oscarmattia/ihp-experiments/circuits/ctle56n/ctle_report.md

# 56 Gb/s NRZ CML CTLE — design report

Auto-generated by `python/generate_reports.py` — do not hand-edit numbers.

## Topology

CML continuous-time linear equalizer (CTLE) for **56 Gb/s NRZ** (Nyquist **28 GHz**).
HBT differential pair (`npn13G2`) with **shunt-peaked loads** (R_D + ideal L from VDD),
**emitter degeneration** (R_s + C_s), and an **LV NMOS tail** with 1:1 diode-connected mirror.

Sizing uses characterization LUTs (`char/bjt`, `char/mos`, `char/passive`) at max-f_T HBT bias.
Load C_L = Miller-aware FO1 VGA input + interconnect (not raw LUT CIN; coil port C excluded).
Bessel shunt-peaking **m = L/(R_D² C_L) ≈ 0.32**.

The drain inductor **L = 81.37 pH** (8.13693e-11 H) is physically tiny (via / short-trace scale).
No PDK spiral is used — minimum EM cell `l2n0` is ~2 nH, far too large. L remains **ideal** in ngspice.

## Targets

- DC gain **−6 … 0 dB** (aim 0 dB)
- Peaking **3–10 dB at 28 GHz**
- CMRR **> 6 dB**, PSRR **> 20 dB** at low frequency
- Transient stimulus: **PRBS9** (x^9+x^5+1), **511 UI** (one full period), **100 mVpp,diff**, ~4.5 ps edges. AC sweep **1 MHz–300 GHz**. CMRR **> 6 dB**, PSRR **> 20 dB**.

## Sizing summary

| Parameter | Symbol | Ideal | PDK | Notes |
| --- | --- | --- | --- | --- |
| Emitter multiplier | Nx | 1 | 1 | HBT LUT index |
| HBT VBE (LUT) | VBE | 0.950 V | 0.950 V | max-fT bias |
| Input common-mode | VBASE | 1.396 V | 1.396 V | inp/inn DC |
| Supply | VDD | 1.600 V | 1.600 V | below BVceo ~1.6 V |
| HBT collector current | Ic | 2.888 mA | 2.888 mA | per side |
| Tail current | I_tail | 2.878 mA | 2.878 mA | Ic per tail (×2 devices) |
| Transition frequency | f_T | 348.80 GHz | 348.80 GHz | LUT at bias |
| Transconductance | g_m | 28.51 mS | 28.51 mS |  |
| Input capacitance | C_in | 10.36 fF | 10.36 fF | HBT CIN |
| Load capacitance | C_L | 33.59 fF | 33.59 fF | Miller + route (no coil port C) |
| Load resistor | R_D | 87.0 Ω | 5.0×1.4 µm | shunt peak |
| Emitter degeneration | R_s | 86.6 Ω | 86.6 Ω |  |
| Degeneration cap | C_s | 183.7 fF | 183.7 fF | ideal or MIM |
| Drain inductor | L | 81.37 pH | 81.37 pH | ideal; VDD→L→R_D→collector; no PDK spiral (l2n0 ~2 nH) |
| Bessel MFD | m | 0.32 | 0.32 | L/(R_D² C_L) |
| MOS tail W/L/VGS | W/L/VGS | 243/1.0/0.550 V | 243/1.0/0.550 V | LV NMOS + mirror |
| RPPD load | W/L | ideal R | 5.0×1.4 µm | LUT ≈ R_D/0.88 |
| DC gain | A_v0 | -0.24 dB | -0.24 dB | −6…0 dB target |
| Peaking @ 28 GHz | — | 5.28 dB | 5.00 dB | 3–10 dB target |
| Peak AC gain | G_peak | 5.04 dB | 4.77 dB |  |
| Peak frequency | f_peak | 27.02 GHz | 26.71 GHz |  |
| −3 dB bandwidth | f_{−3dB} | 79.33 GHz | 78.51 GHz | after peak |
| CMRR | — | 23.09 dB | 23.09 dB | > 6 dB |
| PSRR | — | 120.00 dB | 120.00 dB | > 20 dB (clipped 120 dB) |
| HBT VCE | V_CE | 0.910 V | 0.910 V |  |
| MOS tail VDS | V_DS,tail | 0.439 V | 0.439 V |  |

Plots and waveforms: `out/ideal/` (ideal passives) and `out/pdk/` (PDK R/C passives).
Each pass includes AC PNGs/CSVs, transient CSVs, eye PNGs/CSVs, and SBR when `--no-tran` is not set.
Combined metrics: `out/summary.csv`; per-pass: `out/ideal/metrics.csv`, `out/pdk/metrics.csv`.

## Single-bit response

### Ideal

Waveforms: `out/ideal/sbr.png`, `out/ideal/sbr.csv`, `out/ideal/sbr_taps.csv`.

Isolated **1 UI** NRZ pulse (**100 mVpp,diff**, ±50 mV vid), after **32 UI** settle at logic 0.
Sample **3 pre-cursors + cursor + 10 post-cursors** every UI; drop taps with
|h| < **0.5%** of |cursor| (h_0 always kept).

| Tap | k | h (mV) | h / h_0 | Kept |
| --- | --- | --- | --- | --- |
| h_{-3} pre | -3 | 0.000 | -0.0000 | no |
| h_{-2} pre | -2 | 0.000 | -0.0000 | no |
| h_{-1} pre | -1 | 0.000 | -0.0000 | no |
| **h_0 cursor** | 0 | -163.635 | 1.000 | yes |
| h_1 post | 1 | 43.662 | -0.2668 | yes |
| h_2 post | 2 | 13.504 | -0.0825 | yes |
| h_3 post | 3 | 3.238 | -0.0198 | yes |
| h_4 post | 4 | 0.771 | -0.0047 | no |
| h_5 post | 5 | 0.179 | -0.0011 | no |
| h_6 post | 6 | 0.037 | -0.0002 | no |
| h_7 post | 7 | 0.003 | -0.0000 | no |
| h_8 post | 8 | -0.006 | 0.0000 | no |
| h_9 post | 9 | -0.008 | 0.0000 | no |
| h_10 post | 10 | -0.008 | 0.0000 | no |

- Main cursor h_0 = **-163.64 mV** at t = **0.504 UI** after pulse start
- Normalized total ISI = Σ h_k / h_0 = **-0.3691** (k≠0, kept taps only)
- Σ|h_k|/|h_0| = **0.3691** (same taps)
- Taps with |h| < 0.5% of |cursor| are omitted from the ISI sums.

### PDK

Waveforms: `out/pdk/sbr.png`, `out/pdk/sbr.csv`, `out/pdk/sbr_taps.csv`.

Isolated **1 UI** NRZ pulse (**100 mVpp,diff**, ±50 mV vid), after **32 UI** settle at logic 0.
Sample **3 pre-cursors + cursor + 10 post-cursors** every UI; drop taps with
|h| < **0.5%** of |cursor| (h_0 always kept).

| Tap | k | h (mV) | h / h_0 | Kept |
| --- | --- | --- | --- | --- |
| h_{-3} pre | -3 | 0.000 | -0.0000 | no |
| h_{-2} pre | -2 | 0.000 | -0.0000 | no |
| h_{-1} pre | -1 | 0.000 | -0.0000 | no |
| **h_0 cursor** | 0 | -157.975 | 1.000 | yes |
| h_1 post | 1 | 40.611 | -0.2571 | yes |
| h_2 post | 2 | 11.976 | -0.0758 | yes |
| h_3 post | 3 | 2.431 | -0.0154 | yes |
| h_4 post | 4 | 0.492 | -0.0031 | no |
| h_5 post | 5 | 0.097 | -0.0006 | no |
| h_6 post | 6 | 0.015 | -0.0001 | no |
| h_7 post | 7 | -0.002 | 0.0000 | no |
| h_8 post | 8 | -0.006 | 0.0000 | no |
| h_9 post | 9 | -0.007 | 0.0000 | no |
| h_10 post | 10 | -0.007 | 0.0000 | no |

- Main cursor h_0 = **-157.98 mV** at t = **0.504 UI** after pulse start
- Normalized total ISI = Σ h_k / h_0 = **-0.3483** (k≠0, kept taps only)
- Σ|h_k|/|h_0| = **0.3483** (same taps)
- Taps with |h| < 0.5% of |cursor| are omitted from the ISI sums.

## Post-layout comparison

Extracted from the laid-out cell, simulated through the same testbenches as the
schematic because the CTLE is a device-only cell with the same seven pins. Both
flows take their devices from the LVS extraction; only the Magic flow carries
interconnect capacitance.

The lumped output load differs between them **by design**: a netlist that carries
its own extracted routing takes the `CL_MILLER` term only, while one without
parasitics takes the full `CL`, since otherwise the routing is either counted twice
or not at all. Each netlist declares which it needs.

| Metric | Schematic (PDK) | devices only | devices + extracted C |
| --- | --- | --- | --- |
| _lumped output load_ | full CL | full CL | CL_MILLER |
| DC gain | -0.24 dB | -0.24 dB | -0.24 dB |
| Peaking @ 28 GHz | 5.00 dB | 4.93 dB | 5.06 dB |
| Peak gain | 4.77 dB | 4.70 dB | 4.84 dB |
| f_peak | 26.71 GHz | 27.34 GHz | 25.81 GHz |
| f_-3dB | 78.51 GHz | 79.35 GHz | 81.23 GHz |
| CMRR | 23.09 dB | 23.09 dB | 23.09 dB |
| V_CE | 0.910 V | 0.910 V | 0.910 V |
| I_C | 2.888 mA | 2.888 mA | 2.888 mA |

| Flow | Devices | Parasitic C | Kept | Dropped |
| --- | --- | --- | --- | --- |
| `klayout` | 8 | 0 | 0.00 fF | 0.00 fF |
| `magic` | 8 | 31 | 469.42 fF | 3.02 fF |

Extraction gates: LVS against the reduced CDL **match**, capacitance physical **yes**.

Two device kinds are replaced by their compact models rather than extracted: the
inductor, because the PDK has no ngspice model for it and Magic sees the spiral as a
DC short, and the metal-finger capacitor, because the extractor's finger geometry is
not the calibrated model. Their nets are promoted to pins and reconnected outside
the extracted core.

Plots and waveforms: `out/postlayout_klayout/`, `out/postlayout_magic/`, same file names as the schematic passes.
