oscarmattia/ihp-experiments/circuits/ctle56n/driver_report.md

# 56 Gb/s NRZ output pad driver — design report

Auto-generated by `python/generate_reports.py` — do not hand-edit numbers.

## Topology

CML shunt-peaked HBT differential pair driving the output bond pad through on-chip **50 Ω/leg**
back-termination (`rsil`), with pad + ESD capacitance inside the DUT. Single LV NMOS tail,
no emitter degeneration. EM-fitted shunt inductor (`ind_shunt_drv`, case `turn1` ~215 pH) for
Butterworth peaking (**m = 0.414**) to the Magic pad-metal load. CTLE/VGA still share
`ind_shunt` at Bessel **m = 0.32**. Schematic `PAD_C` is Magic in-situ metal only (143.56 fF);
ESD junction C stays in the compact models. Layout GDS coil is the same `turn1`
(d = 120 µm). Magic post-layout zeros `PAD_C` and black-boxes the compact L.

## Targets

- Drive **100 Ω differential** pad with shunt peaking **m ≈ 0.414** (Butterworth; on-chip RD ≈ 50 Ω)
- Pad eye margin vs 56G NRZ (400 mVpp target is gain-starved — see MEMORY.md)
- Transient stimulus: **PRBS9** (x^9+x^5+1), **511 UI** (one full period), **100 mVpp,diff**, ~4.5 ps edges. AC sweep **1 MHz–300 GHz**. CMRR **> 6 dB**, PSRR **> 20 dB**.

## Sizing and measurement summary

| Parameter | Symbol | Value | Notes |
| --- | --- | --- | --- |
| Supply | VDD | 1.600 V |  |
| Input CM | VBASE | 1.350 V | from VGA max-gain CM |
| Emitter multiplier | Nx | 2 | HBT LUT index |
| Tail current | I_tail | 8.0 mA | single MOS tail |
| On-chip back-term | R_D | 50.26 Ω/leg | rsil target 50 Ω |
| AC R_eff (SE) | R_eff | 25.0 Ω | parallel w/ 100 Ω load |
| Shunt inductor | L | 214.90 pH | EM turn1 / ind_shunt_drv |
| Pad + ESD C_L | C_L | 194.5 fF/side | Magic pad metal 144 fF + ESD 51 fF |
| Butterworth m | m | 0.4375 | target 0.414 |
| Driver Miller C_in | C_in | 37.7 fF | FO2 budget |
| VGA FO2 penalty | BW | -13.4 % | vs standalone VGA |
| DC gain | A_v0 | -0.73 dB |  |
| Gain @ 28 GHz | A_v28 | 0.07 dB |  |
| Peaking @ 28 GHz | — | 0.80 dB |  |
| Peak AC gain | G_peak | 0.68 dB |  |
| Peak frequency | f_peak | 14.51 GHz |  |
| −3 dB bandwidth | f_{−3dB} | 43.67 GHz |  |
| Pad CM | V_pad,CM | 1.384 V |  |
| HBT VCE | V_CE | 0.959 V | per side |
| Return loss DC | RL | 59.31 dB | pad, 100 Ω diff |
| Return loss @ 28 GHz | RL_28G | 15.00 dB |  |
| Pad swing (pp) | — | 123.83 mV | PRBS |
| Pad eye height | — | 100.83 mV |  |
| Pad eye width | — | 0.5550 UI |  |

Plots and waveforms: `out/driver/`.

## Single-bit response

### PDK

Waveforms: `out/driver/sbr.png`, `out/driver/sbr.csv`, `out/driver/sbr_taps.csv`.

Isolated **1 UI** NRZ pulse (**100 mVpp,diff**, ±50 mV vid), after **32 UI** settle at logic 0.
Sample **3 pre-cursors + cursor + 10 post-cursors** every UI; drop taps with
|h| < **0.5%** of |cursor| (h_0 always kept).

| Tap | k | h (mV) | h / h_0 | Kept |
| --- | --- | --- | --- | --- |
| h_{-3} pre | -3 | -0.000 | 0.0000 | no |
| h_{-2} pre | -2 | -0.000 | 0.0000 | no |
| h_{-1} pre | -1 | 0.054 | -0.0005 | no |
| **h_0 cursor** | 0 | -111.415 | 1.000 | yes |
| h_1 post | 1 | 5.533 | -0.0497 | yes |
| h_2 post | 2 | -0.180 | 0.0016 | no |
| h_3 post | 3 | -0.049 | 0.0004 | no |
| h_4 post | 4 | -0.048 | 0.0004 | no |
| h_5 post | 5 | -0.048 | 0.0004 | no |
| h_6 post | 6 | -0.048 | 0.0004 | no |
| h_7 post | 7 | -0.048 | 0.0004 | no |
| h_8 post | 8 | -0.048 | 0.0004 | no |
| h_9 post | 9 | -0.048 | 0.0004 | no |
| h_10 post | 10 | -0.048 | 0.0004 | no |

- Main cursor h_0 = **-111.41 mV** at t = **0.504 UI** after pulse start
- Normalized total ISI = Σ h_k / h_0 = **-0.0497** (k≠0, kept taps only)
- Σ|h_k|/|h_0| = **0.0497** (same taps)
- Taps with |h| < 0.5% of |cursor| are omitted from the ISI sums.

## Post-layout comparison

Extracted from the laid-out cell, simulated through the same testbenches as the
schematic because the pad driver is a device-only cell with the same seven pins.
Both flows take their devices from the LVS extraction; only the Magic flow
carries interconnect and pad-metal capacitance. The Magic netlist therefore
drops the testbench ``PAD_C`` so the extracted pad is not counted twice.

| Metric | Schematic (PDK) | devices only | devices + extracted C |
| --- | --- | --- | --- |
| _pad / output load_ | TB PAD_C | TB PAD_C | PAD_C = 0 |
| DC gain | -0.73 dB | -0.73 dB | -0.73 dB |
| Gain @ 28 GHz | 0.07 dB | 0.07 dB | -0.14 dB |
| Peaking @ 28 GHz | 0.80 dB | 0.80 dB | 0.59 dB |
| Peak gain | 0.68 dB | 0.68 dB | 0.59 dB |
| f_peak | 14.51 GHz | 14.51 GHz | 11.00 GHz |
| f_-3dB | 43.67 GHz | 43.67 GHz | 42.16 GHz |
| HBT VCE | 0.959 V | 0.959 V | 0.959 V |
| Pad CM | 1.384 V | 1.384 V | 1.384 V |
| Return loss DC | 59.31 dB | 59.31 dB | 41.05 dB |
| Return loss @ 28 GHz | 15.00 dB | 15.00 dB | 13.81 dB |
| Pad eye height | 100.83 mV | 100.83 mV | 100.83 mV |
| Pad eye width | 0.5550 UI | 0.5550 UI | 0.6000 UI |

| Flow | Devices | Parasitic C | Kept | Dropped |
| --- | --- | --- | --- | --- |
| `klayout` | 11 | 0 | 0.00 fF | 0.00 fF |
| `magic` | 11 | 19 | 842.22 fF | 0.76 fF |

Extraction gates: LVS against the reduced CDL **match**, capacitance physical **yes**.

The shunt coils are replaced by the EM-fitted ``ind_shunt`` compact model; ESD
diodes and the rail clamp stay in the extracted core.

The old 91 → 35 GHz drop was extra C on the pad node, not a missing ESD
device. Both netlists instantiate the ``diodevdd_2kv`` / ``diodevss_2kv``
pair (50.9 fF). Schematic ``PAD_C`` is now the Magic in-situ metal
(143.56 fF); ``C_L`` ≈ 194 fF/side. Magic's 144 fF ``outp``–``vss`` is
**80 fF from the isolated ``bondpad_70um``** plus **21 fF from the tied ESD
column** plus ~42 fF still in the pad band. Shunt L is Butterworth
``m = 0.414`` → EM ``turn1`` ~215 pH in ``ind_shunt_drv`` (CTLE/VGA stay
Bessel in shared ``ind_shunt``). Layout GDS is the same ``turn1`` pair.
Schematic is **43.7 GHz / +0.07 dB @ 28 GHz**; Magic after the taller
cell is **42.2 GHz / −0.14 dB** (``outp``–``vss`` 152 fF vs the 144 fF
the schematic sizes against). Was 34.9 GHz / −1.67 dB with the 63 pH
coil. Magic keeps 842 fF cell-total, mostly ``mgate`` / ``em``, not
``C_L``. See ``layout/debug_pex/FINDINGS.md``.

Plots and waveforms: `out/postlayout_driver_klayout/`, `out/postlayout_driver_magic/`, same file names as the schematic pass.
