oscarmattia/ihp-experiments/circuits/ctle56n/vga_report.md

# 56 Gb/s NRZ current-steering VGA — design report

Auto-generated by `python/generate_reports.py` — do not hand-edit numbers.

## Topology

HBT CML variable-gain stage (**tail-current steering**): fixed signal pair plus dummy pair
at input common mode, shared shunt-peaked loads, LV NMOS tail. Gain control steers tail
current between signal and dummy branches — **not** variable emitter degeneration
(degeneration is fixed; varying R_s only equalizes, it does not provide flat gain at 28 GHz).

FO2 load: Miller-aware input C of the pad driver ×2 plus interconnect.
Sized DC-coupled to CTLE output CM (**VOUT_CM ≈ 1.35036** from `params.inc`).

## Targets

- Gain range **≥ 10 dB at 28 GHz** (never quoted at DC)
- CMRR **> 6 dB**, PSRR **> 20 dB**
- Transient stimulus: **PRBS9** (x^9+x^5+1), **511 UI** (one full period), **100 mVpp,diff**, ~4.5 ps edges. AC sweep **1 MHz–300 GHz**. CMRR **> 6 dB**, PSRR **> 20 dB**.
Measured **28 GHz small-signal gain range = 11.24 dB** (-6.69 … 4.54 dB) from `out/vga_pdk/gain_vs_vctrl_table.csv`.

## Measurement summary

### Ideal passives

Waveforms: `out/vga_ideal/`.

| Parameter | Symbol | Value | Notes |
| --- | --- | --- | --- |
| DC gain | A_v0 | 0.38 dB | mid VCTRL |
| Gain @ 28 GHz | A_v28 | 0.71 dB | small-signal AC |
| Peaking @ 28 GHz | — | 0.33 dB | vs DC |
| Peak AC gain | G_peak | 1.38 dB |  |
| Peak frequency | f_peak | 796.4 MHz |  |
| −3 dB bandwidth | f_{−3dB} | 63.28 GHz |  |
| CMRR | — | 35.00 dB | > 6 dB |
| PSRR | — | 120.00 dB | > 20 dB |
| HBT VCE | V_CE | 0.947 V | signal pair |
| Tail VDS | V_DS,tail | 0.460 V |  |
| Ic (signal) | I_c | 1.255 mA | per side @ mid VCTRL |
| Tail current | I_tail | 5.750 mA | steered total |

### Ideal passives — SBR

Waveforms: `out/vga_ideal/sbr.png`, `out/vga_ideal/sbr.csv`, `out/vga_ideal/sbr_taps.csv`.

Isolated **1 UI** NRZ pulse (**100 mVpp,diff**, ±50 mV vid), after **32 UI** settle at logic 0.
Sample **3 pre-cursors + cursor + 10 post-cursors** every UI; drop taps with
|h| < **0.5%** of |cursor| (h_0 always kept).

| Tap | k | h (mV) | h / h_0 | Kept |
| --- | --- | --- | --- | --- |
| h_{-3} pre | -3 | -0.000 | 0.0000 | no |
| h_{-2} pre | -2 | -0.000 | 0.0000 | no |
| h_{-1} pre | -1 | 0.107 | -0.0009 | no |
| **h_0 cursor** | 0 | -115.678 | 1.000 | yes |
| h_1 post | 1 | 0.033 | -0.0003 | no |
| h_2 post | 2 | 0.031 | -0.0003 | no |
| h_3 post | 3 | 0.014 | -0.0001 | no |
| h_4 post | 4 | 0.005 | -0.0000 | no |
| h_5 post | 5 | -0.001 | 0.0000 | no |
| h_6 post | 6 | -0.006 | 0.0001 | no |
| h_7 post | 7 | -0.009 | 0.0001 | no |
| h_8 post | 8 | -0.012 | 0.0001 | no |
| h_9 post | 9 | -0.014 | 0.0001 | no |
| h_10 post | 10 | -0.015 | 0.0001 | no |

- Main cursor h_0 = **-115.68 mV** at t = **0.504 UI** after pulse start
- Normalized total ISI = Σ h_k / h_0 = **-0.0000** (k≠0, kept taps only)
- Σ|h_k|/|h_0| = **0.0000** (same taps)
- Taps with |h| < 0.5% of |cursor| are omitted from the ISI sums.

### PDK passives

Waveforms: `out/vga_pdk/`.

| Parameter | Symbol | Value | Notes |
| --- | --- | --- | --- |
| DC gain | A_v0 | 2.76 dB | mid VCTRL |
| Gain @ 28 GHz | A_v28 | 2.11 dB | small-signal AC |
| Peaking @ 28 GHz | — | -0.65 dB | vs DC |
| Peak AC gain | G_peak | 3.64 dB |  |
| Peak frequency | f_peak | 570.3 MHz |  |
| −3 dB bandwidth | f_{−3dB} | 42.51 GHz |  |
| CMRR | — | 35.11 dB | > 6 dB |
| PSRR | — | 120.00 dB | > 20 dB |
| HBT VCE | V_CE | 0.891 V | signal pair |
| Tail VDS | V_DS,tail | 0.460 V |  |
| Ic (signal) | I_c | 1.257 mA | per side @ mid VCTRL |
| Tail current | I_tail | 5.749 mA | steered total |

### PDK passives — SBR

Waveforms: `out/vga_pdk/sbr.png`, `out/vga_pdk/sbr.csv`, `out/vga_pdk/sbr_taps.csv`.

Isolated **1 UI** NRZ pulse (**100 mVpp,diff**, ±50 mV vid), after **32 UI** settle at logic 0.
Sample **3 pre-cursors + cursor + 10 post-cursors** every UI; drop taps with
|h| < **0.5%** of |cursor| (h_0 always kept).

| Tap | k | h (mV) | h / h_0 | Kept |
| --- | --- | --- | --- | --- |
| h_{-3} pre | -3 | -0.000 | 0.0000 | no |
| h_{-2} pre | -2 | -0.000 | 0.0000 | no |
| h_{-1} pre | -1 | 0.021 | -0.0001 | no |
| **h_0 cursor** | 0 | -147.752 | 1.000 | yes |
| h_1 post | 1 | -2.169 | 0.0147 | yes |
| h_2 post | 2 | 0.044 | -0.0003 | no |
| h_3 post | 3 | 0.024 | -0.0002 | no |
| h_4 post | 4 | 0.011 | -0.0001 | no |
| h_5 post | 5 | 0.002 | -0.0000 | no |
| h_6 post | 6 | -0.004 | 0.0000 | no |
| h_7 post | 7 | -0.009 | 0.0001 | no |
| h_8 post | 8 | -0.012 | 0.0001 | no |
| h_9 post | 9 | -0.015 | 0.0001 | no |
| h_10 post | 10 | -0.017 | 0.0001 | no |

- Main cursor h_0 = **-147.75 mV** at t = **0.504 UI** after pulse start
- Normalized total ISI = Σ h_k / h_0 = **0.0147** (k≠0, kept taps only)
- Σ|h_k|/|h_0| = **0.0147** (same taps)
- Taps with |h| < 0.5% of |cursor| are omitted from the ISI sums.

## Post-layout comparison

Extracted from the laid-out cell, simulated through the same testbenches as the
schematic because the VGA is a device-only cell with the same ten pins (including vicm / steerp / steern / mgate). Both
flows take their devices from the LVS extraction; only the Magic flow carries
interconnect capacitance.

The lumped output load differs between them **by design**: a netlist that carries
its own extracted routing takes the `CL_MILLER` term only, while one without
parasitics takes the full `CL`, since otherwise the routing is either counted twice
or not at all. Each netlist declares which it needs.

| Metric | Schematic (PDK) | devices only | devices + extracted C |
| --- | --- | --- | --- |
| _lumped output load_ | full CL | full CL | CL_MILLER |
| DC gain | 2.76 dB | 2.76 dB | 2.76 dB |
| Peaking @ 28 GHz | -0.65 dB | -0.65 dB | -1.16 dB |
| Peak gain | 3.64 dB | 3.64 dB | 3.64 dB |
| f_peak | 570.3 MHz | 570.3 MHz | 514.1 MHz |
| f_-3dB | 42.51 GHz | 42.53 GHz | 35.93 GHz |
| CMRR | 35.11 dB | 35.11 dB | 35.11 dB |
| V_CE | 0.891 V | 0.891 V | 0.891 V |
| I_C | 1.257 mA | 1.257 mA | 1.257 mA |

| Flow | Devices | Parasitic C | Kept | Dropped |
| --- | --- | --- | --- | --- |
| `klayout` | 13 | 0 | 0.00 fF | 0.00 fF |
| `magic` | 13 | 56 | 547.80 fF | 387.64 fF |

Extraction gates: LVS against the reduced CDL **match**, capacitance physical **yes**.

Two device kinds are replaced by their compact models rather than extracted: the
inductor, because the PDK has no ngspice model for it and Magic sees the spiral as a
DC short, and the metal-finger capacitor, because the extractor's finger geometry is
not the calibrated model. Their nets are promoted to pins and reconnected outside
the extracted core.

Plots and waveforms: `out/postlayout_vga_klayout/`, `out/postlayout_vga_magic/`, same file names as the schematic passes.

**Magic C drop (do not "fix" the layout)**

`vga_dut` never labels the dummy-steer collectors `tx1`/`tx2`. Magic
PEX therefore names those Metal2 rails `m2_7492_3498#` and
`m2_36168_2698#` and the C-only rewrite drops them (~80 fF each to
`vss`, plus coupling to `em`/`ed*`). `postlayout_summary.json`
reports **kept 548 fF / dropped 388 fF**. The midband output numbers
above are still usable (the drop is internal-node C, not `C_L`). The
steering-node C is under-counted; do not add labels just to recover
those capacitors.

**Eyes (mid VCTRL, PRBS9)** — devices-only **145.91 mV / 0.505 UI**, Magic **145.92 mV / 0.505 UI**. Phase-invariance passed on both. The Magic bandwidth drop does not close the mid-gain eye.
