oscarmattia/ihp-experiments/circuits/ctle56n/term_report.md

# 56 Gb/s NRZ bond-pad termination — design report

Auto-generated by `python/generate_reports.py` — do not hand-edit numbers.

## Topology

50 Ω per leg (**100 Ω differential**) on-chip termination to an **~1.4 V** common mode.
Bond pad (stacked TM1/TM2), primary ESD (`diodevdd_2kv` + `diodevss_2kv`) with `nmoscl_2` rail clamp,
`rsil` termination resistors, and an `rppd` divider with `cap_cmim` decoupling on the vtt node.

## Targets

- **50 Ω** per leg to on-chip **~1.4 V** common mode
- Return loss and insertion loss characterized to **28 GHz** (Nyquist)
- Transient stimulus: **PRBS9** (x^9+x^5+1), **511 UI** (one full period), **100 mVpp,diff**, ~4.5 ps edges. AC sweep **1 MHz–300 GHz**. CMRR **> 6 dB**, PSRR **> 20 dB**.

## Sizing and measurement summary

| Parameter | Symbol | Value | Notes |
| --- | --- | --- | --- |
| Supply | VDD | 1.600 V | shared 1.6 V rail |
| On-chip CM | vtt | 1.396 V | CTLE input target |
| Input CM | VBASE | 1.396 V | bond pad / divider |
| Bond pad | W×L | 70×70 µm | TM1 bottom plate C |
| Pad C | C_pad | 27.68 fF/side | substrate |
| Termination R | R_term | 50.26 Ω/leg | rsil 0.5×2.35 µm |
| VTT divider top | R_top | 199.4 Ω | rppd |
| VTT divider bottom | R_bot | 1362.4 Ω | rppd |
| Divider current | I_div | 1.024 mA |  |
| ESD leak | I_ESD | 1.19 pA | diode pair @ pad |
| Shunt C (diff) | C_sh | 39.3 fF | pad+ESD to vtt |
| Extracted C (diff) | C_ext | 45.9 fF | from Zin fit |
| Insertion loss DC | IL | -6.00 dB | 50 Ω source → pad |
| Insertion loss @ 28 GHz | IL_28G | -6.68 dB |  |
| IL −3 dB BW | f_IL | 67.78 GHz |  |
| Return loss DC | S11 | -51.89 dB | 100 Ω diff ref |
| Return loss @ 28 GHz | S11_28G | -18.21 dB |  |
| S11 −10 dB BW | f_S11 | 57.34 GHz |  |
| Zin −3 dB | f_Zin | 34.67 GHz |  |
| SBR cursor | h_0 | 50.06 mV | 1 UI pulse |
| SBR ISI (norm) | Σh/h_0 | 0.0000 | kept taps |

Plots and waveforms: `out/term/` (`zin.png`, `ac_diff`, PRBS transient, eye, SBR).

## Single-bit response

### PDK

Waveforms: `out/term/sbr.png`, `out/term/sbr.csv`, `out/term/sbr_taps.csv`.

Isolated **1 UI** NRZ pulse (**100 mVpp,diff**, ±50 mV vid), after **32 UI** settle at logic 0.
Sample **3 pre-cursors + cursor + 10 post-cursors** every UI; drop taps with
|h| < **0.5%** of |cursor| (h_0 always kept).

| Tap | k | h (mV) | h / h_0 | Kept |
| --- | --- | --- | --- | --- |
| h_{-3} pre | -3 | 0.000 | 0.0000 | no |
| h_{-2} pre | -2 | 0.000 | 0.0000 | no |
| h_{-1} pre | -1 | 0.000 | 0.0000 | no |
| **h_0 cursor** | 0 | 50.059 | 1.000 | yes |
| h_1 post | 1 | 0.069 | 0.0014 | no |
| h_2 post | 2 | 0.000 | 0.0000 | no |
| h_3 post | 3 | 0.000 | 0.0000 | no |
| h_4 post | 4 | 0.000 | 0.0000 | no |
| h_5 post | 5 | 0.000 | 0.0000 | no |
| h_6 post | 6 | 0.000 | 0.0000 | no |
| h_7 post | 7 | 0.000 | 0.0000 | no |
| h_8 post | 8 | 0.000 | 0.0000 | no |
| h_9 post | 9 | 0.000 | 0.0000 | no |
| h_10 post | 10 | 0.000 | 0.0000 | no |

- Main cursor h_0 = **50.06 mV** at t = **0.504 UI** after pulse start
- Normalized total ISI = Σ h_k / h_0 = **0.0000** (k≠0, kept taps only)
- Σ|h_k|/|h_0| = **0.0000** (same taps)
- Taps with |h| < 0.5% of |cursor| are omitted from the ISI sums.
