oscarmattia/ihp-experiments/char/bjt/out/beta_comparison.png

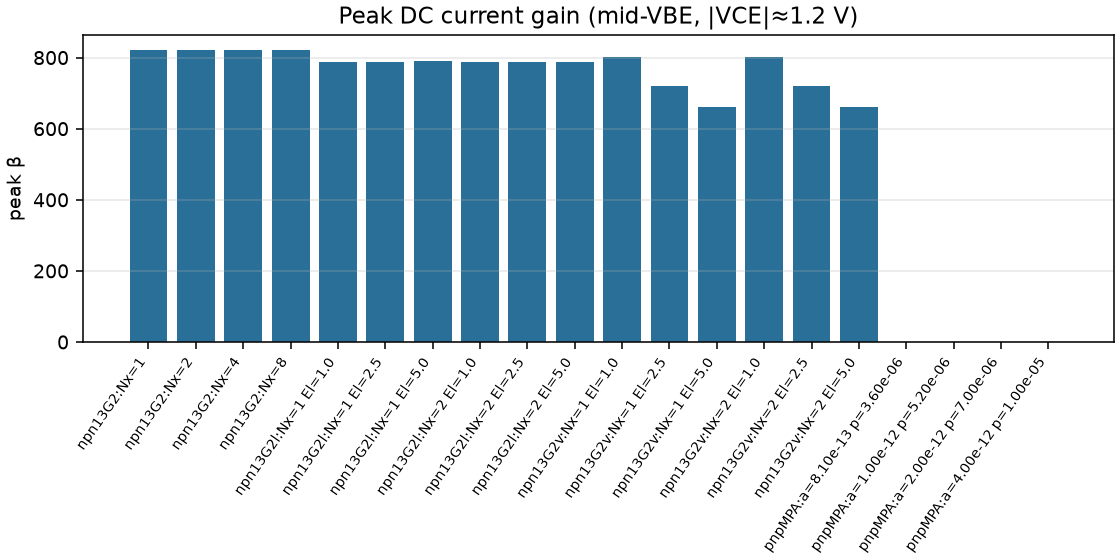
char/bjt/out/beta_comparison.png
