oscarmattia/ihp-experiments/char/bjt/out/npn13G2_ft.png

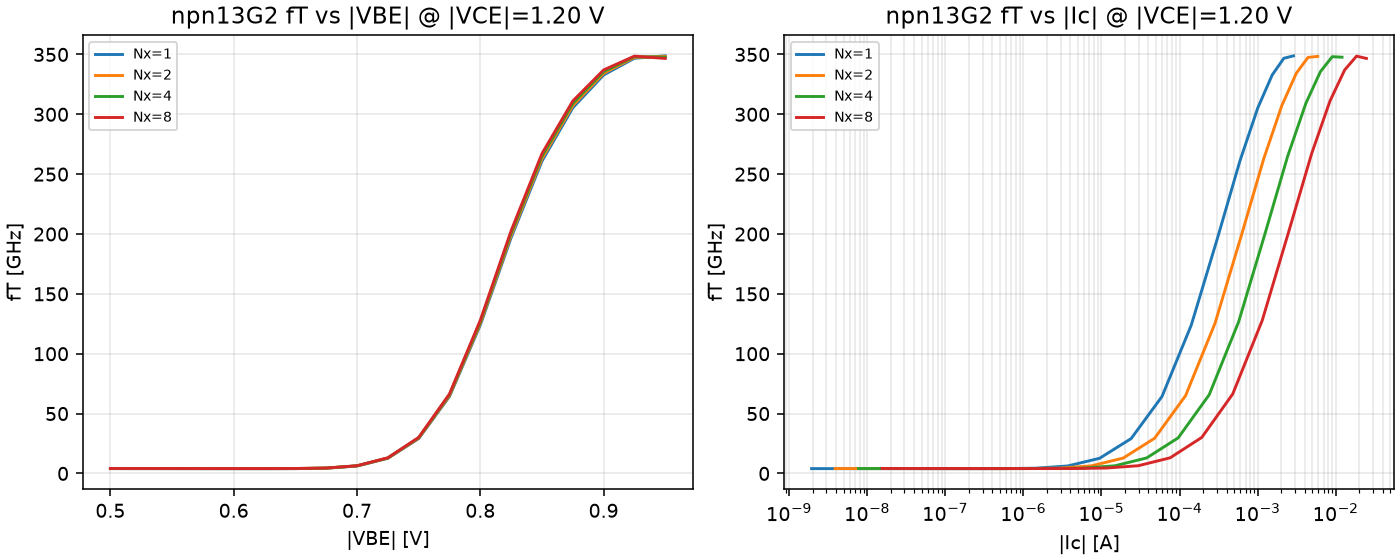
char/bjt/out/npn13G2_ft.png
