oscarmattia/ihp-experiments/char/bjt/out/npn13G2_gummel.png

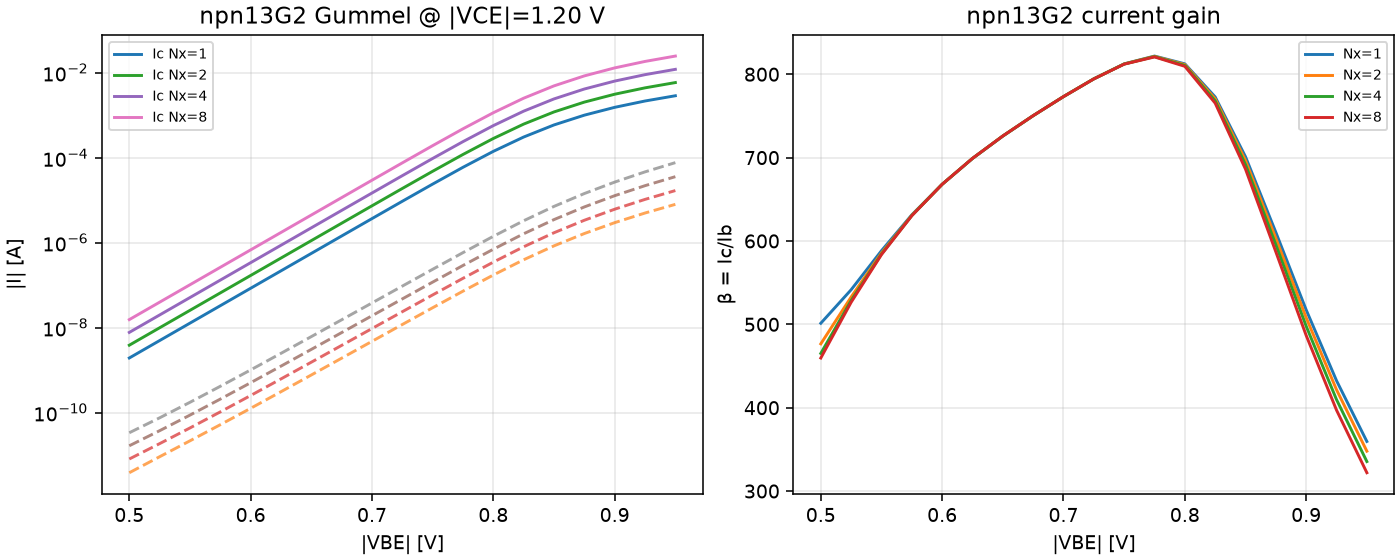
char/bjt/out/npn13G2_gummel.png
