oscarmattia/ihp-experiments/char/bjt/out/npn13G2l_ft.png

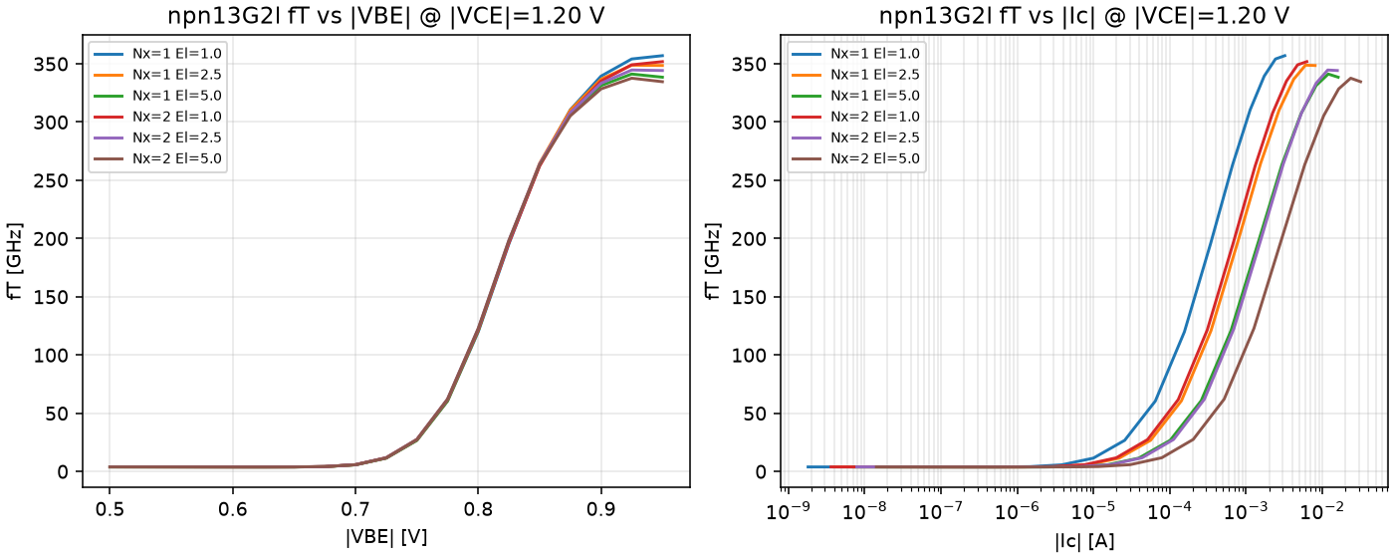
char/bjt/out/npn13G2l_ft.png
