oscarmattia/ihp-experiments/char/bjt/out/npn13G2l_gummel.png

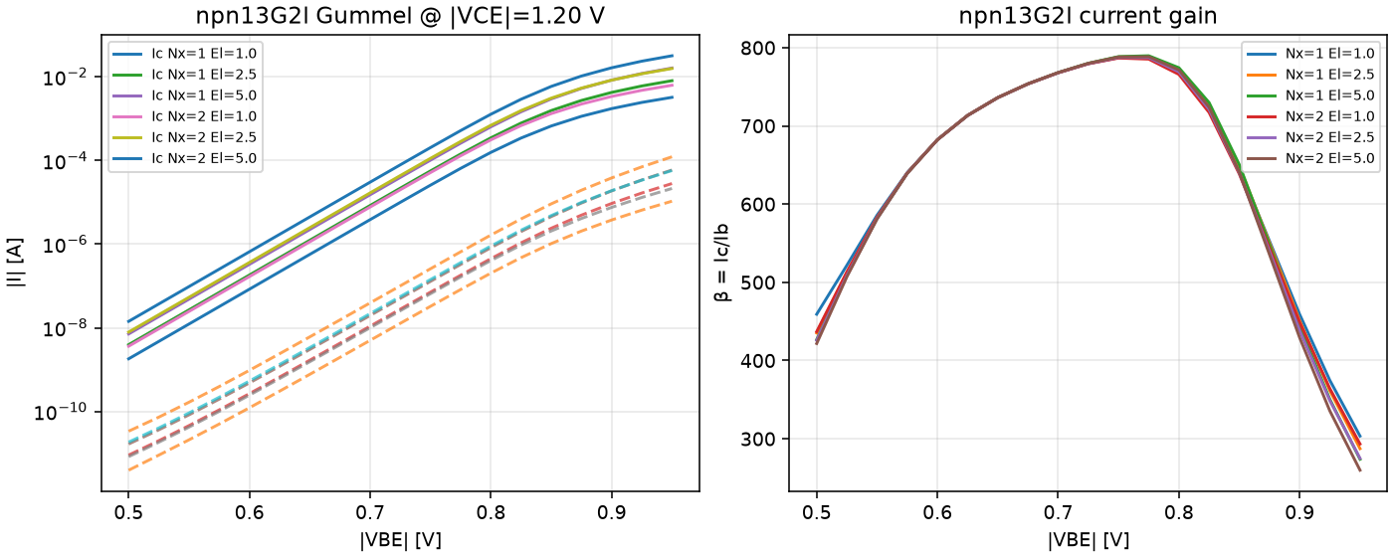
char/bjt/out/npn13G2l_gummel.png
