oscarmattia/ihp-experiments/char/bjt/out/npn13G2v_ft.png

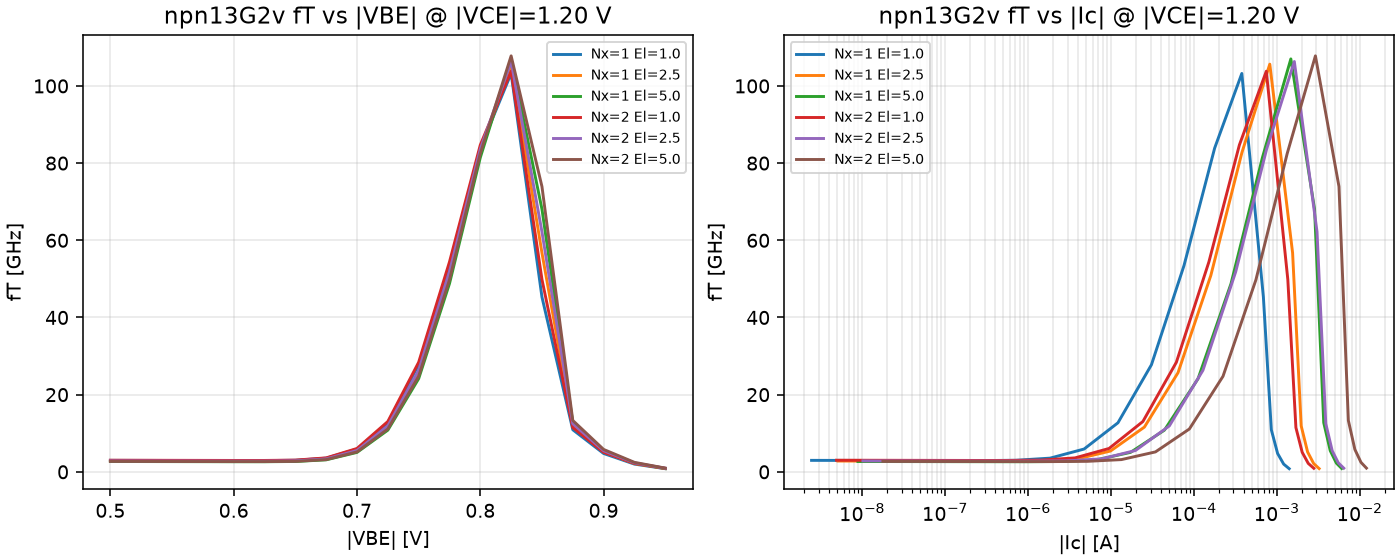
char/bjt/out/npn13G2v_ft.png
