oscarmattia/ihp-experiments/char/bjt/out/npn13G2v_gummel.png

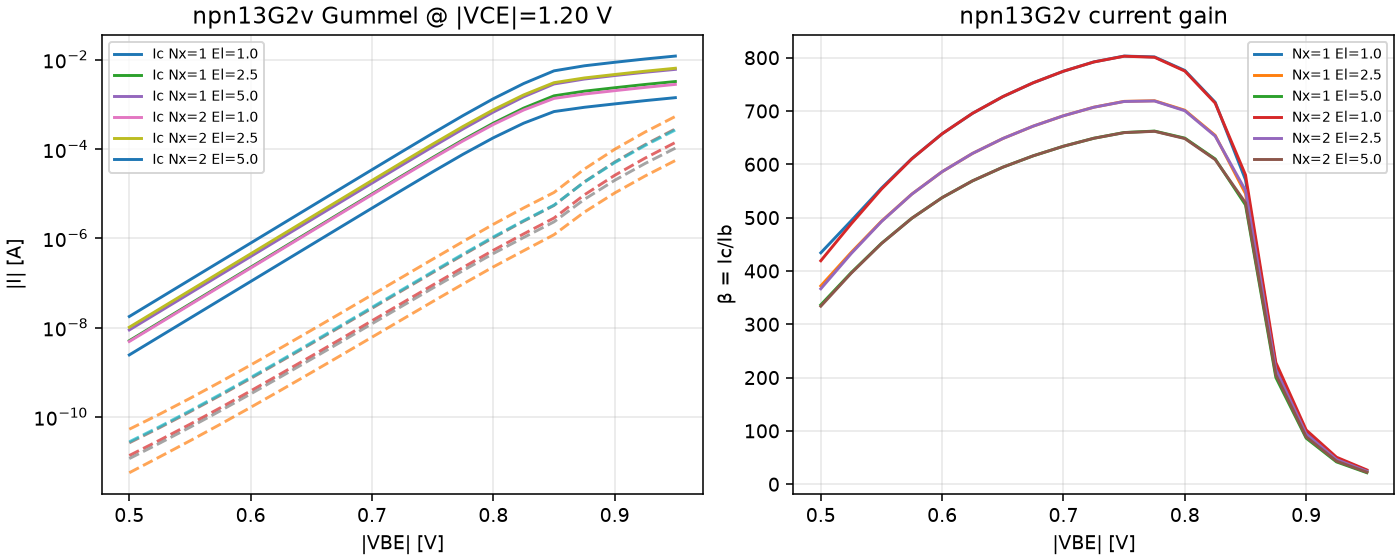
char/bjt/out/npn13G2v_gummel.png
