oscarmattia/ihp-experiments/char/bjt/out/pnpMPA_gummel.png

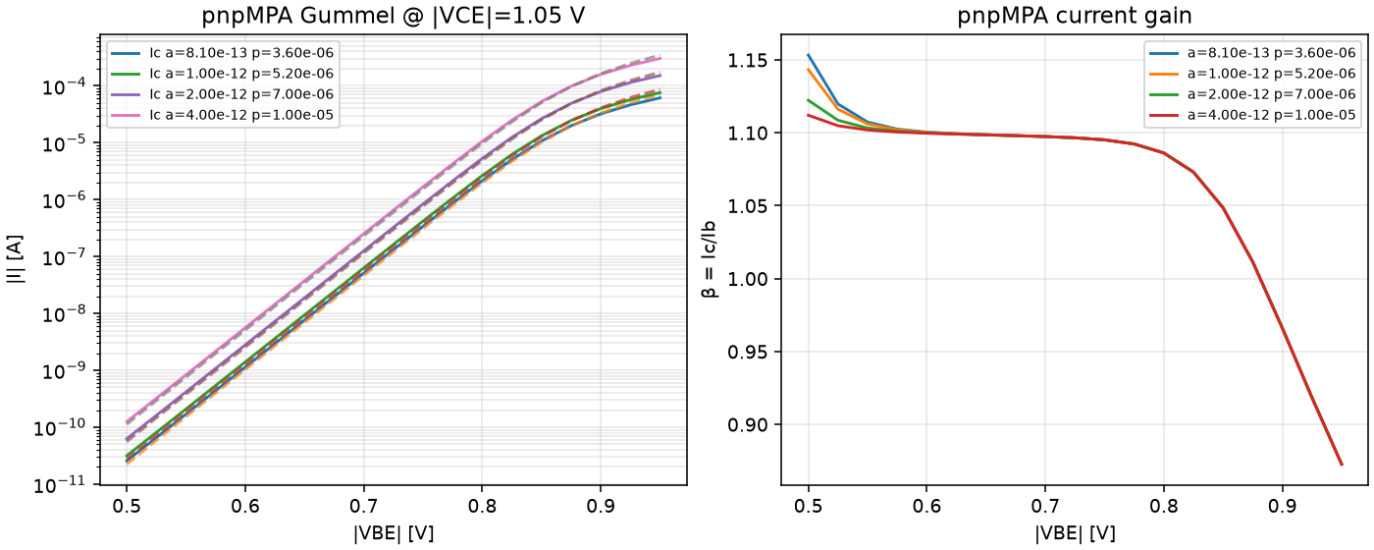
char/bjt/out/pnpMPA_gummel.png
