oscarmattia/ihp-experiments/char/mos/out/hv_core_gm_id.png

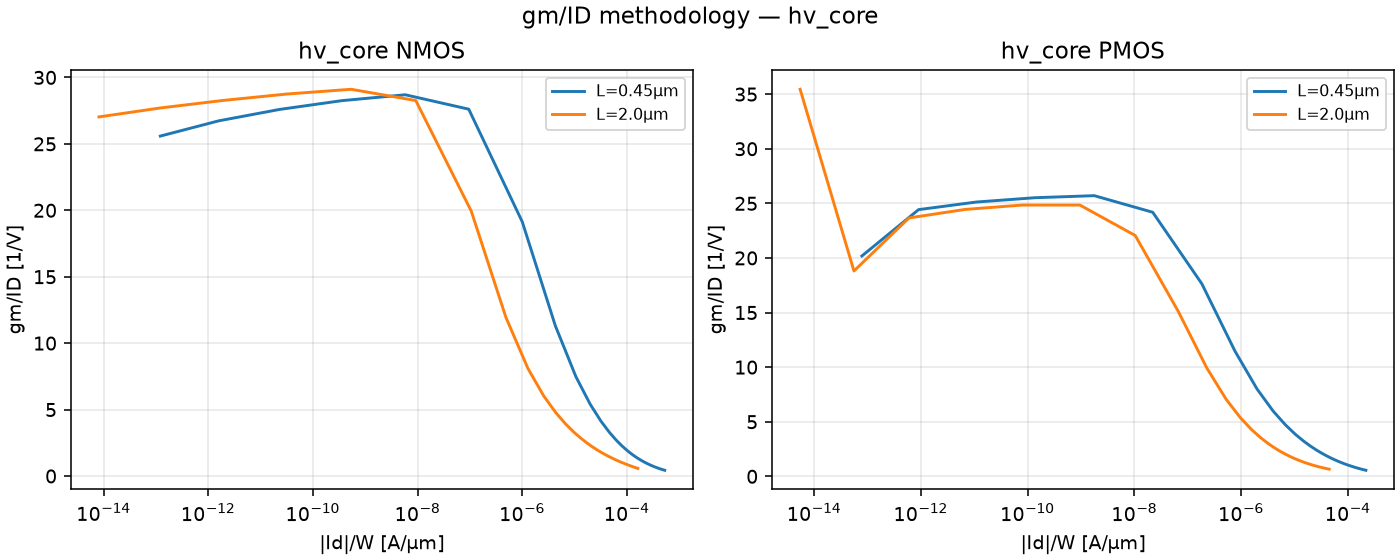
char/mos/out/hv_core_gm_id.png
