oscarmattia/ihp-experiments/char/mos/out/hv_core_idvg.png

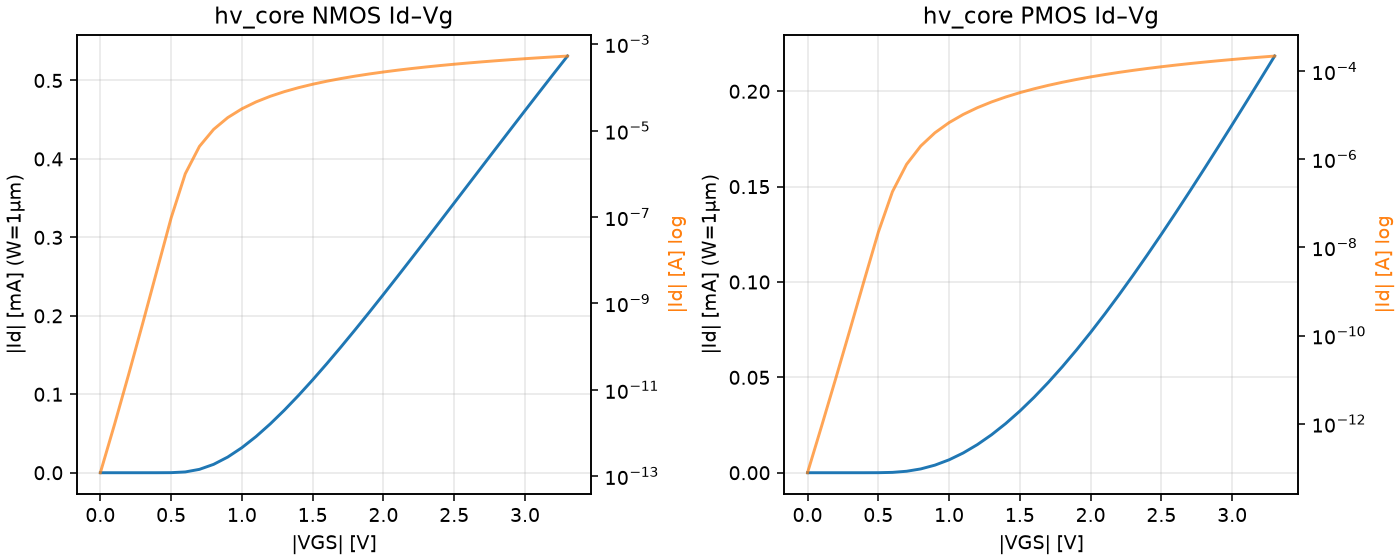
char/mos/out/hv_core_idvg.png
