oscarmattia/ihp-experiments/char/mos/out/lv_rf_gm_id.png

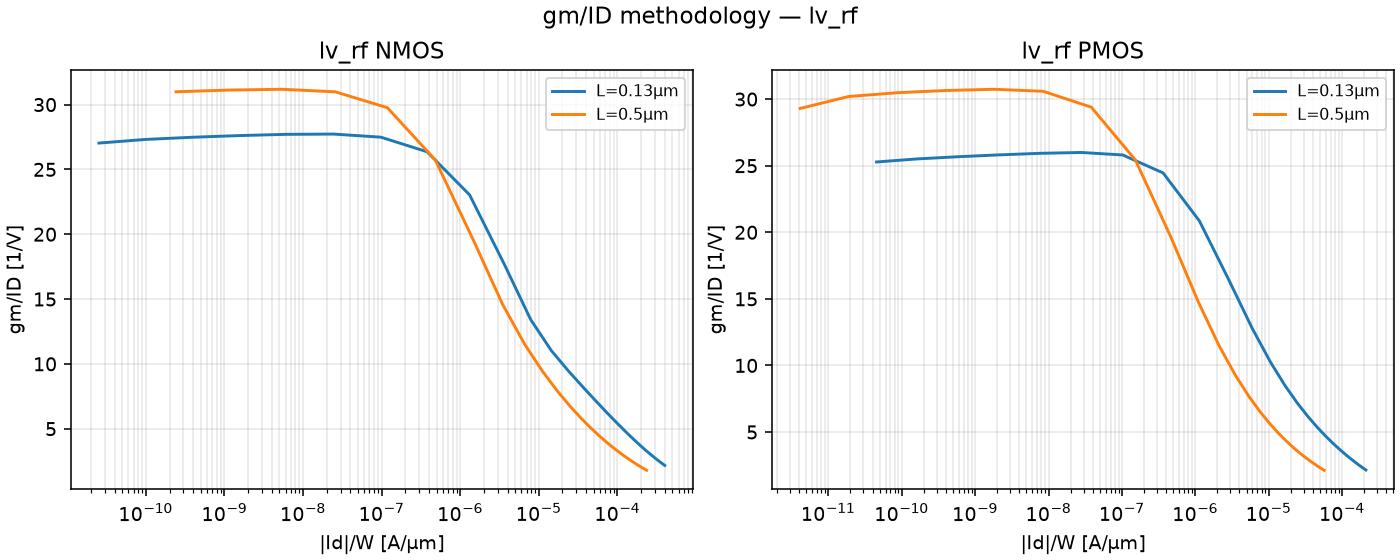
char/mos/out/lv_rf_gm_id.png
