oscarmattia/ihp-experiments/char/mos/out/vth_comparison.png

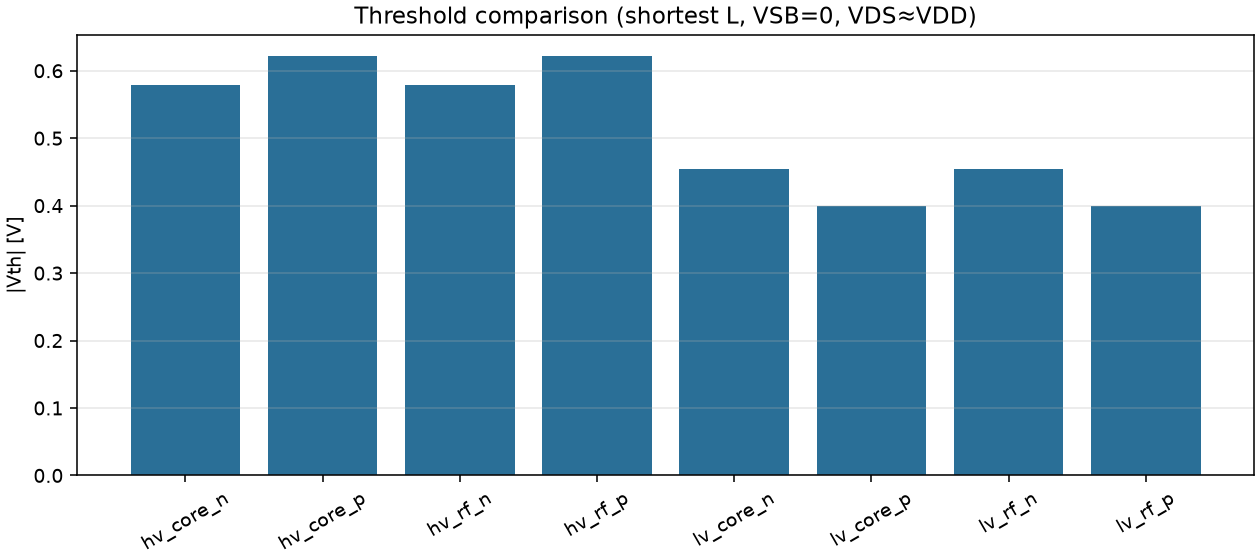
char/mos/out/vth_comparison.png
