oscarmattia/ihp-experiments/char/passive/out/cap_cmim_c_vs_area.png

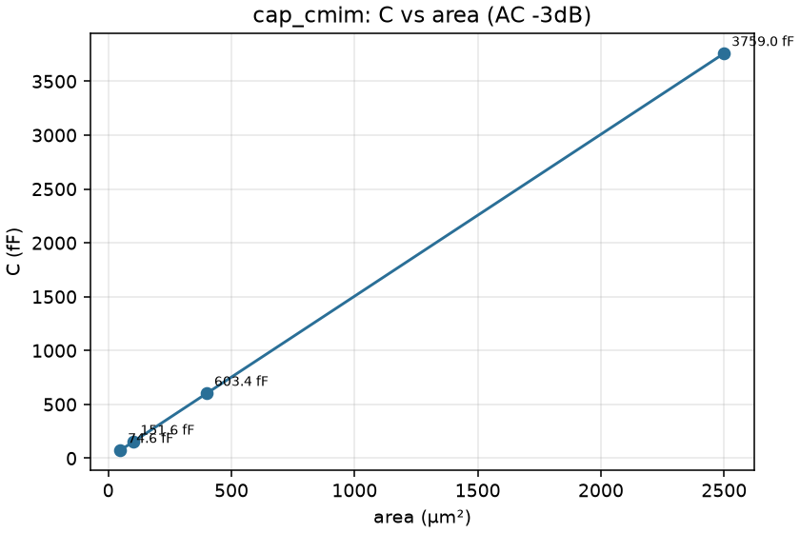
char/passive/out/cap_cmim_c_vs_area.png
