oscarmattia/ihp-experiments/char/passive/out/cap_density_comparison.png

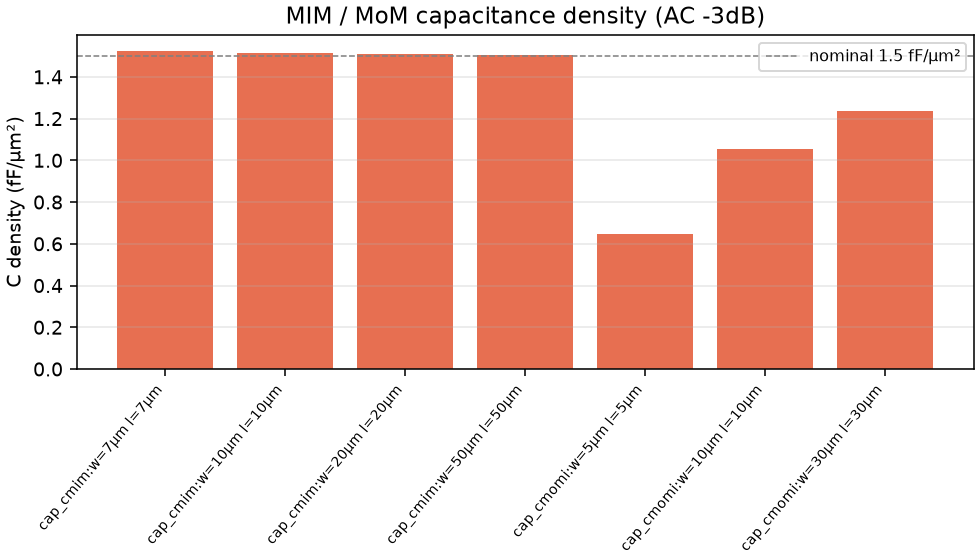
char/passive/out/cap_density_comparison.png
