oscarmattia/ihp-experiments/char/passive/out/ind_l2n0_LQ.png

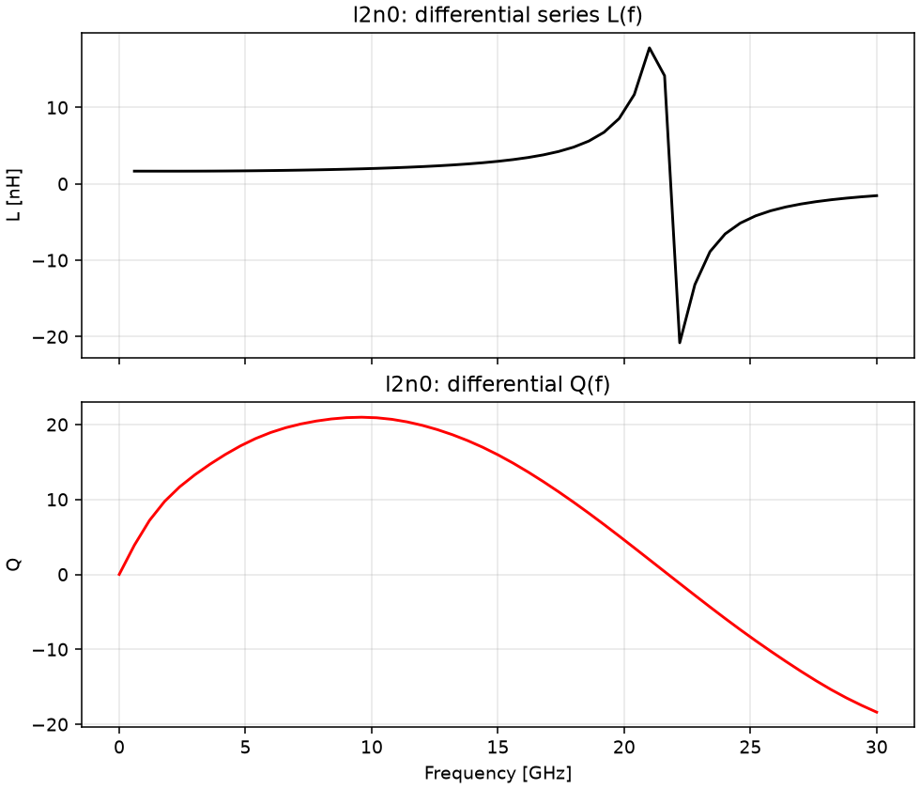
char/passive/out/ind_l2n0_LQ.png
