oscarmattia/ihp-experiments/char/passive/out/ind_turn1_d40_LQ.png

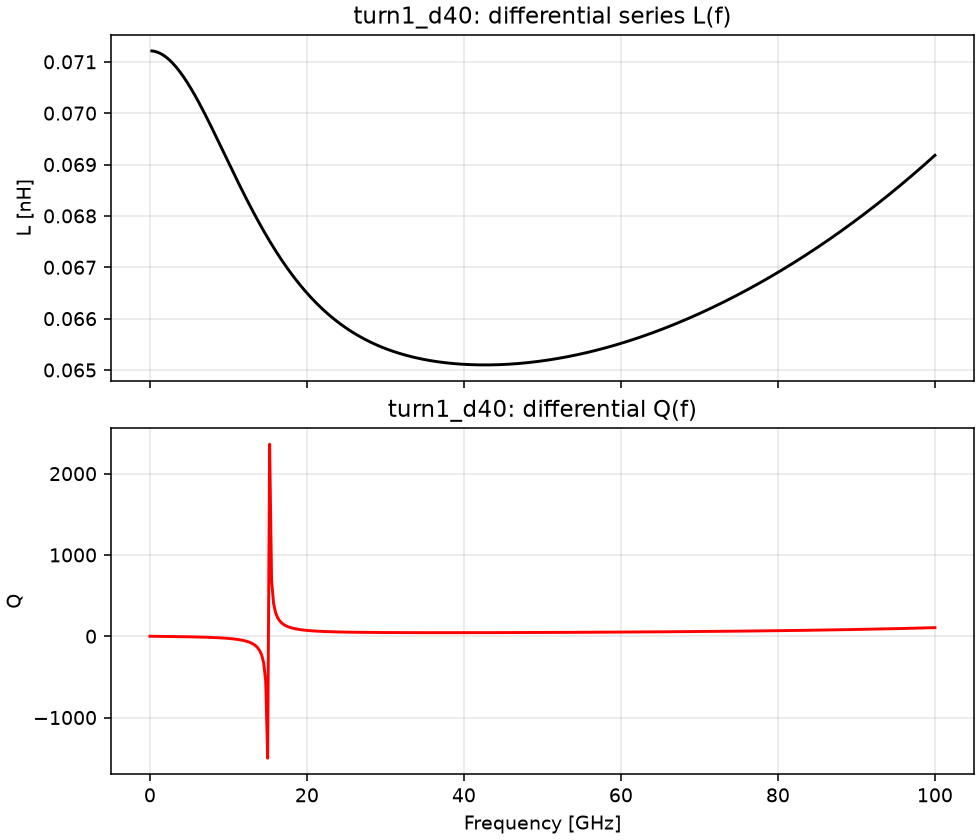
char/passive/out/ind_turn1_d40_LQ.png
