oscarmattia/ihp-experiments/char/passive/out/ind_turn1_d60_LQ.png

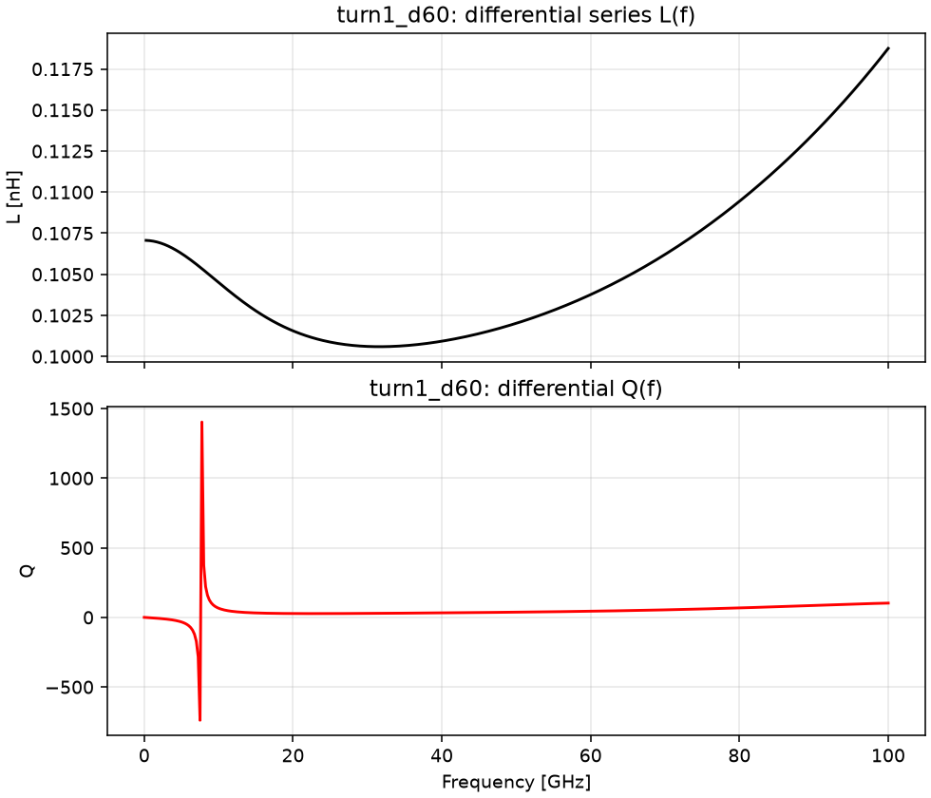
char/passive/out/ind_turn1_d60_LQ.png
