oscarmattia/ihp-experiments/char/passive/out/ind_turn1_LQ.png

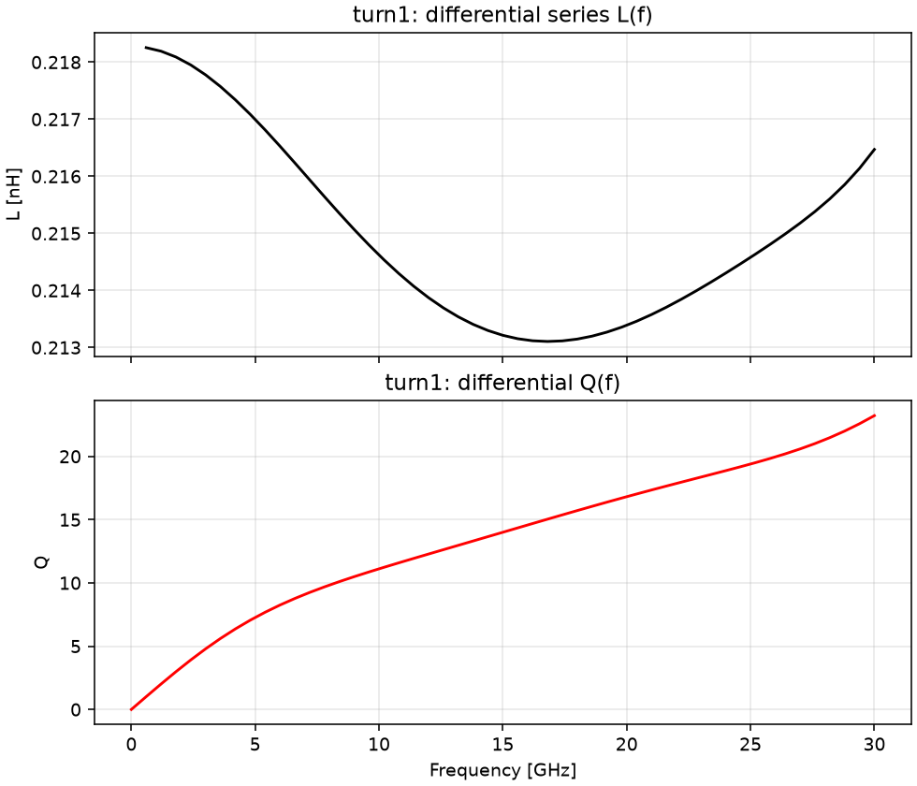
char/passive/out/ind_turn1_LQ.png
