oscarmattia/ihp-experiments/char/passive/out/ind_turn2_LQ.png

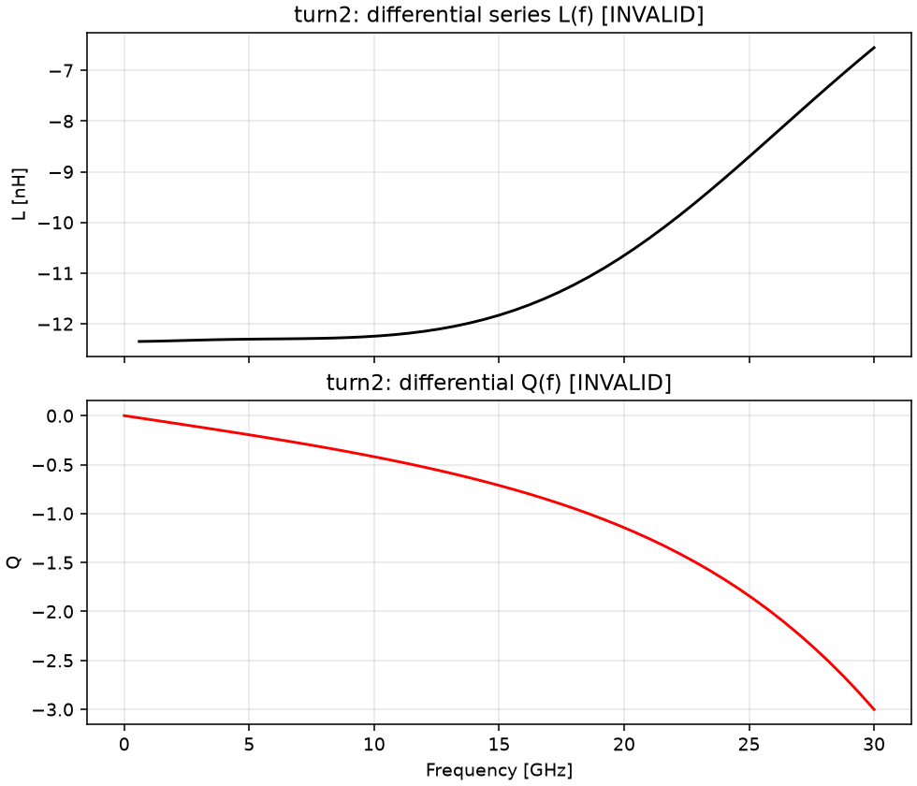
char/passive/out/ind_turn2_LQ.png
