oscarmattia/ihp-experiments/char/passive/out/moscap_n_cv.png

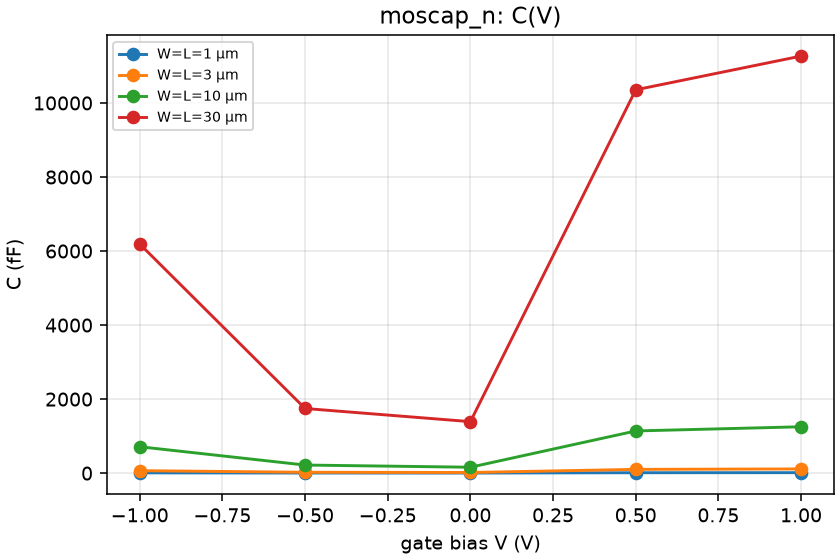
char/passive/out/moscap_n_cv.png
