oscarmattia/ihp-experiments/char/passive/out/moscap_p_cv.png

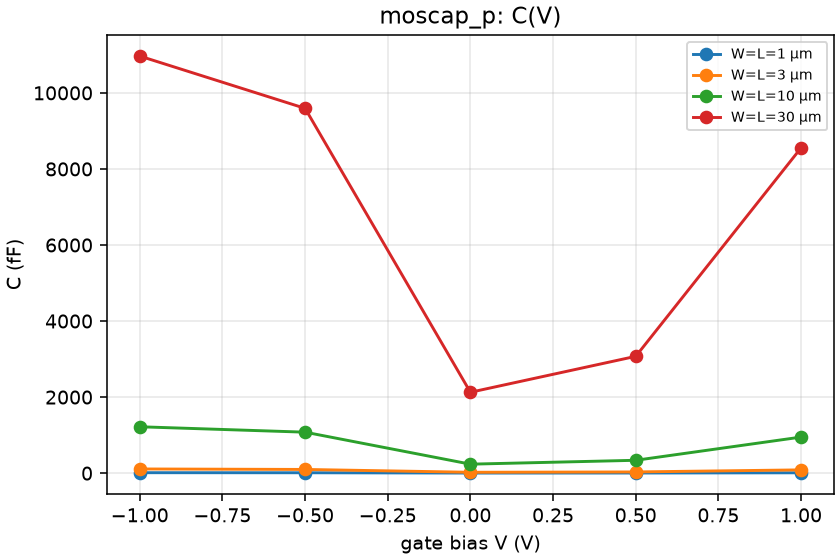
char/passive/out/moscap_p_cv.png
