oscarmattia/ihp-experiments/char/passive/out/rhigh_r_vs_l_27C.png

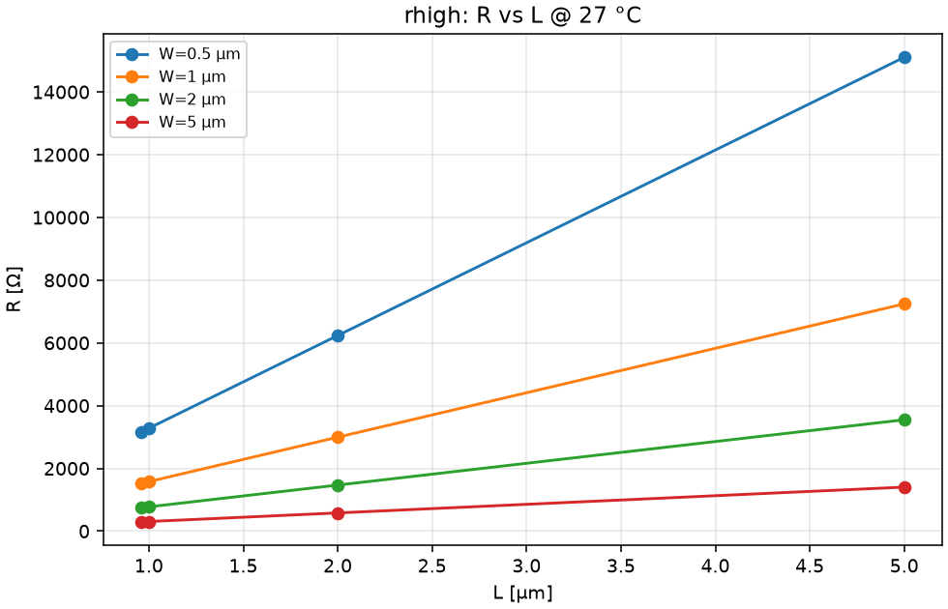
char/passive/out/rhigh_r_vs_l_27C.png
