oscarmattia/ihp-experiments/char/passive/out/rhigh_r_vs_temp_midgeo.png

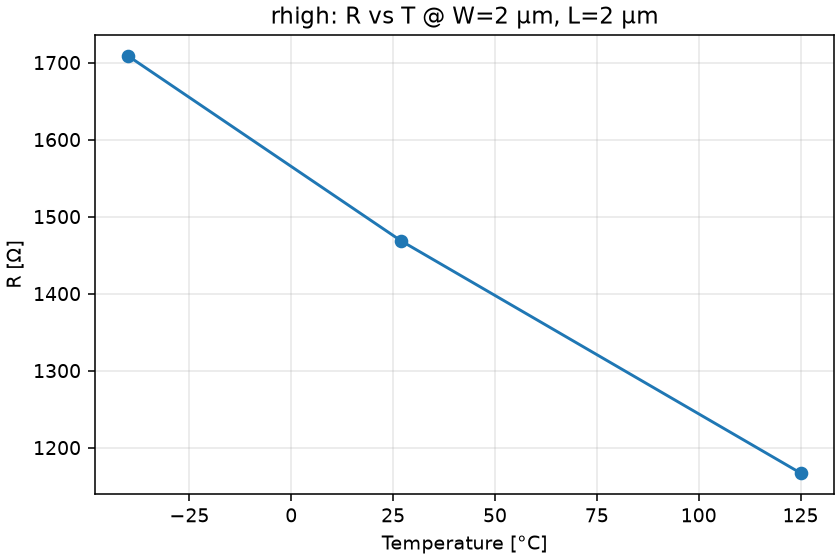
char/passive/out/rhigh_r_vs_temp_midgeo.png
