oscarmattia/ihp-experiments/char/passive/out/rppd_r_vs_l_27C.png

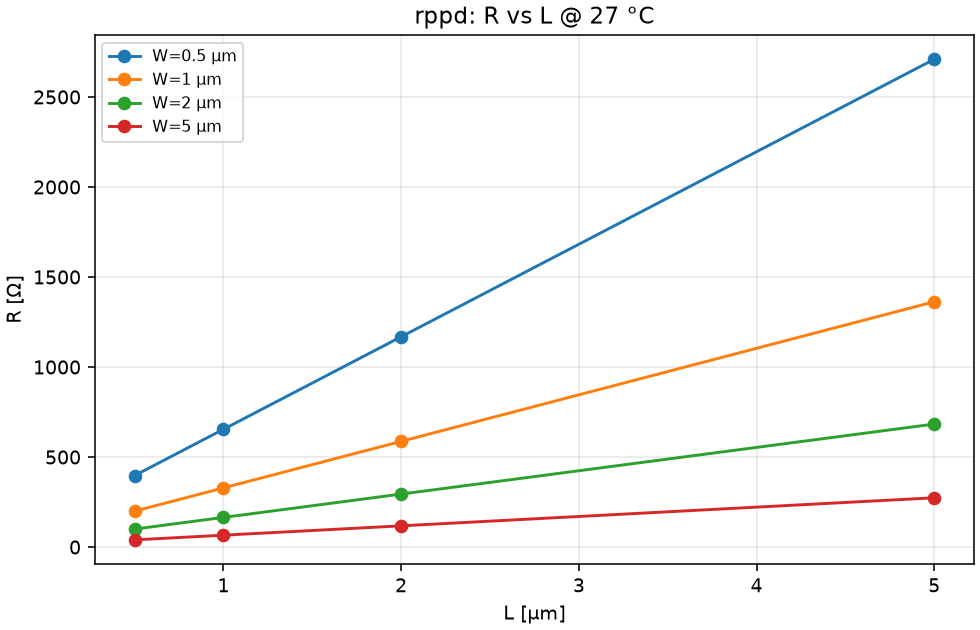
char/passive/out/rppd_r_vs_l_27C.png
