oscarmattia/ihp-experiments/char/passive/out/rsil_r_vs_l_27C.png

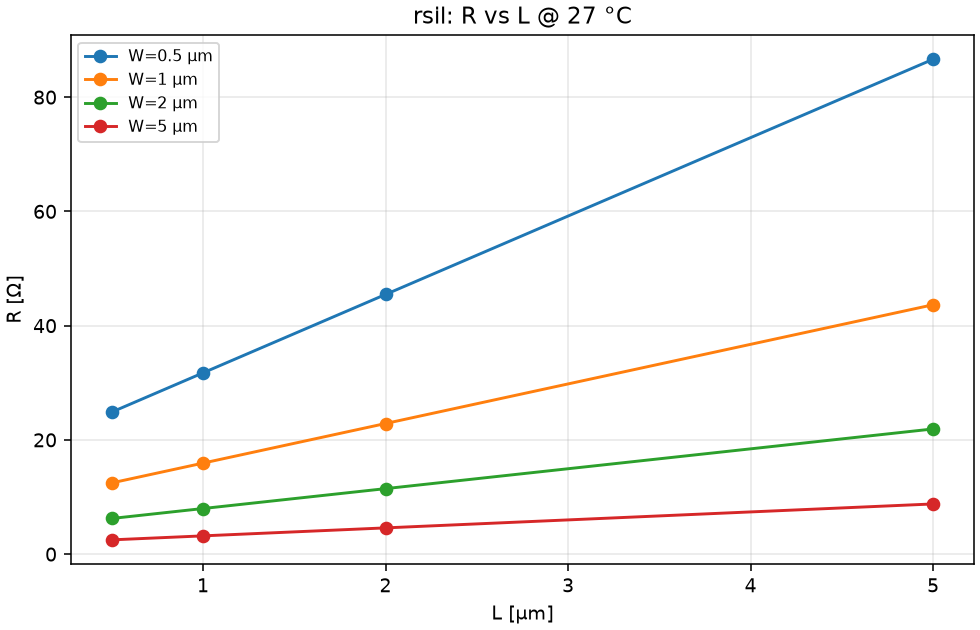
char/passive/out/rsil_r_vs_l_27C.png
