oscarmattia/ihp-experiments/char/passive/out/rsil_r_vs_temp_midgeo.png

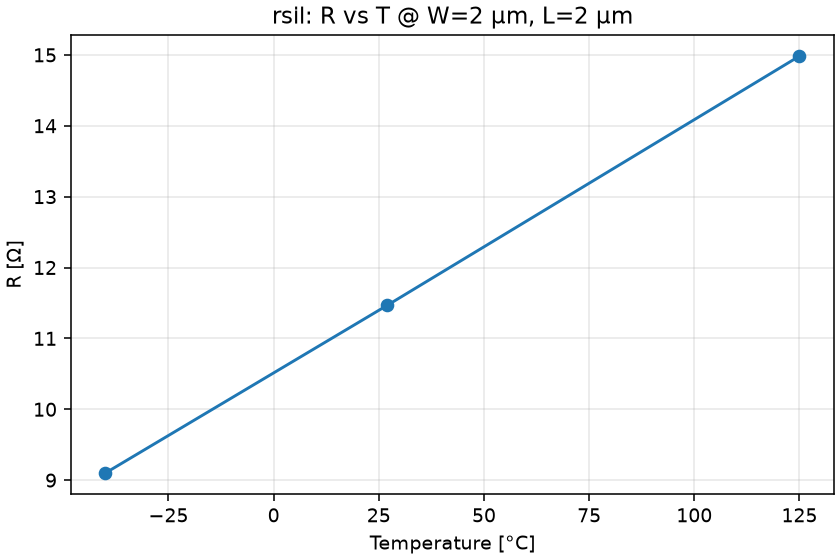
char/passive/out/rsil_r_vs_temp_midgeo.png
