oscarmattia/ihp-experiments/circuits/ctle56n/out/chain/ac_diff_max.png

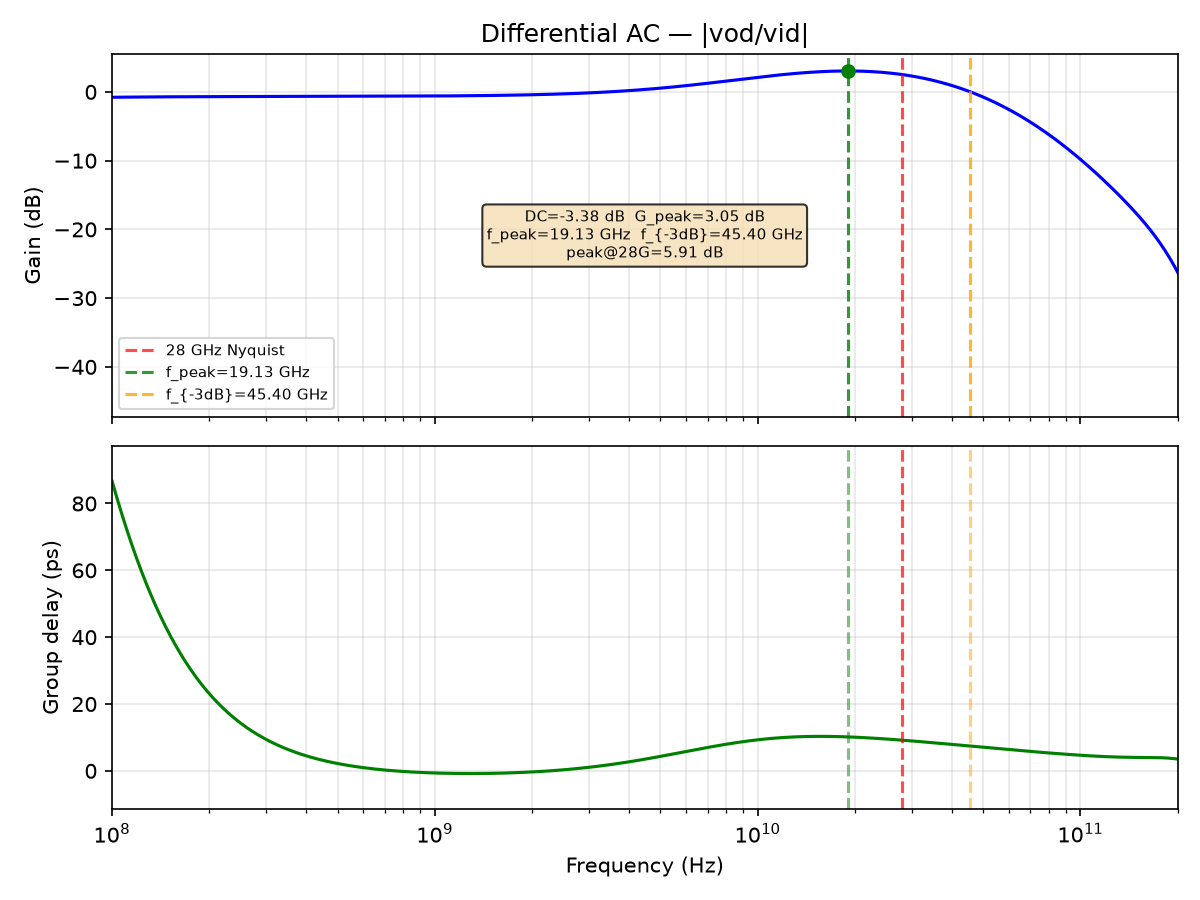
circuits/ctle56n/out/chain/ac_diff_max.png
