oscarmattia/ihp-experiments/circuits/ctle56n/out/chain/chain_perstg/ac_diff_min.png

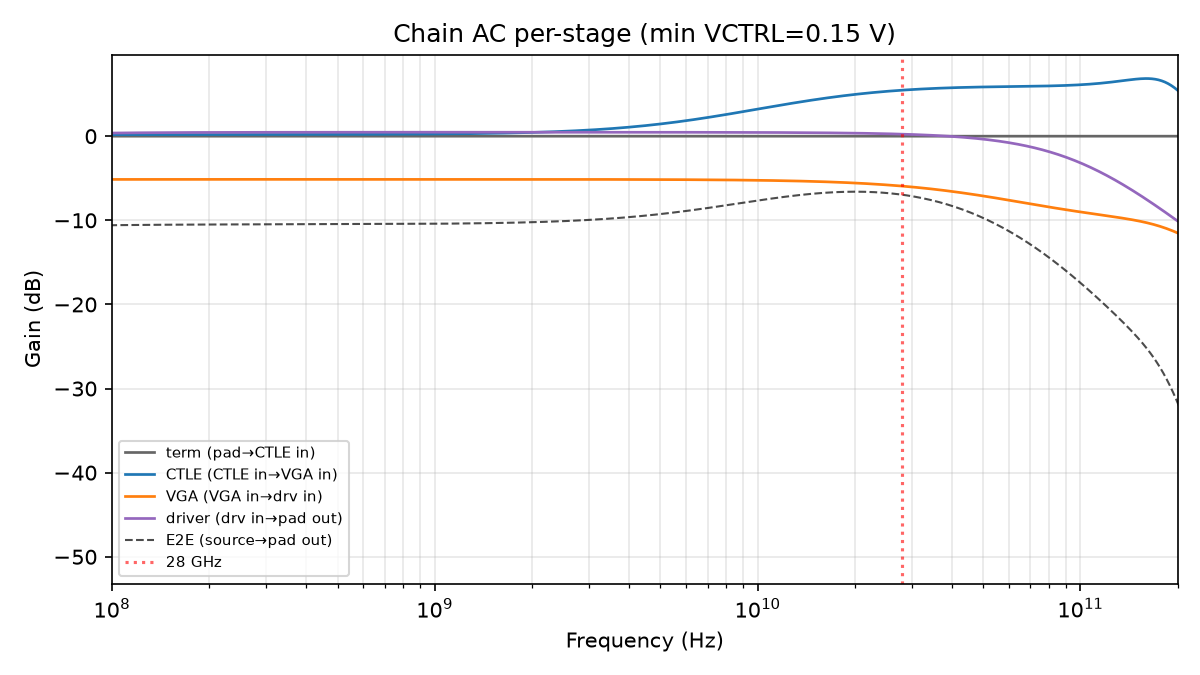
circuits/ctle56n/out/chain/chain_perstg/ac_diff_min.png
