oscarmattia/ihp-experiments/circuits/ctle56n/out/chain/chain_perstg/sbr_max.png

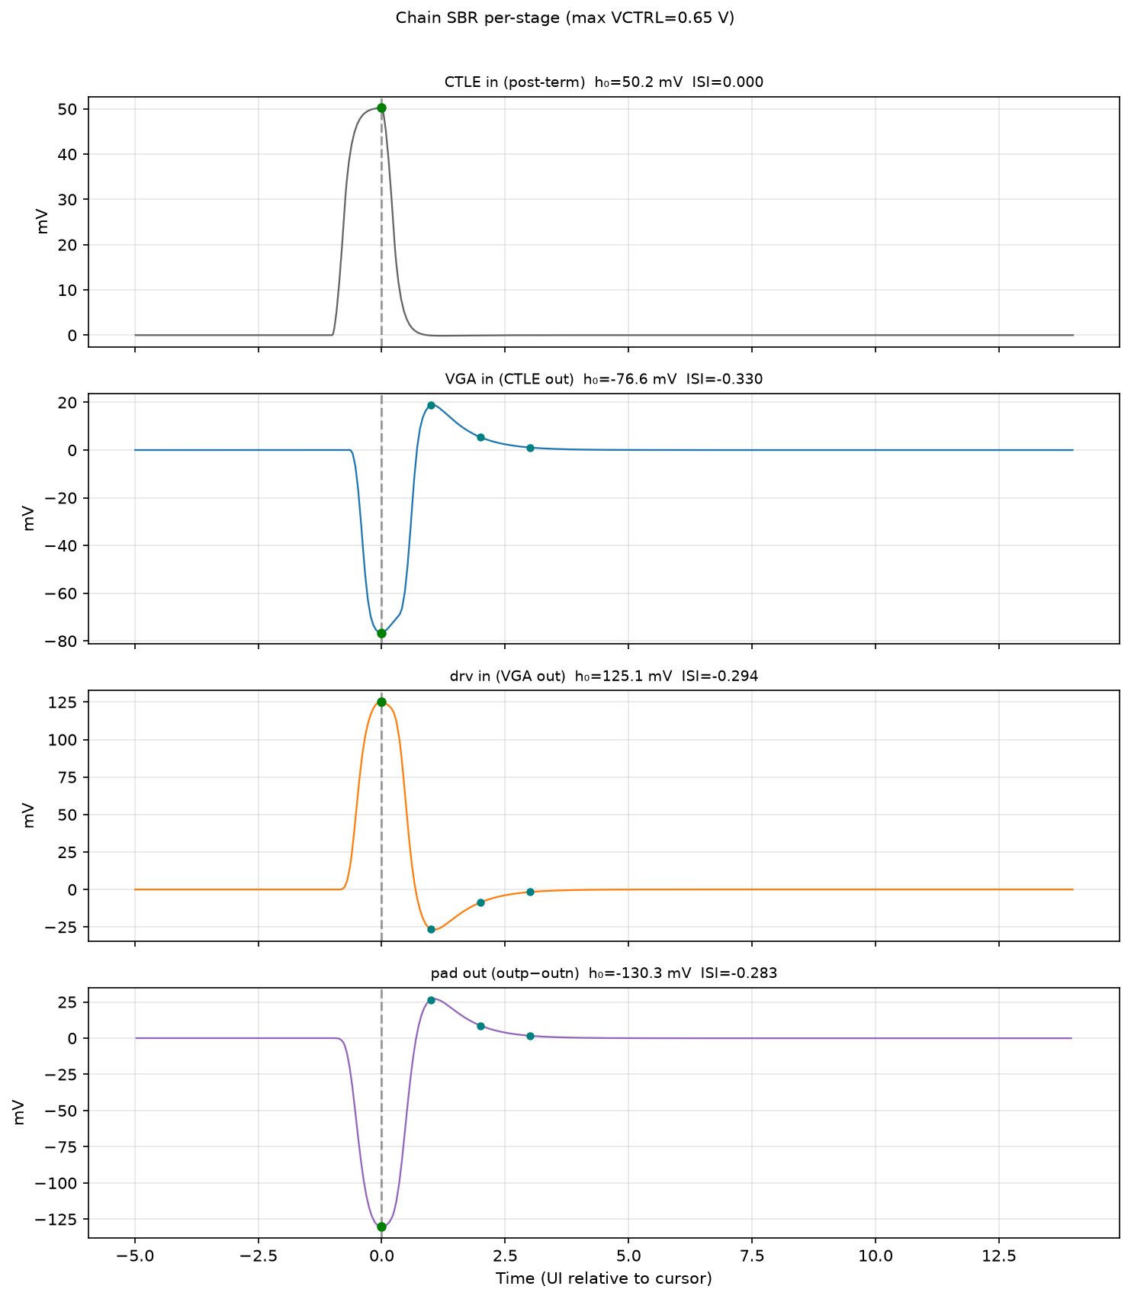
circuits/ctle56n/out/chain/chain_perstg/sbr_max.png
