oscarmattia/ihp-experiments/circuits/ctle56n/out/chain/chain_perstg/sbr_mid.png

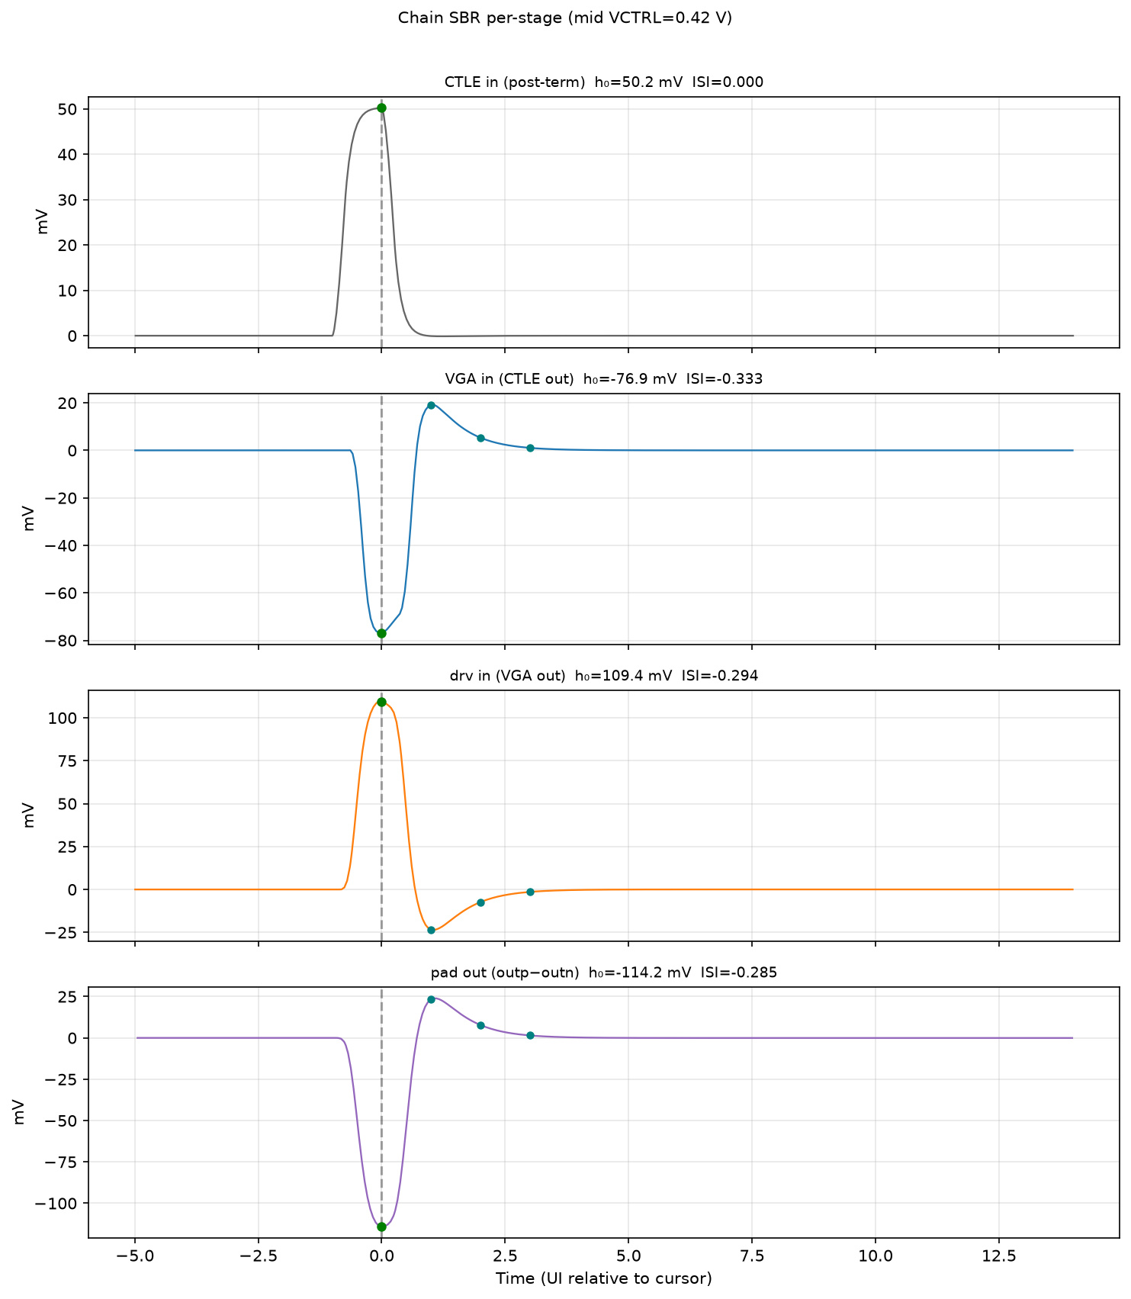
circuits/ctle56n/out/chain/chain_perstg/sbr_mid.png
