oscarmattia/ihp-experiments/circuits/ctle56n/out/chain/chain_perstg/tran_diff_max.png

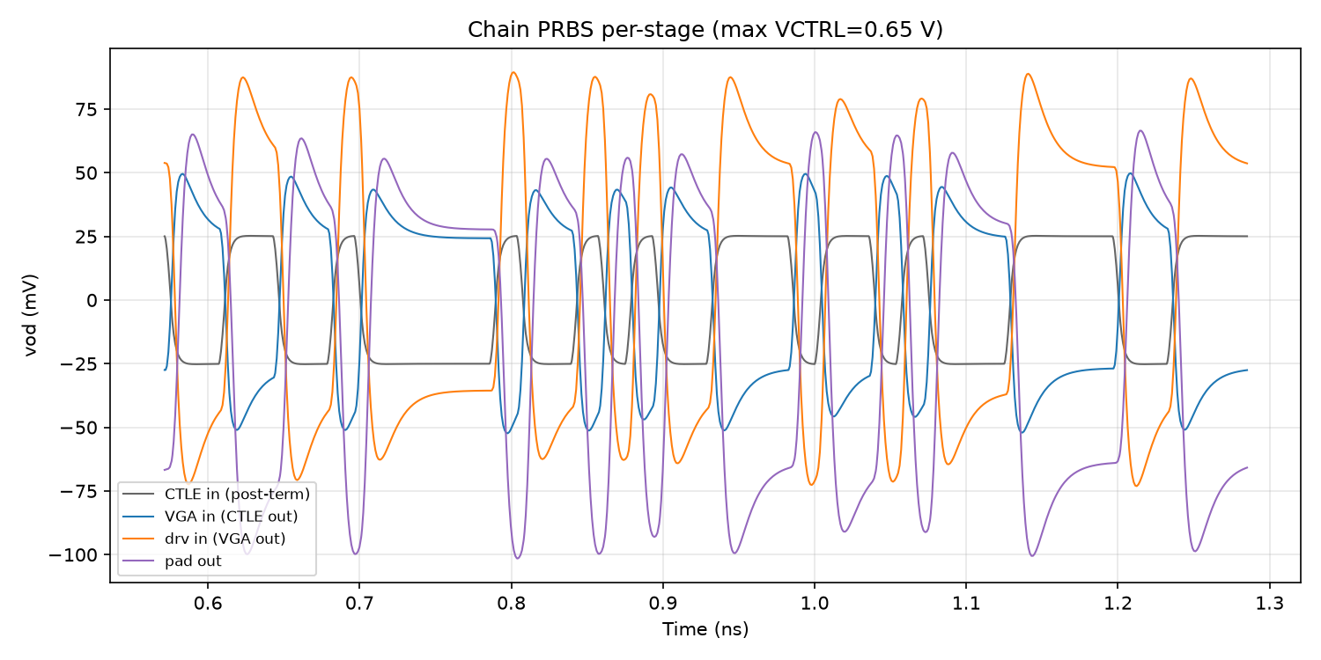
circuits/ctle56n/out/chain/chain_perstg/tran_diff_max.png
