oscarmattia/ihp-experiments/circuits/ctle56n/out/chain/chain_perstg/tran_diff_mid.png

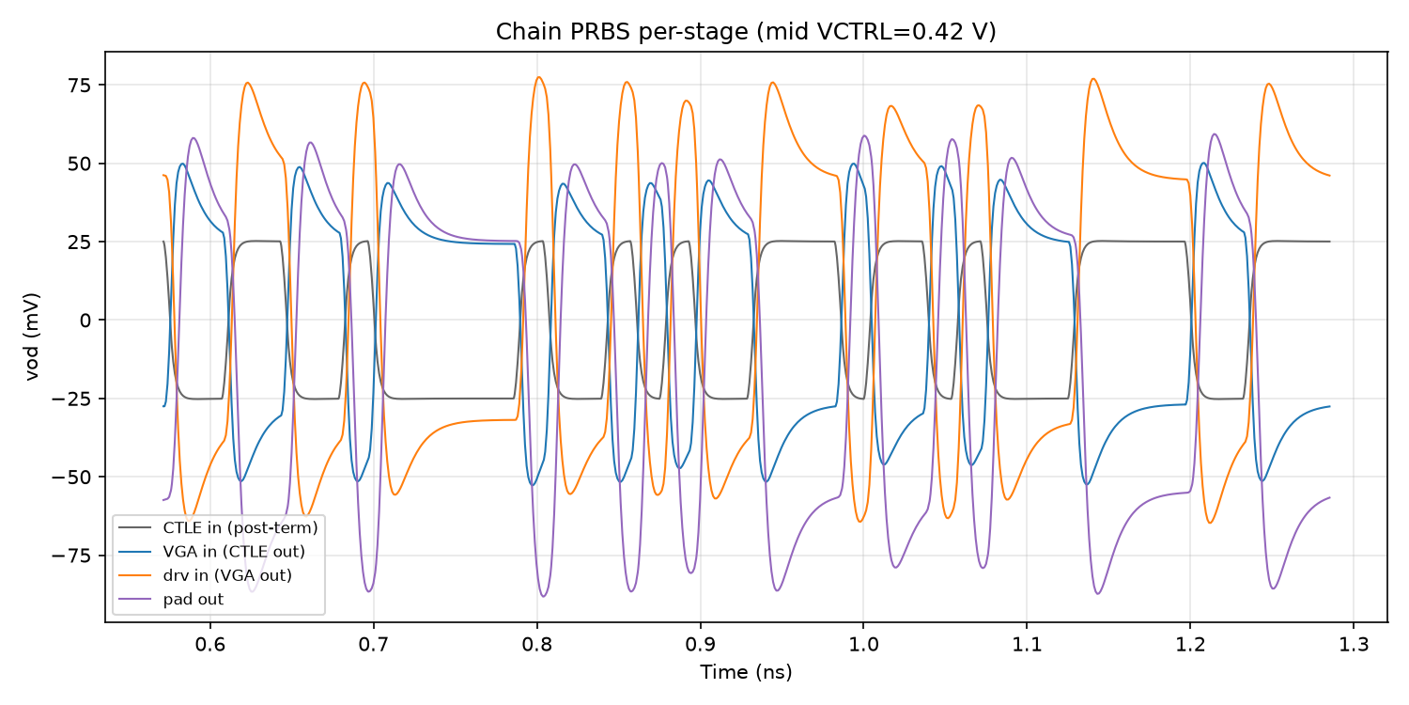
circuits/ctle56n/out/chain/chain_perstg/tran_diff_mid.png
