oscarmattia/ihp-experiments/circuits/ctle56n/out/chain/zin.png

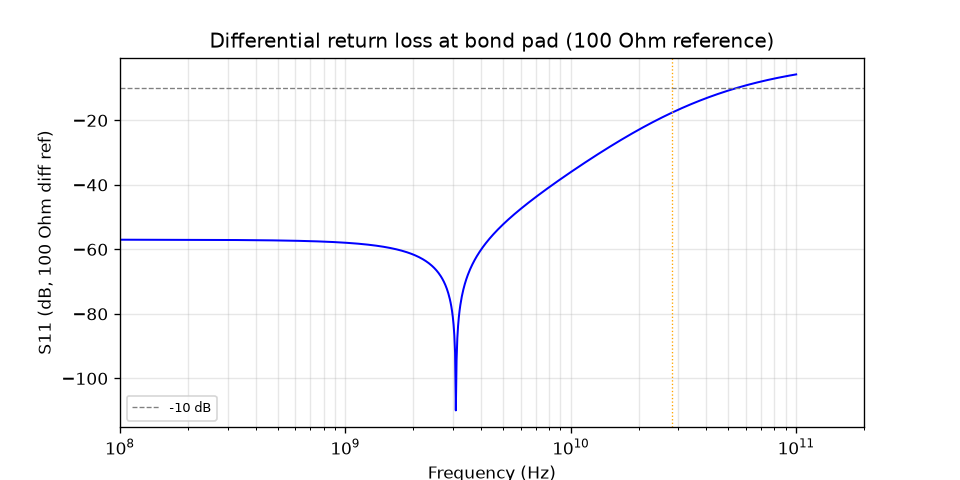
circuits/ctle56n/out/chain/zin.png
