oscarmattia/ihp-experiments/circuits/ctle56n/out/driver/ac_diff.png

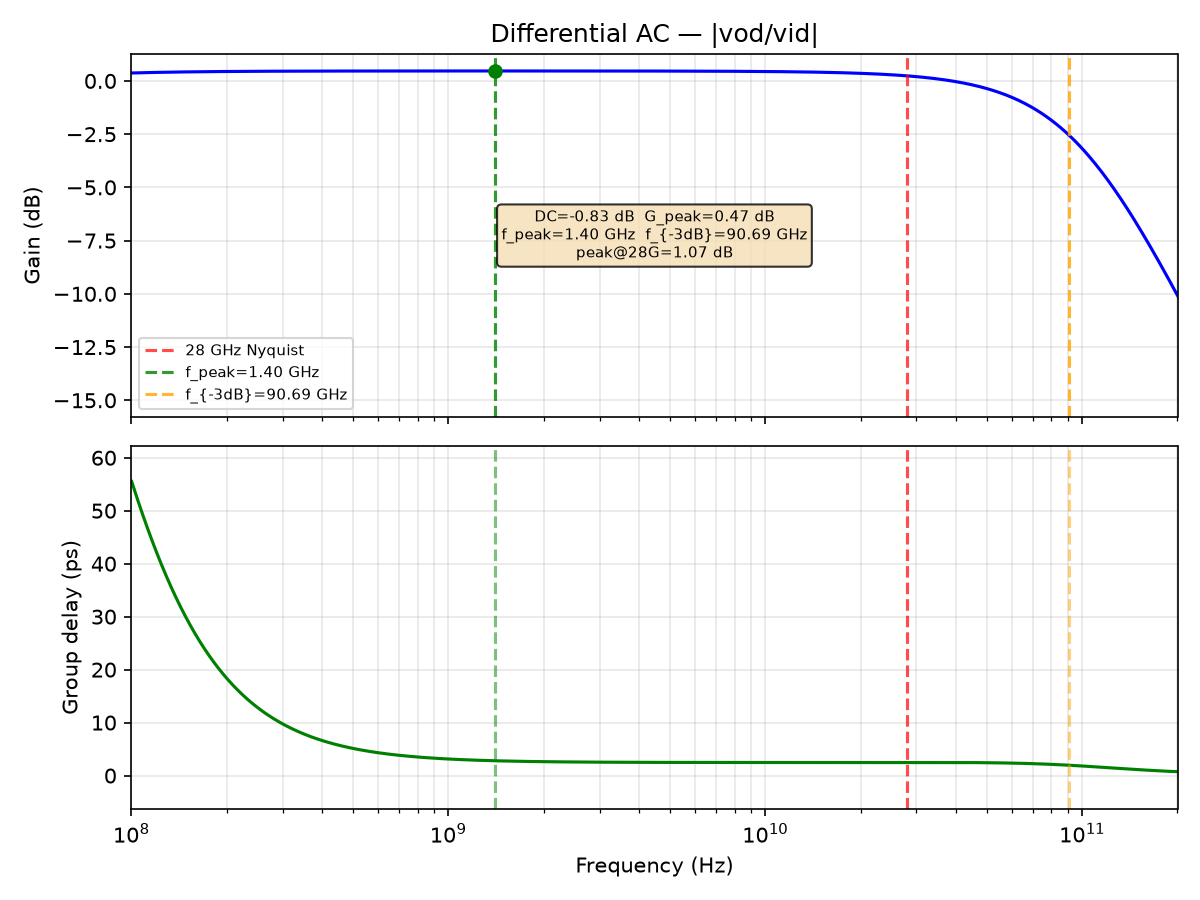
circuits/ctle56n/out/driver/ac_diff.png
