oscarmattia/ihp-experiments/circuits/ctle56n/out/driver/eye_diff.png

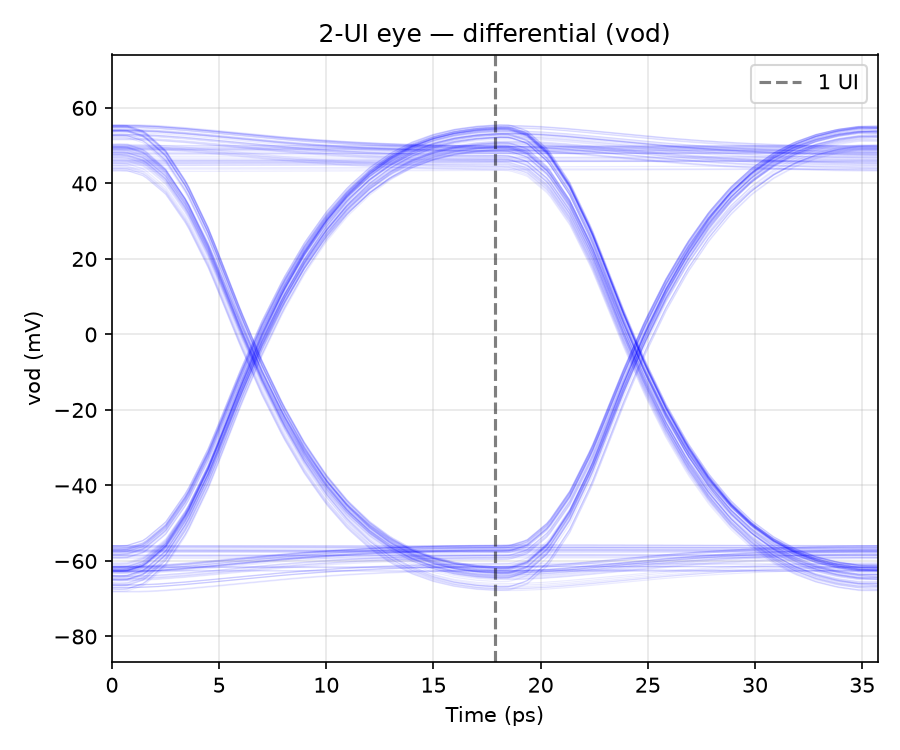
circuits/ctle56n/out/driver/eye_diff.png
