oscarmattia/ihp-experiments/circuits/ctle56n/out/driver/eye_se.png

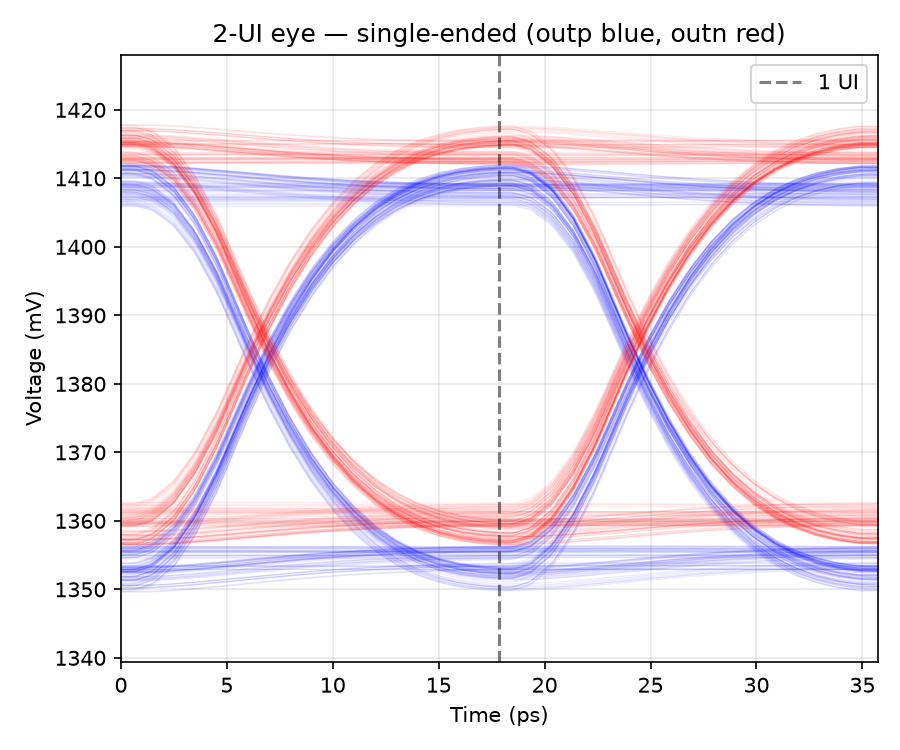
circuits/ctle56n/out/driver/eye_se.png
