oscarmattia/ihp-experiments/circuits/ctle56n/out/driver/sbr.png

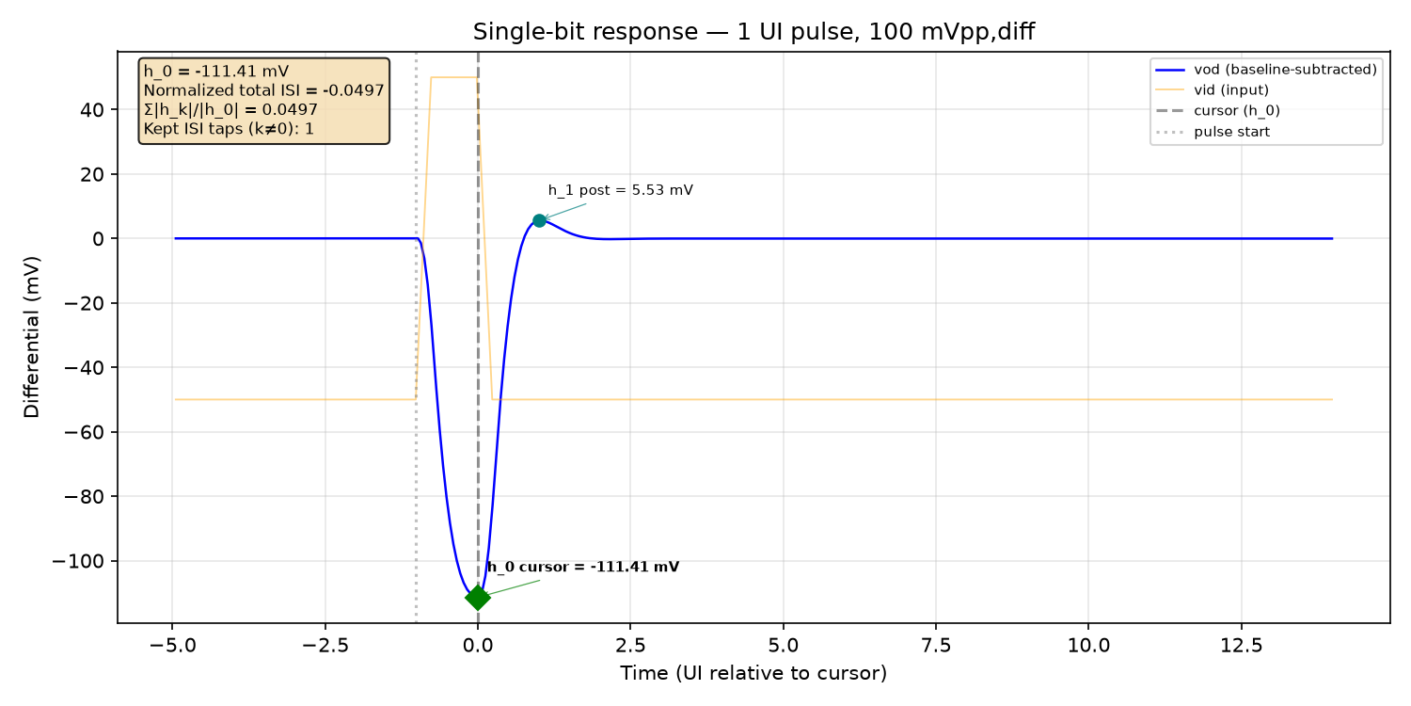
circuits/ctle56n/out/driver/sbr.png
