oscarmattia/ihp-experiments/circuits/ctle56n/out/driver/tran_diff.png

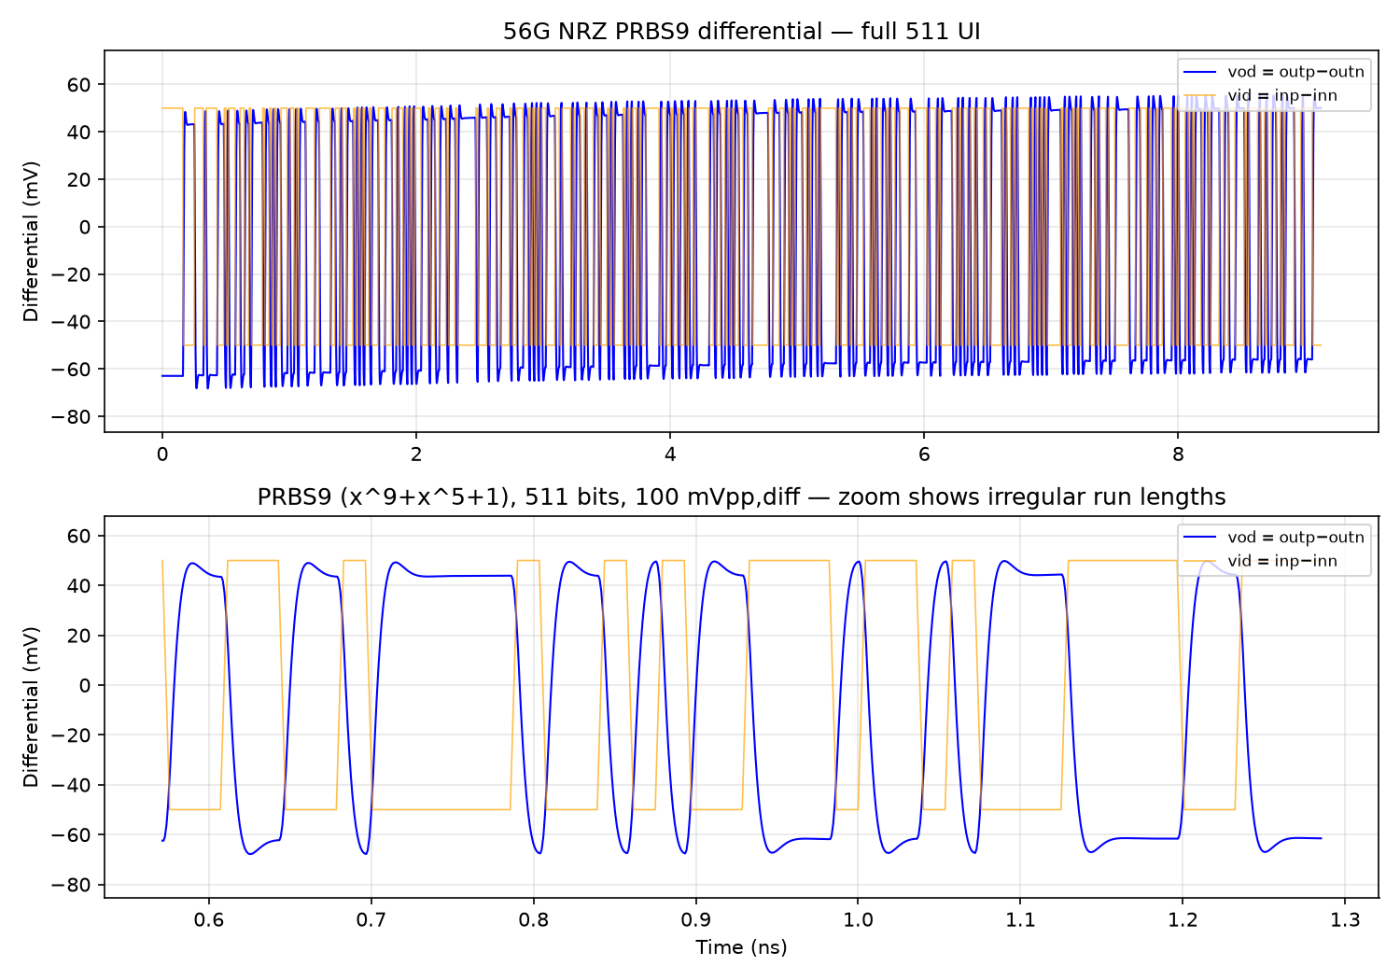
circuits/ctle56n/out/driver/tran_diff.png
