oscarmattia/ihp-experiments/circuits/ctle56n/out/driver/tran_se.png

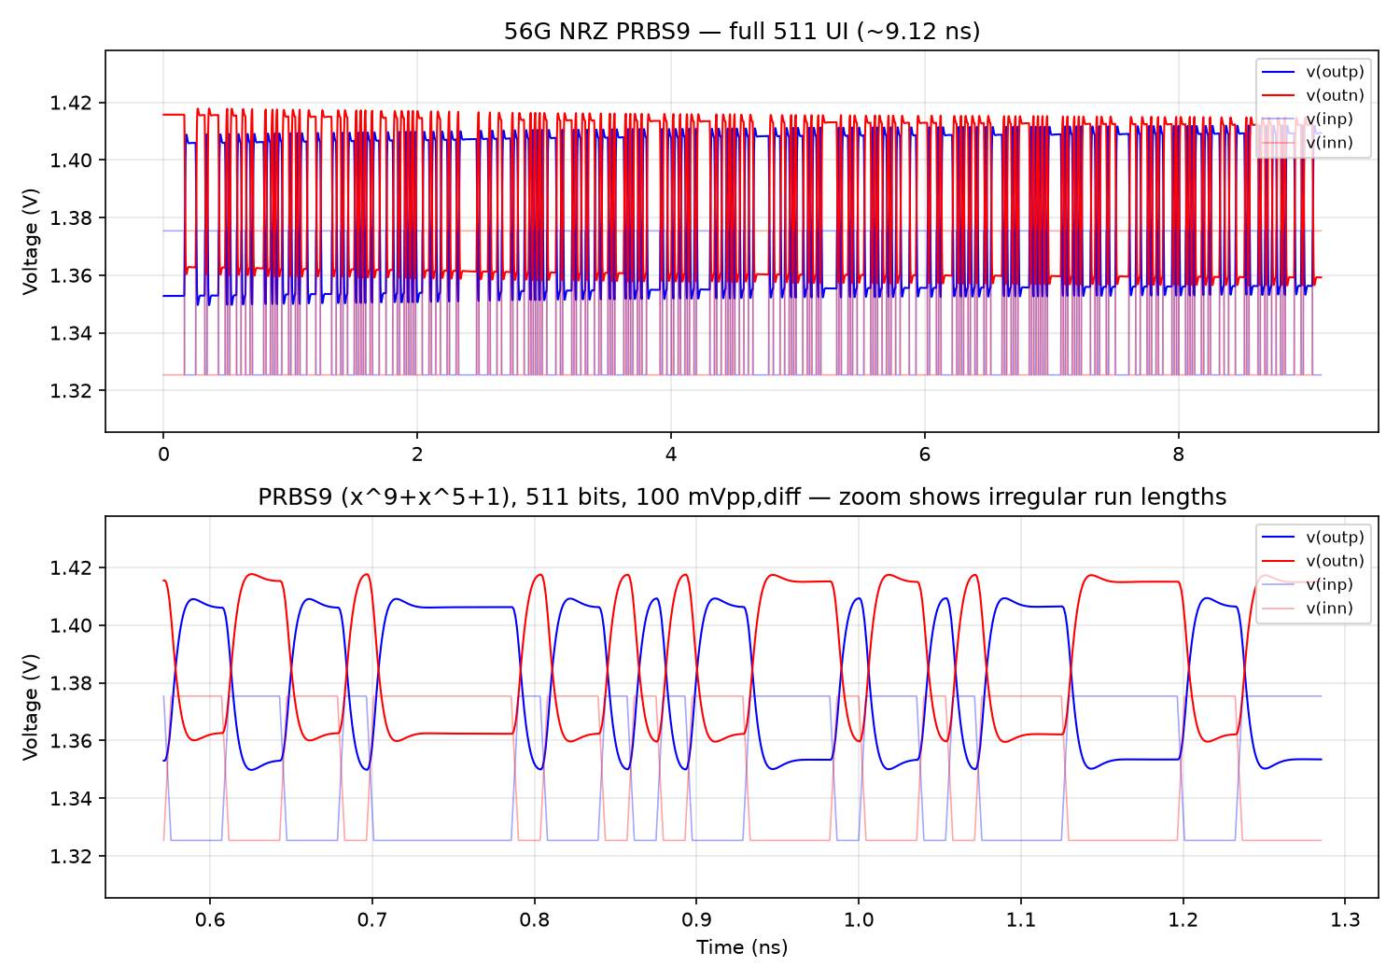
circuits/ctle56n/out/driver/tran_se.png
