oscarmattia/ihp-experiments/circuits/ctle56n/out/driver/zin.png

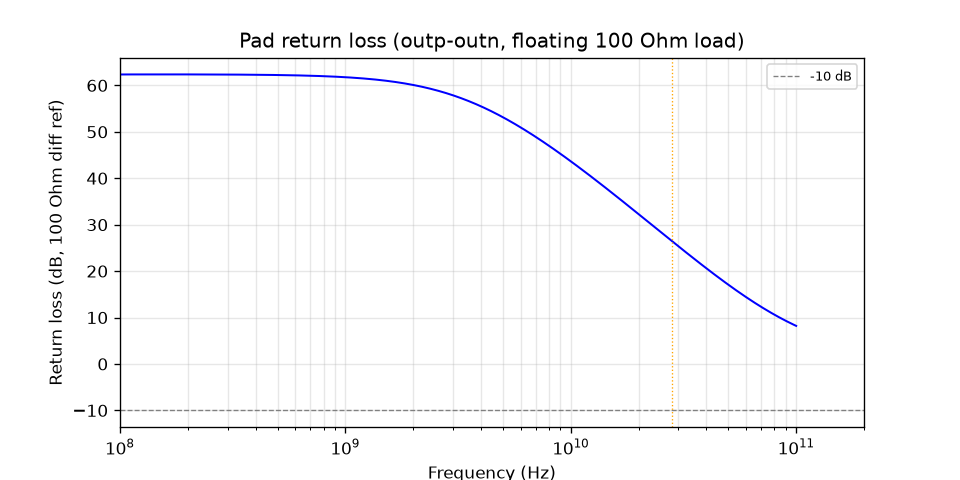
circuits/ctle56n/out/driver/zin.png
