oscarmattia/ihp-experiments/circuits/ctle56n/out/ideal/ac_diff_buggy.png

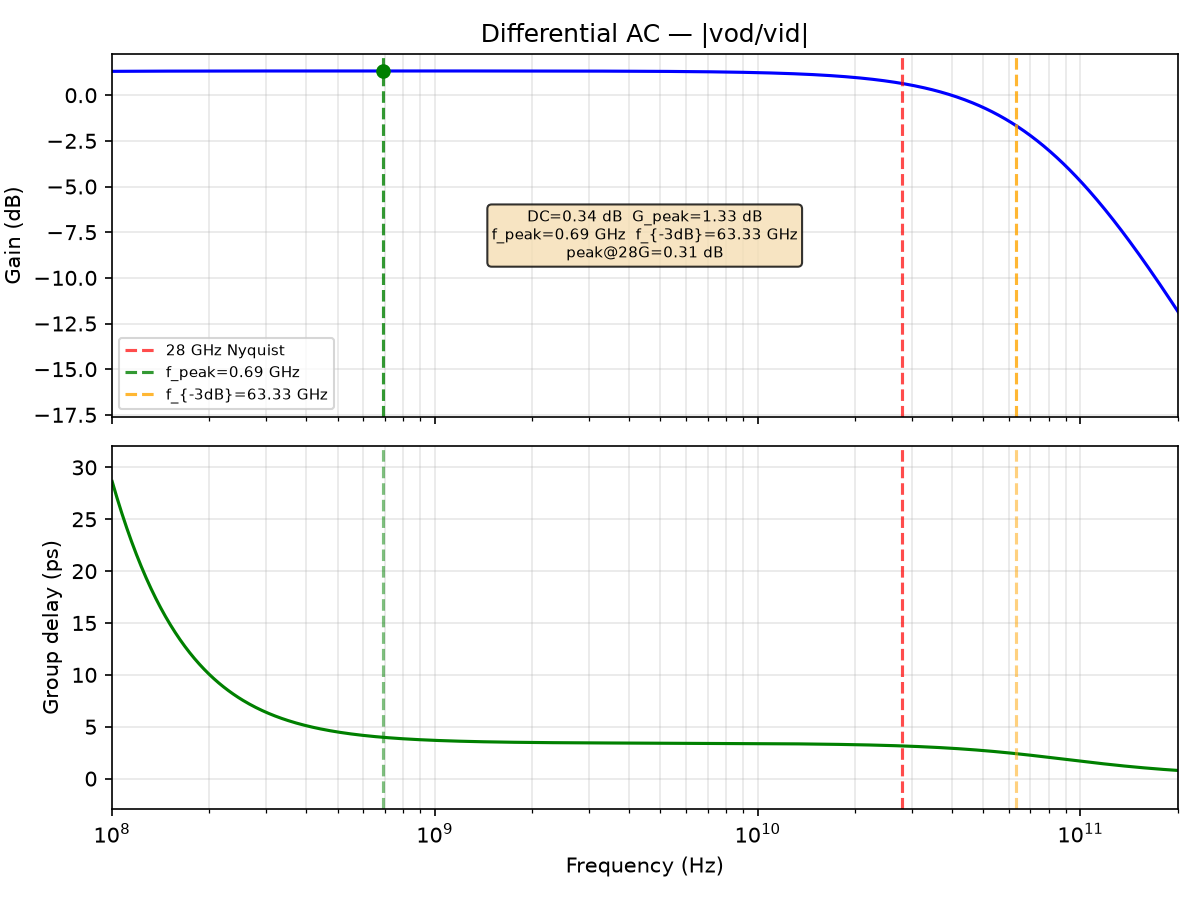
circuits/ctle56n/out/ideal/ac_diff_buggy.png
