oscarmattia/ihp-experiments/circuits/ctle56n/out/ideal/cmrr.png

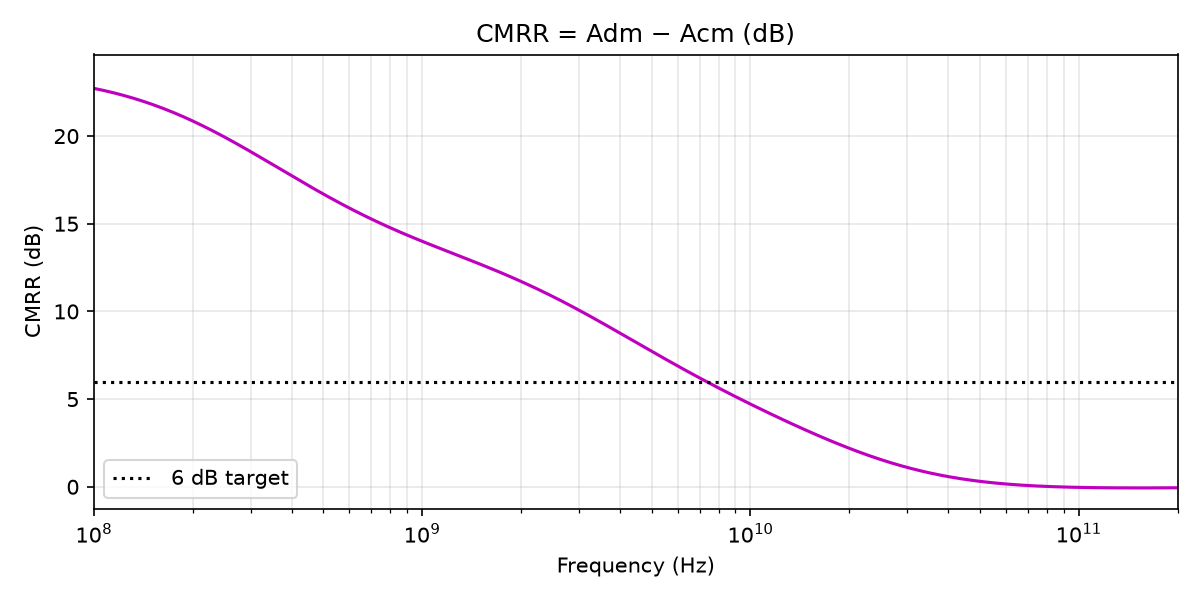
circuits/ctle56n/out/ideal/cmrr.png
