oscarmattia/ihp-experiments/circuits/ctle56n/out/pdk/ac_diff_buggy.png

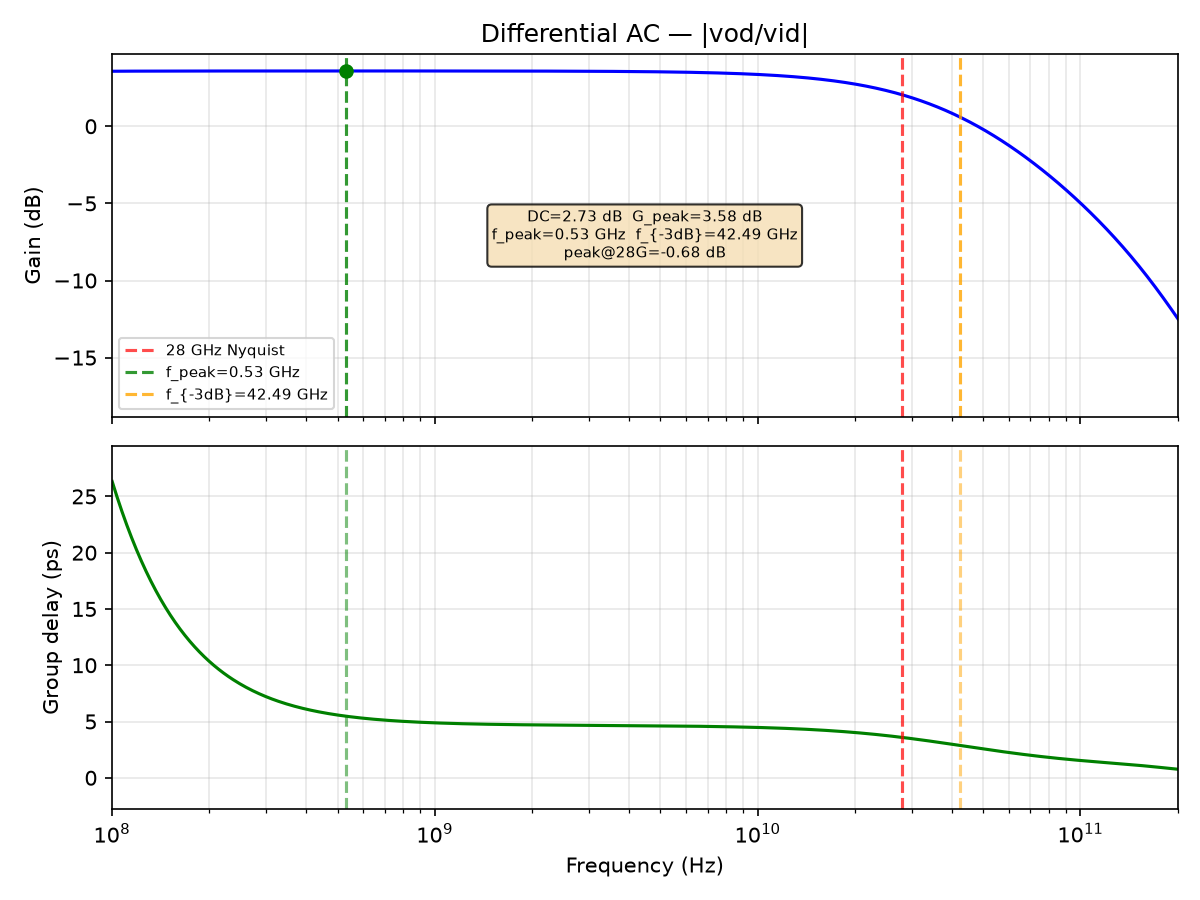
circuits/ctle56n/out/pdk/ac_diff_buggy.png
