oscarmattia/ihp-experiments/circuits/ctle56n/out/pdk/psrr.png

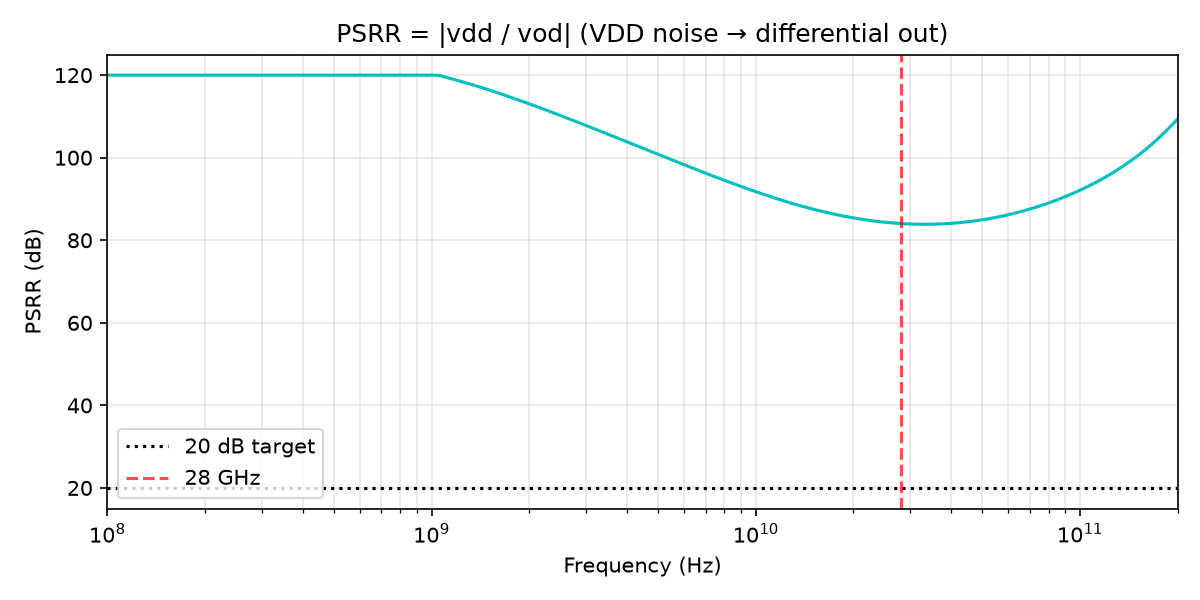
circuits/ctle56n/out/pdk/psrr.png
