oscarmattia/ihp-experiments/circuits/ctle56n/out/postlayout_driver_klayout/zin.png

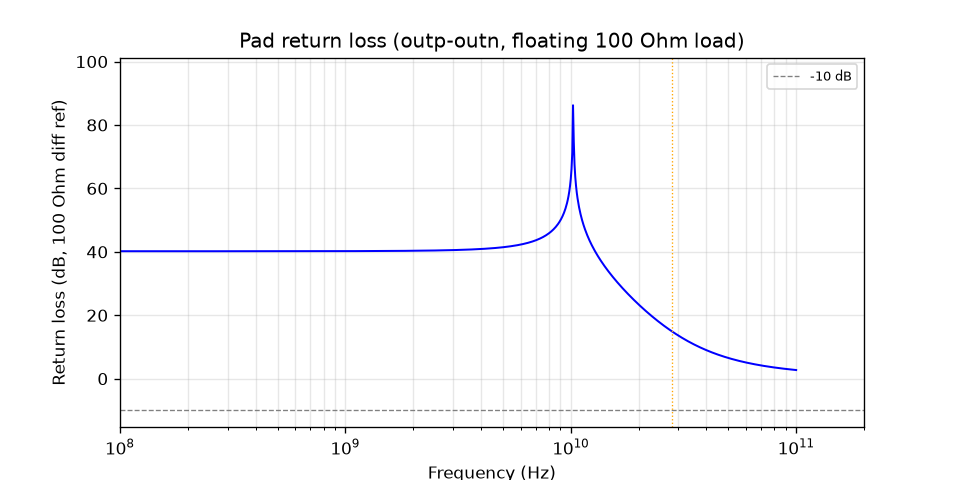
circuits/ctle56n/out/postlayout_driver_klayout/zin.png
