oscarmattia/ihp-experiments/circuits/ctle56n/out/postlayout_driver_magic/ac_diff.png

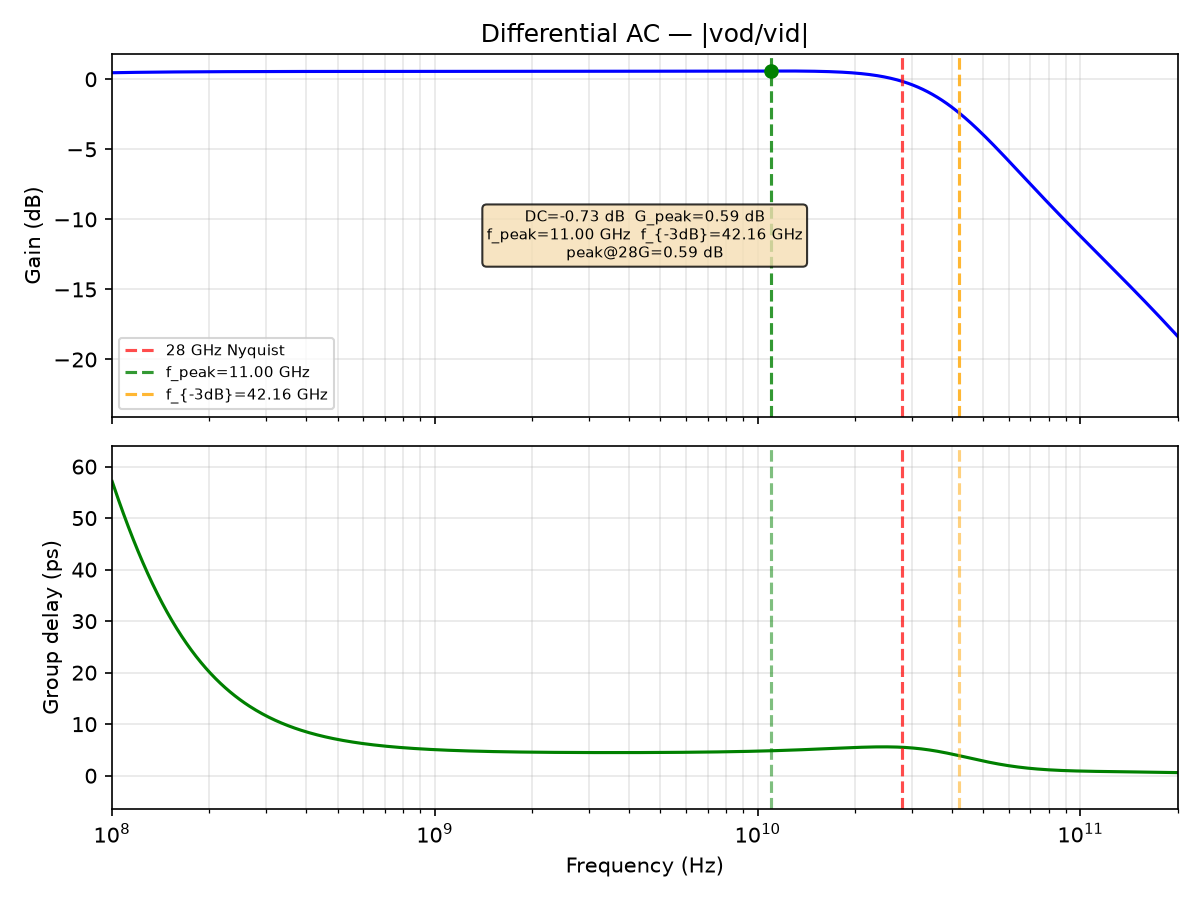
circuits/ctle56n/out/postlayout_driver_magic/ac_diff.png
