oscarmattia/ihp-experiments/circuits/ctle56n/out/postlayout_driver_magic/eye_diff.png

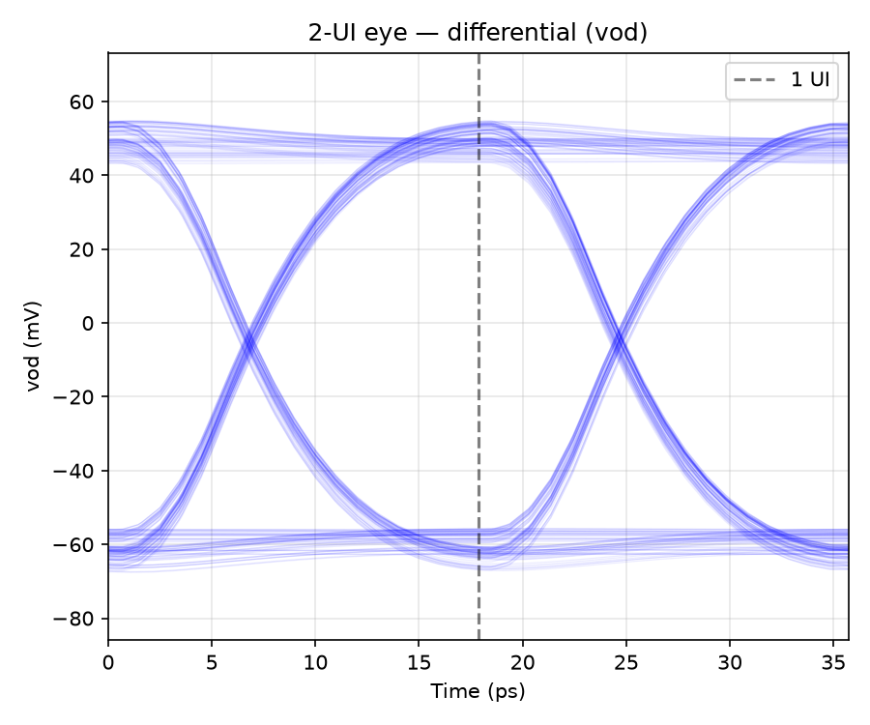
circuits/ctle56n/out/postlayout_driver_magic/eye_diff.png
