oscarmattia/ihp-experiments/circuits/ctle56n/out/postlayout_driver_magic/zin.png

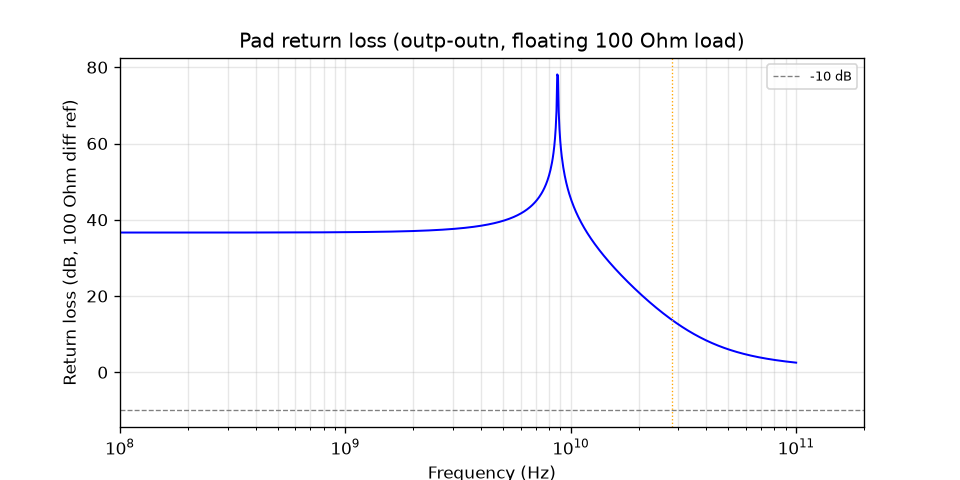
circuits/ctle56n/out/postlayout_driver_magic/zin.png
