oscarmattia/ihp-experiments/circuits/ctle56n/out/postlayout_magic/psrr.png

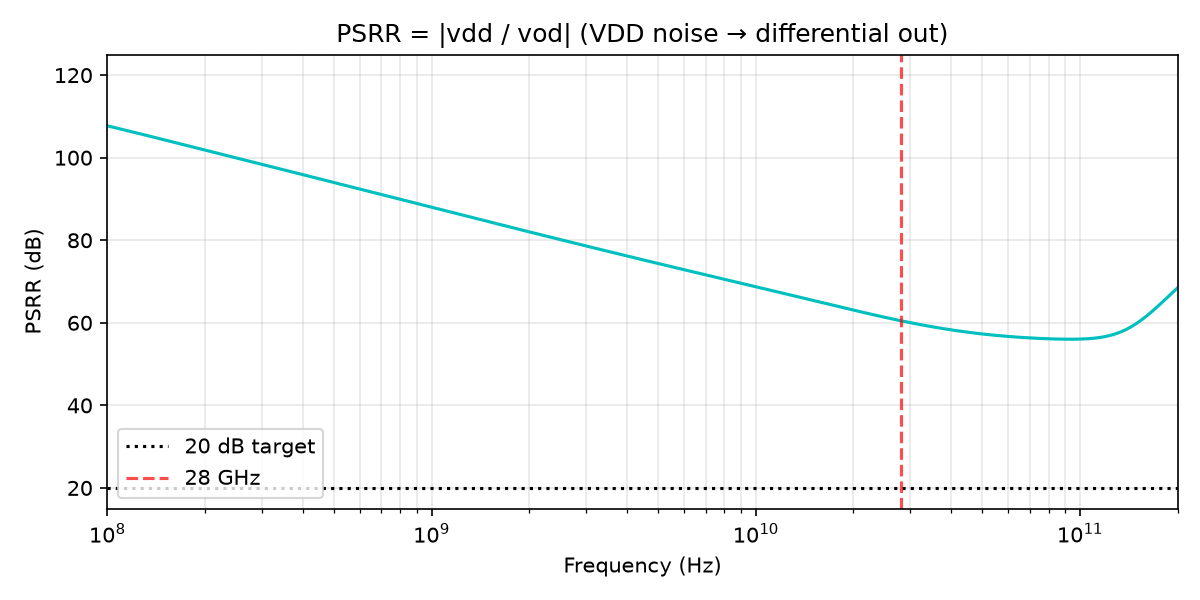
circuits/ctle56n/out/postlayout_magic/psrr.png
