oscarmattia/ihp-experiments/circuits/ctle56n/out/postlayout_vga_klayout/ac_diff_vctrl_0p15.png

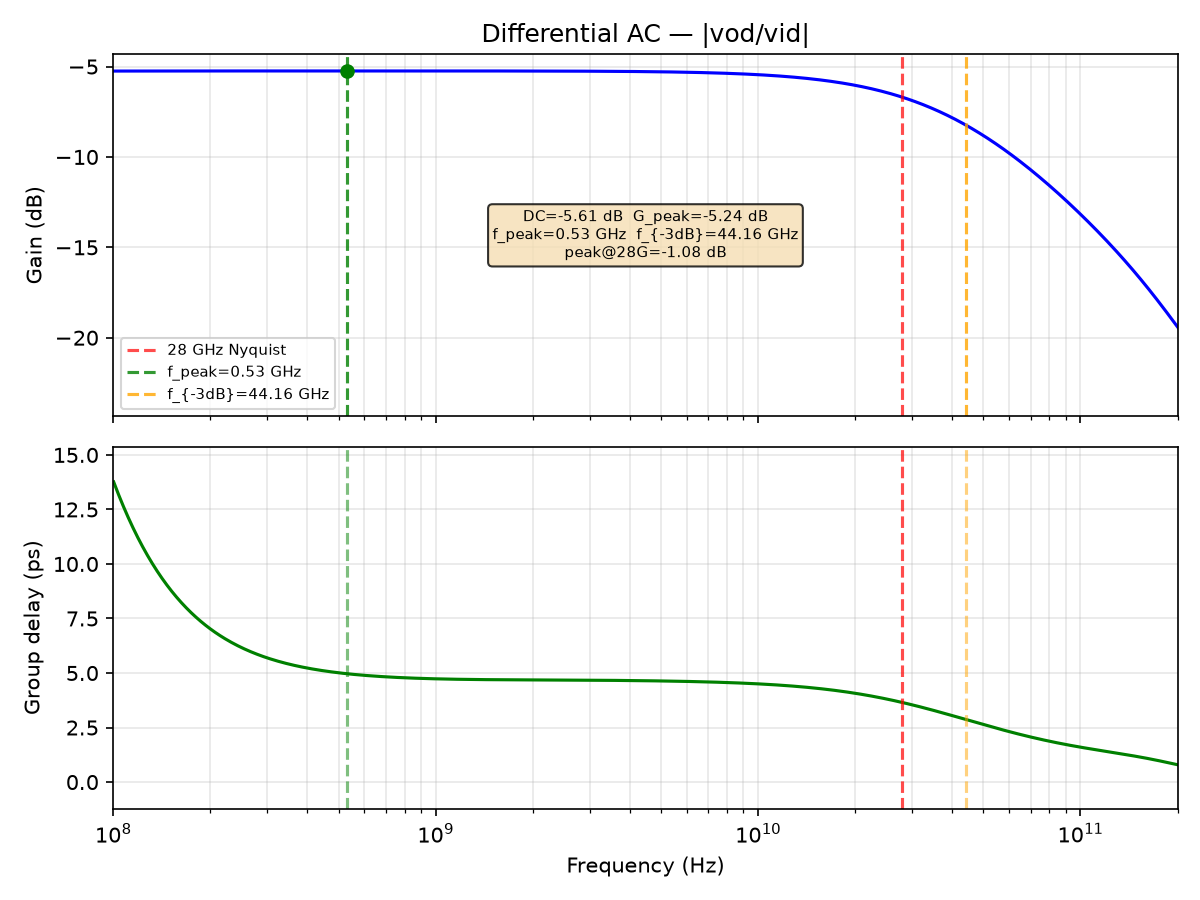
circuits/ctle56n/out/postlayout_vga_klayout/ac_diff_vctrl_0p15.png
