oscarmattia/ihp-experiments/circuits/ctle56n/out/postlayout_vga_klayout/ac_diff_vctrl_1p00.png

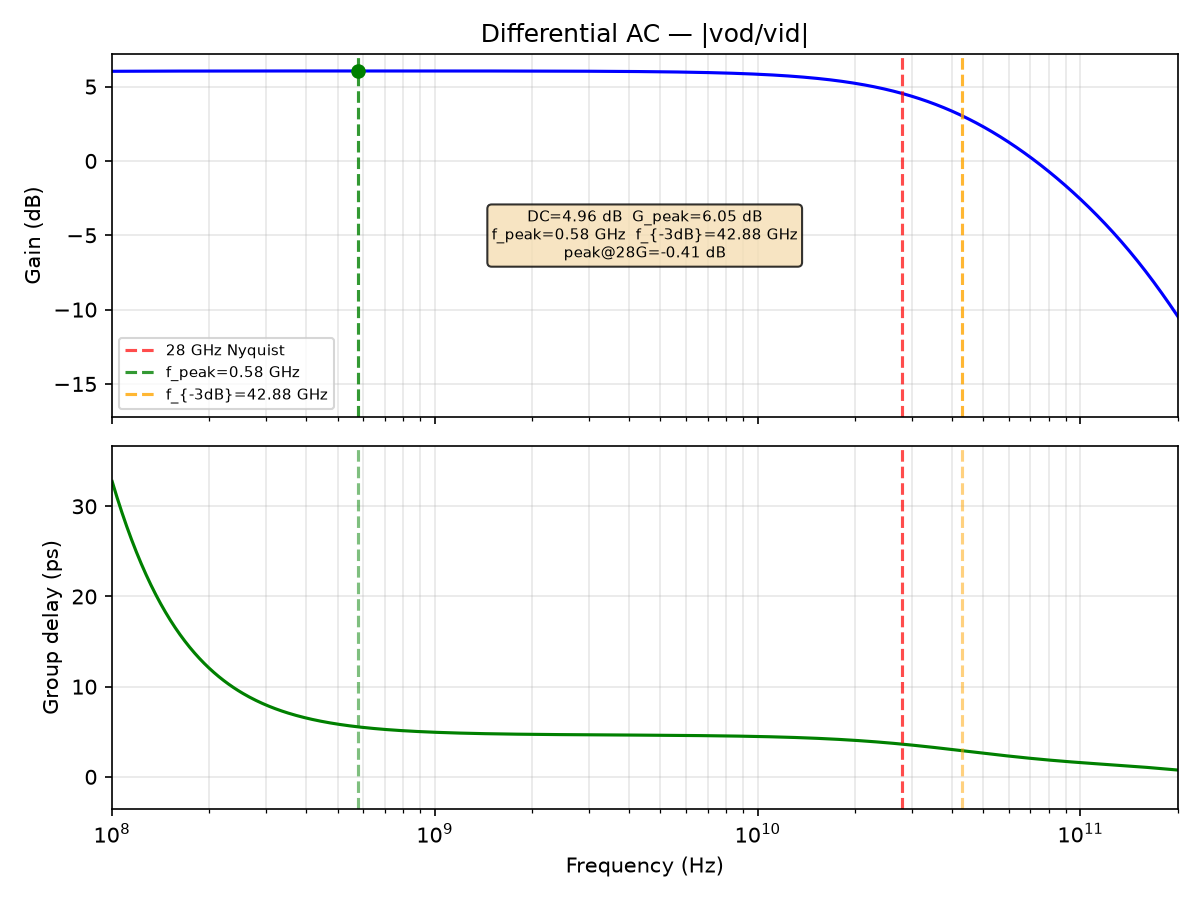
circuits/ctle56n/out/postlayout_vga_klayout/ac_diff_vctrl_1p00.png
