oscarmattia/ihp-experiments/circuits/ctle56n/out/postlayout_vga_klayout/eye_diff_min.png

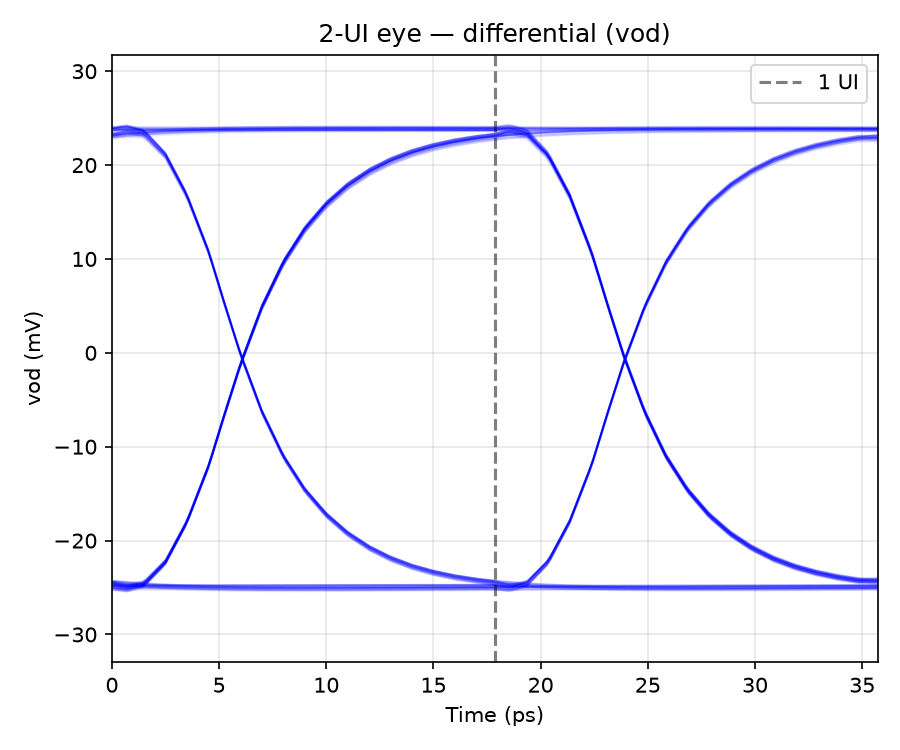
circuits/ctle56n/out/postlayout_vga_klayout/eye_diff_min.png
