oscarmattia/ihp-experiments/circuits/ctle56n/out/postlayout_vga_klayout/eye_diff_vctrl_0p28.png

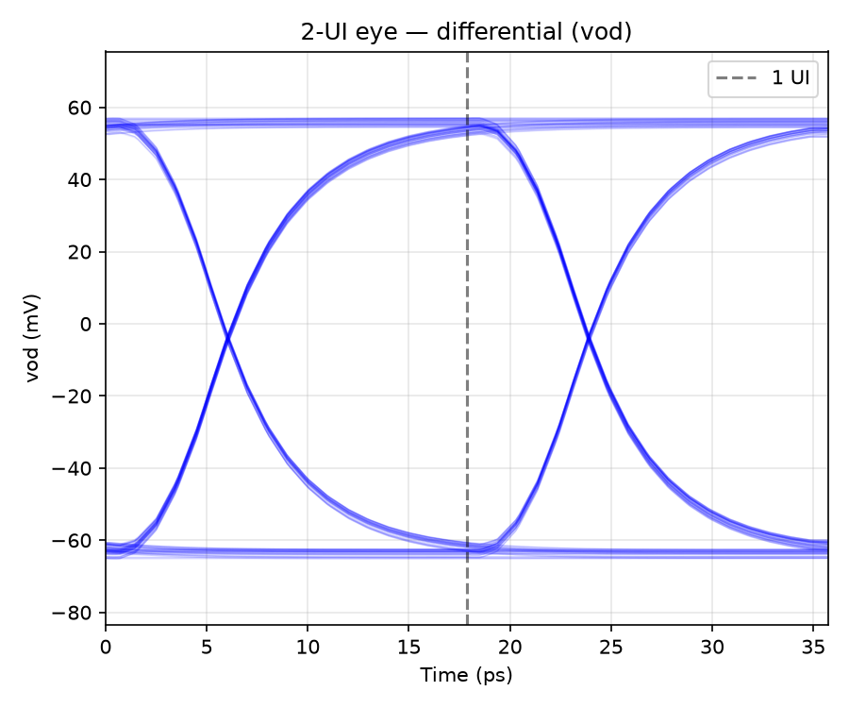
circuits/ctle56n/out/postlayout_vga_klayout/eye_diff_vctrl_0p28.png
