oscarmattia/ihp-experiments/circuits/ctle56n/out/postlayout_vga_klayout/gain_vs_vctrl.png

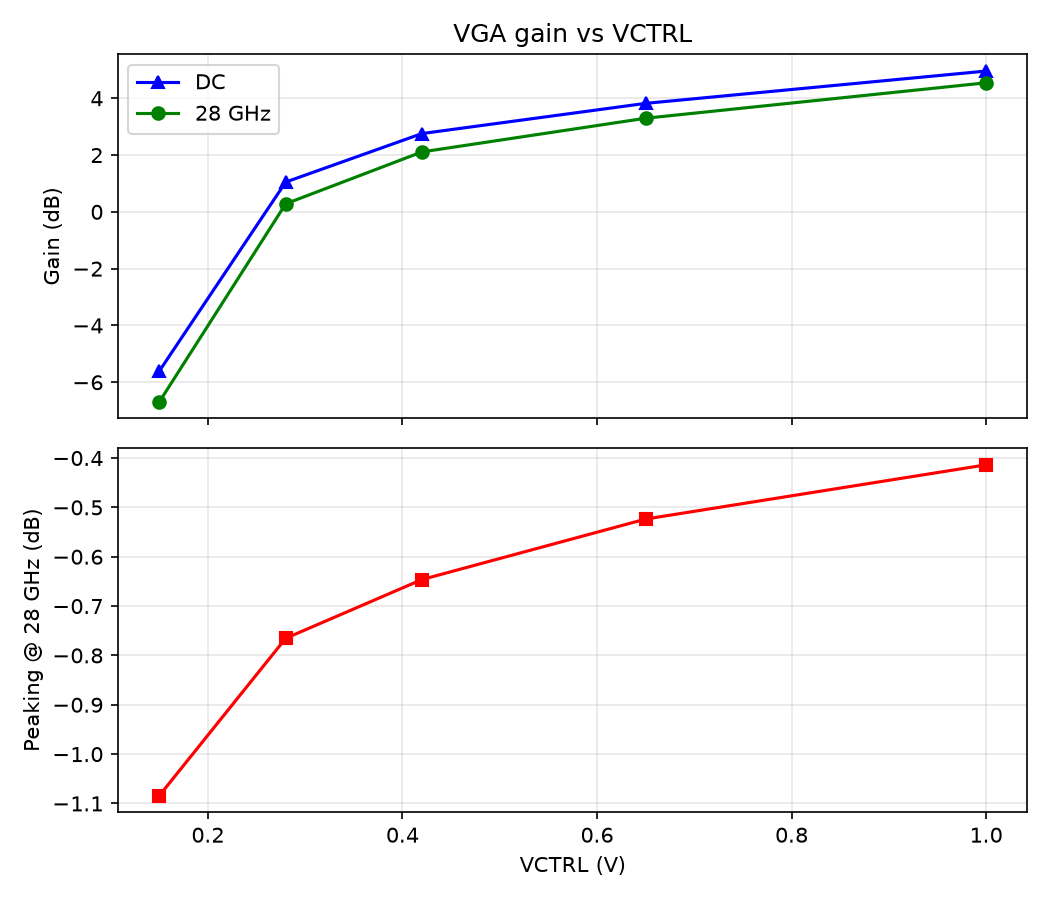
circuits/ctle56n/out/postlayout_vga_klayout/gain_vs_vctrl.png
