oscarmattia/ihp-experiments/circuits/ctle56n/out/postlayout_vga_klayout/tran_diff.png

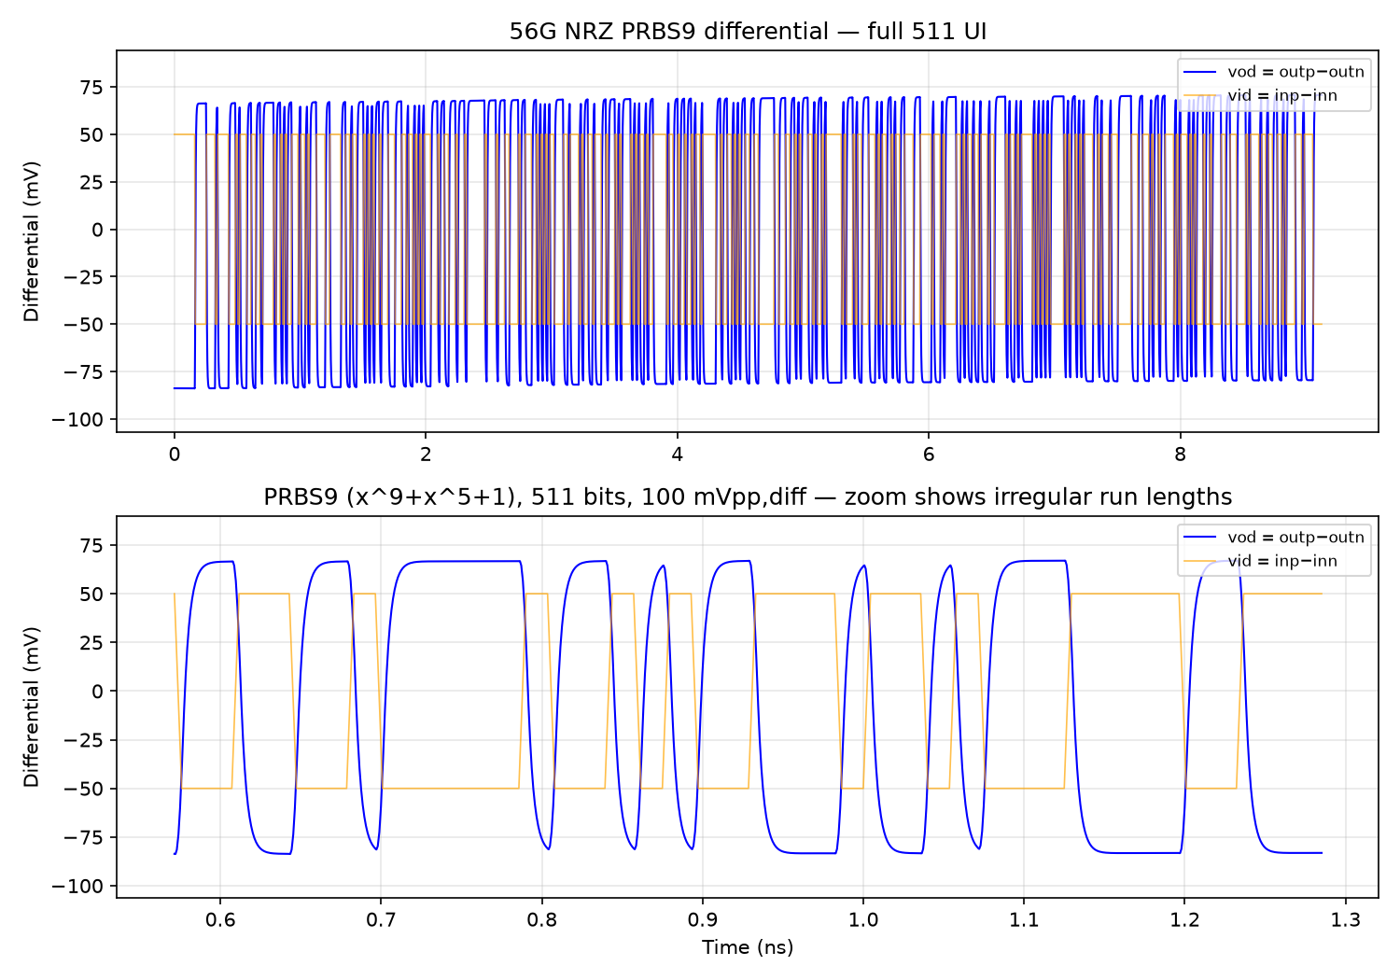
circuits/ctle56n/out/postlayout_vga_klayout/tran_diff.png
