oscarmattia/ihp-experiments/circuits/ctle56n/out/postlayout_vga_klayout/tran_se.png

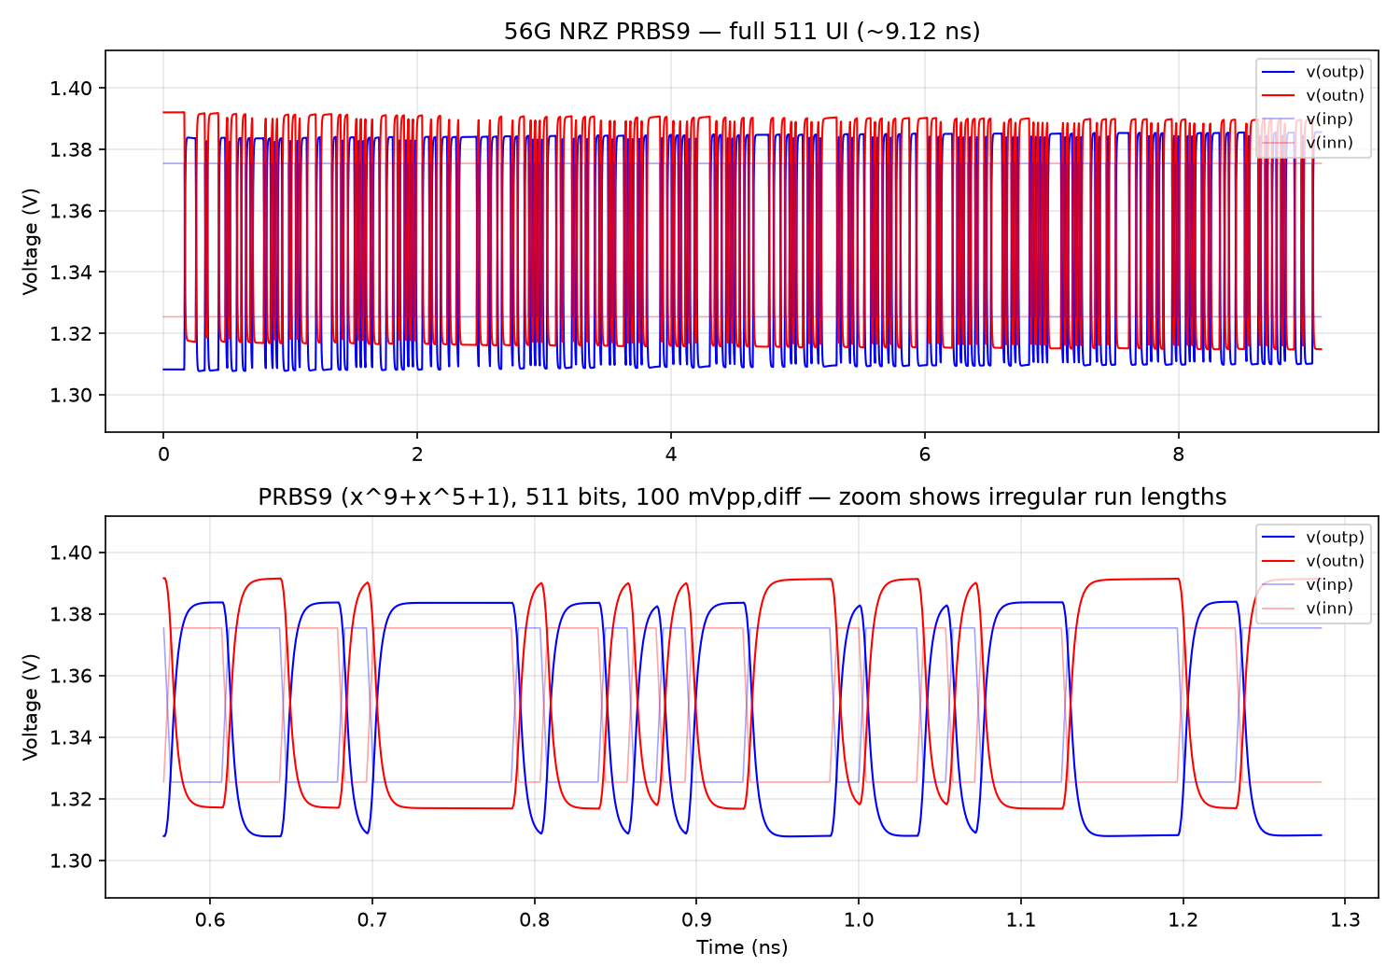
circuits/ctle56n/out/postlayout_vga_klayout/tran_se.png
