oscarmattia/ihp-experiments/circuits/ctle56n/out/postlayout_vga_magic/ac_diff.png

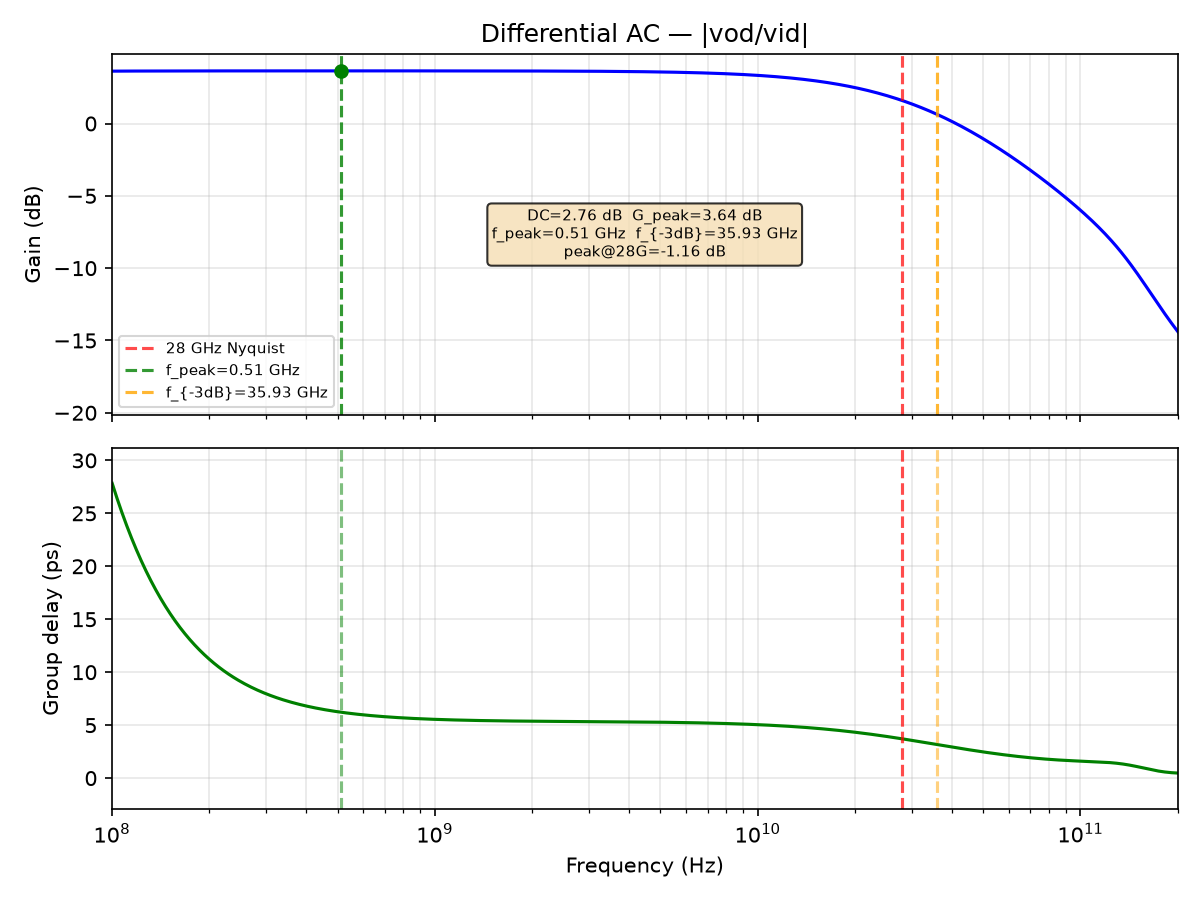
circuits/ctle56n/out/postlayout_vga_magic/ac_diff.png
