oscarmattia/ihp-experiments/circuits/ctle56n/out/postlayout_vga_magic/cmrr.png

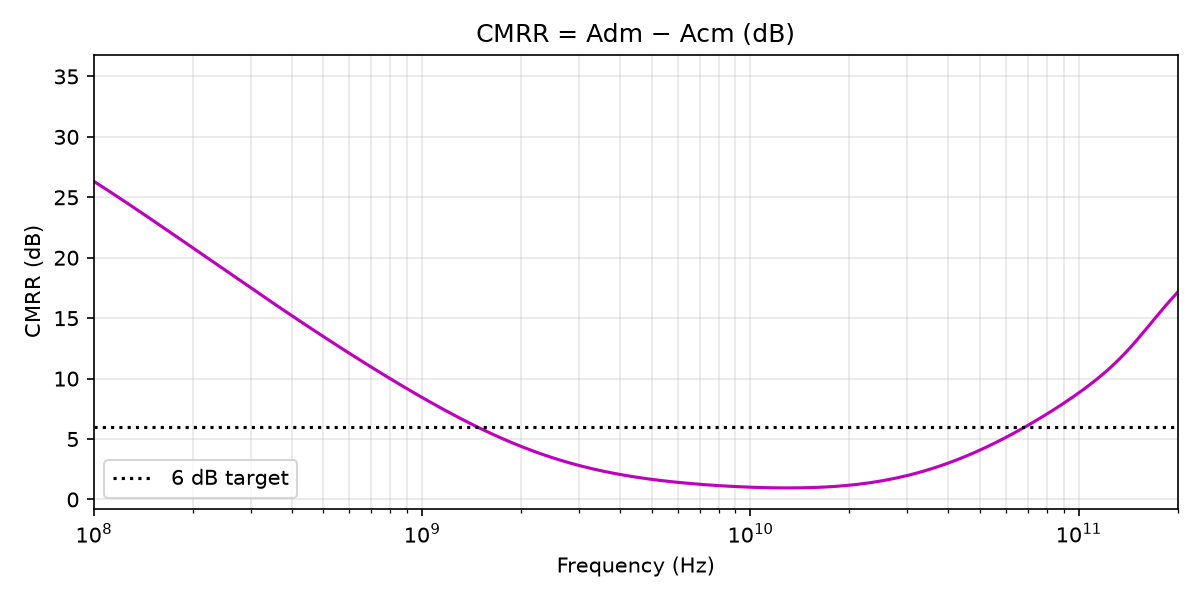
circuits/ctle56n/out/postlayout_vga_magic/cmrr.png
