oscarmattia/ihp-experiments/circuits/ctle56n/out/postlayout_vga_magic/eye_diff_min.png

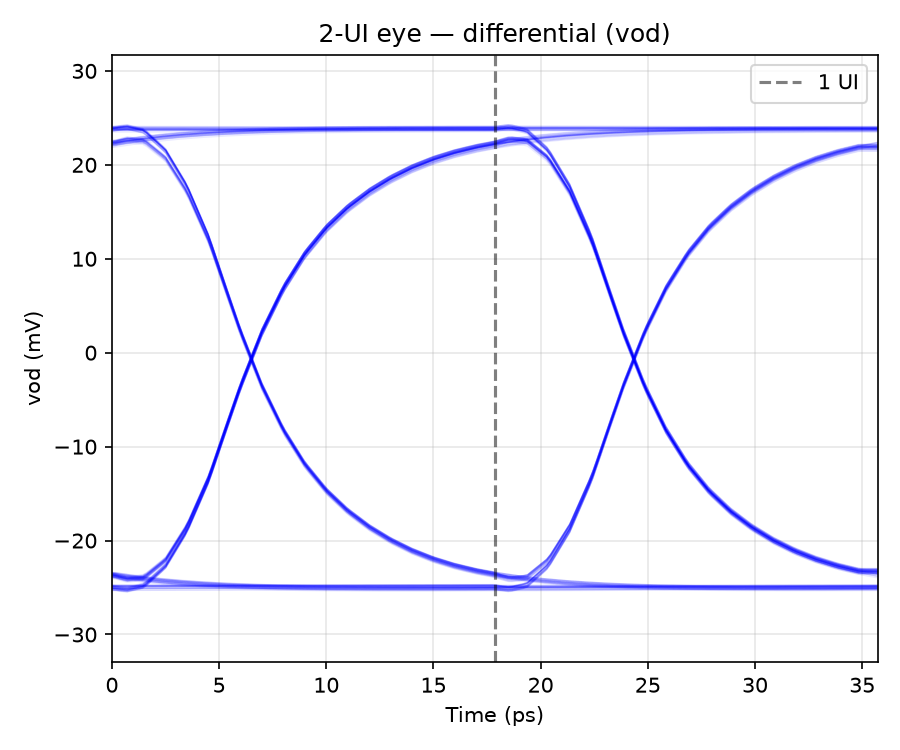
circuits/ctle56n/out/postlayout_vga_magic/eye_diff_min.png
