oscarmattia/ihp-experiments/circuits/ctle56n/out/postlayout_vga_magic/eye_se.png

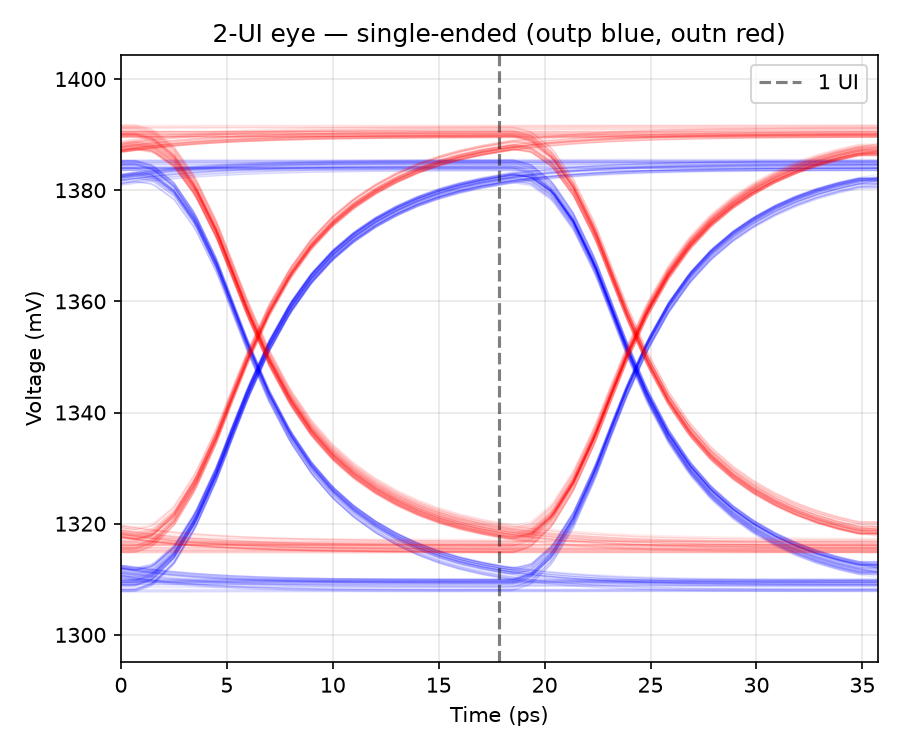
circuits/ctle56n/out/postlayout_vga_magic/eye_se.png
