oscarmattia/ihp-experiments/circuits/ctle56n/out/postlayout_vga_magic/eye_se_vctrl_1p00.png

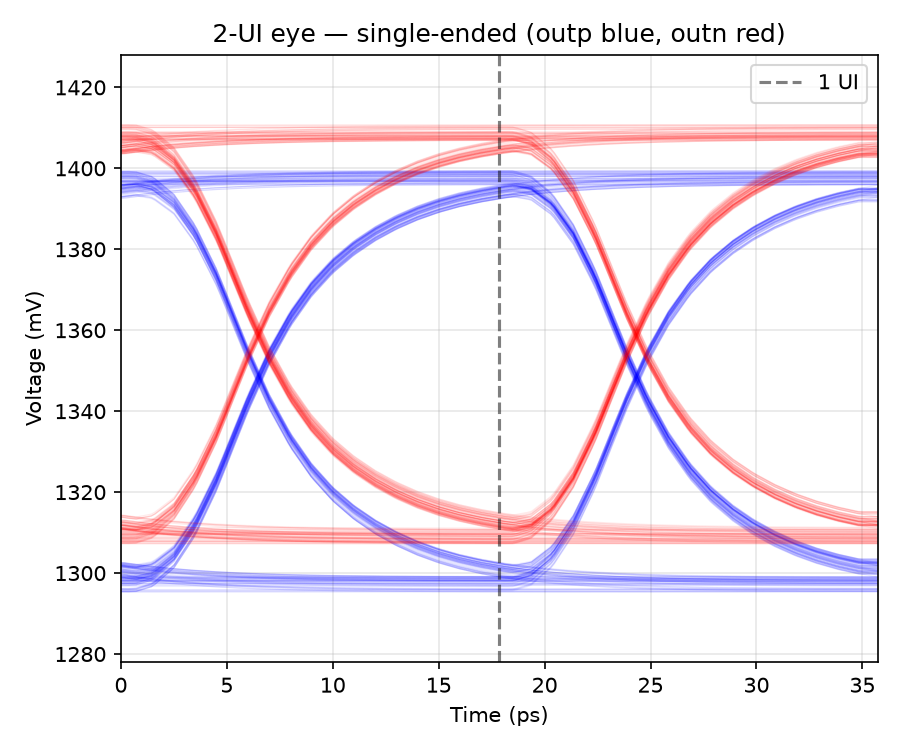
circuits/ctle56n/out/postlayout_vga_magic/eye_se_vctrl_1p00.png
