oscarmattia/ihp-experiments/circuits/ctle56n/out/postlayout_vga_magic/psrr.png

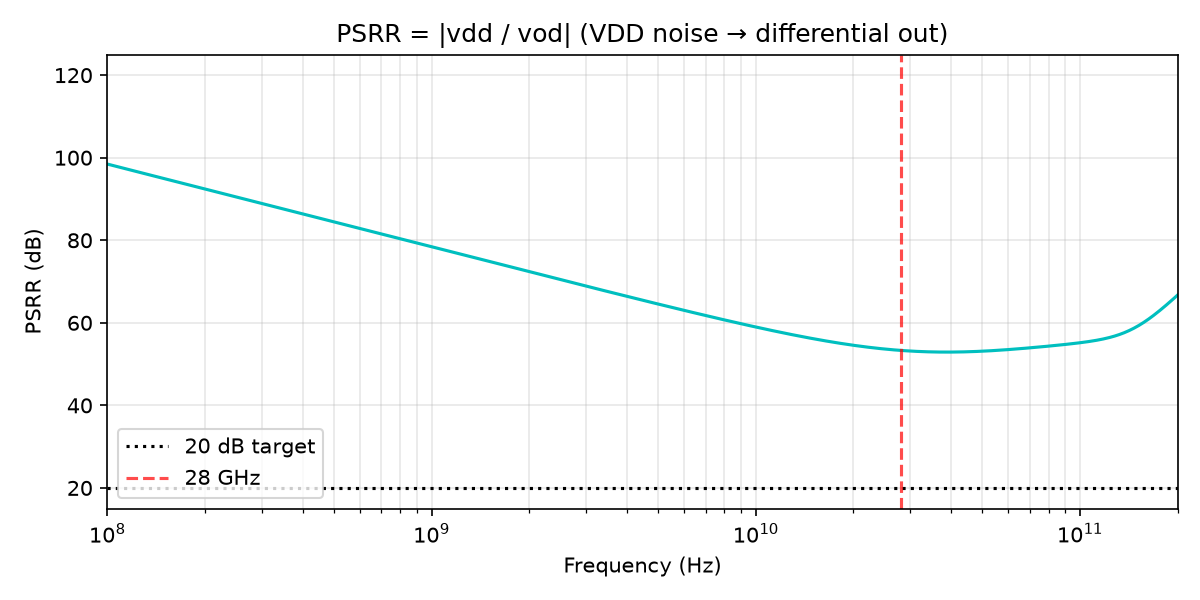
circuits/ctle56n/out/postlayout_vga_magic/psrr.png
