oscarmattia/ihp-experiments/circuits/ctle56n/out/postlayout_vga_magic/tran_diff_vctrl_0p65.png

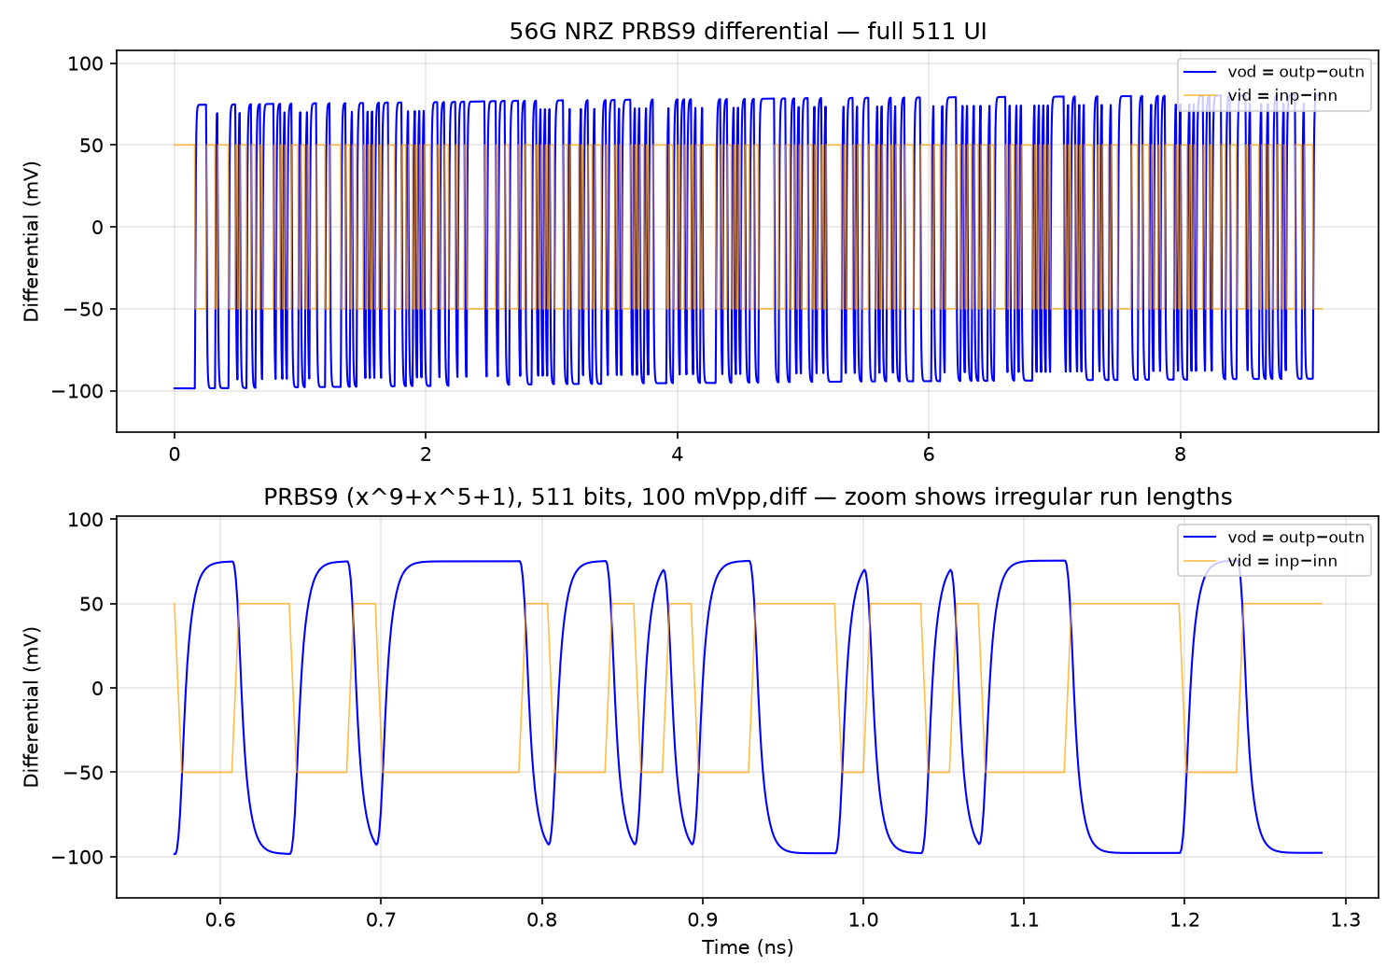
circuits/ctle56n/out/postlayout_vga_magic/tran_diff_vctrl_0p65.png
