oscarmattia/ihp-experiments/circuits/ctle56n/out/postlayout_vga_magic/tran_se_vctrl_0p28.png

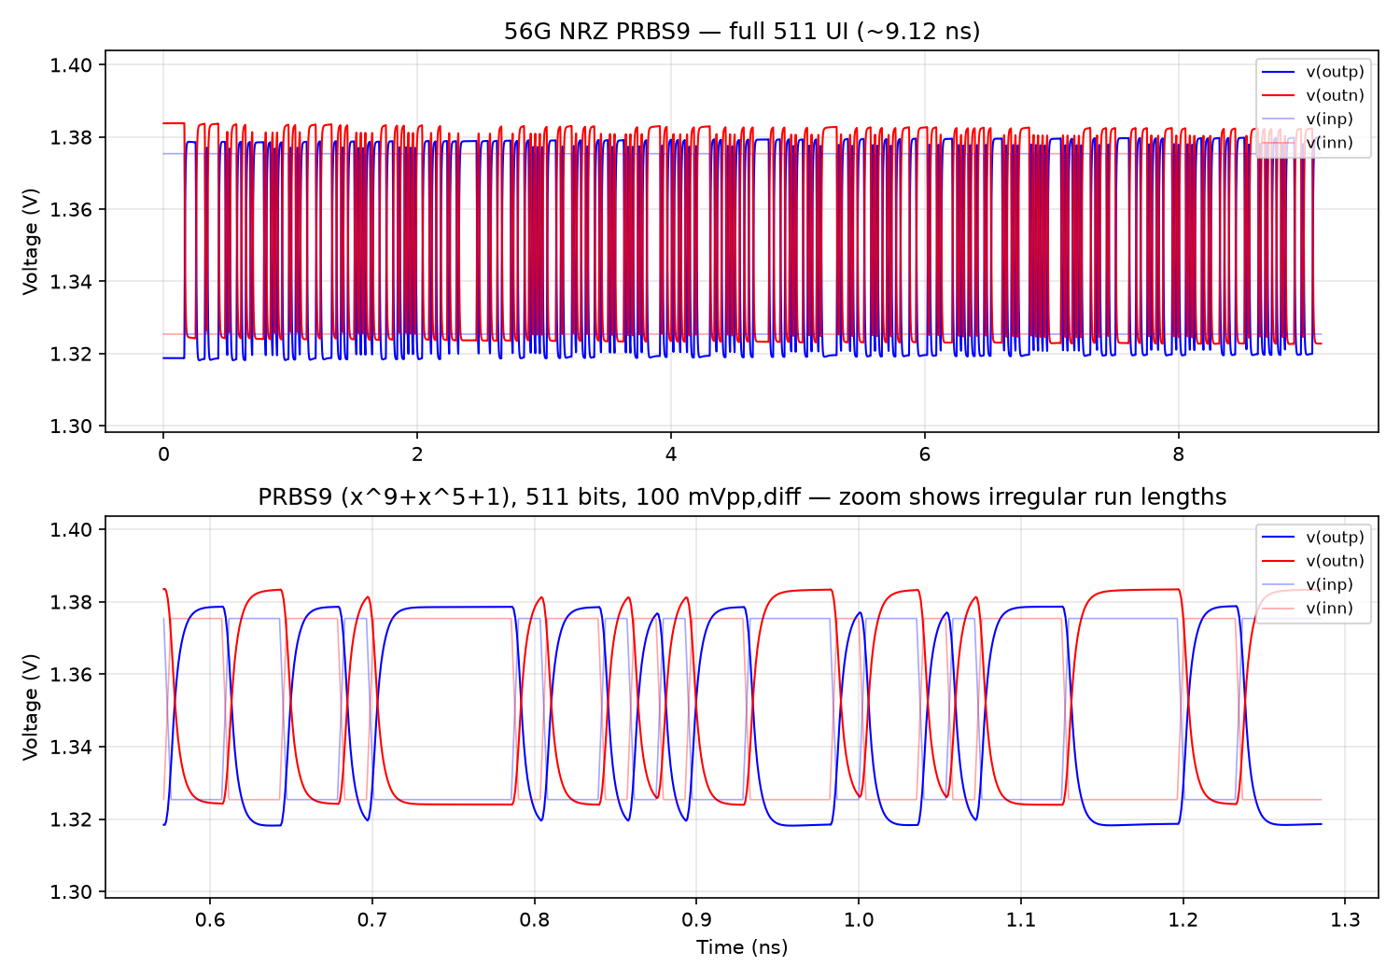
circuits/ctle56n/out/postlayout_vga_magic/tran_se_vctrl_0p28.png
