oscarmattia/ihp-experiments/circuits/ctle56n/out/vga_ideal/ac_diff_vctrl_0p70.png

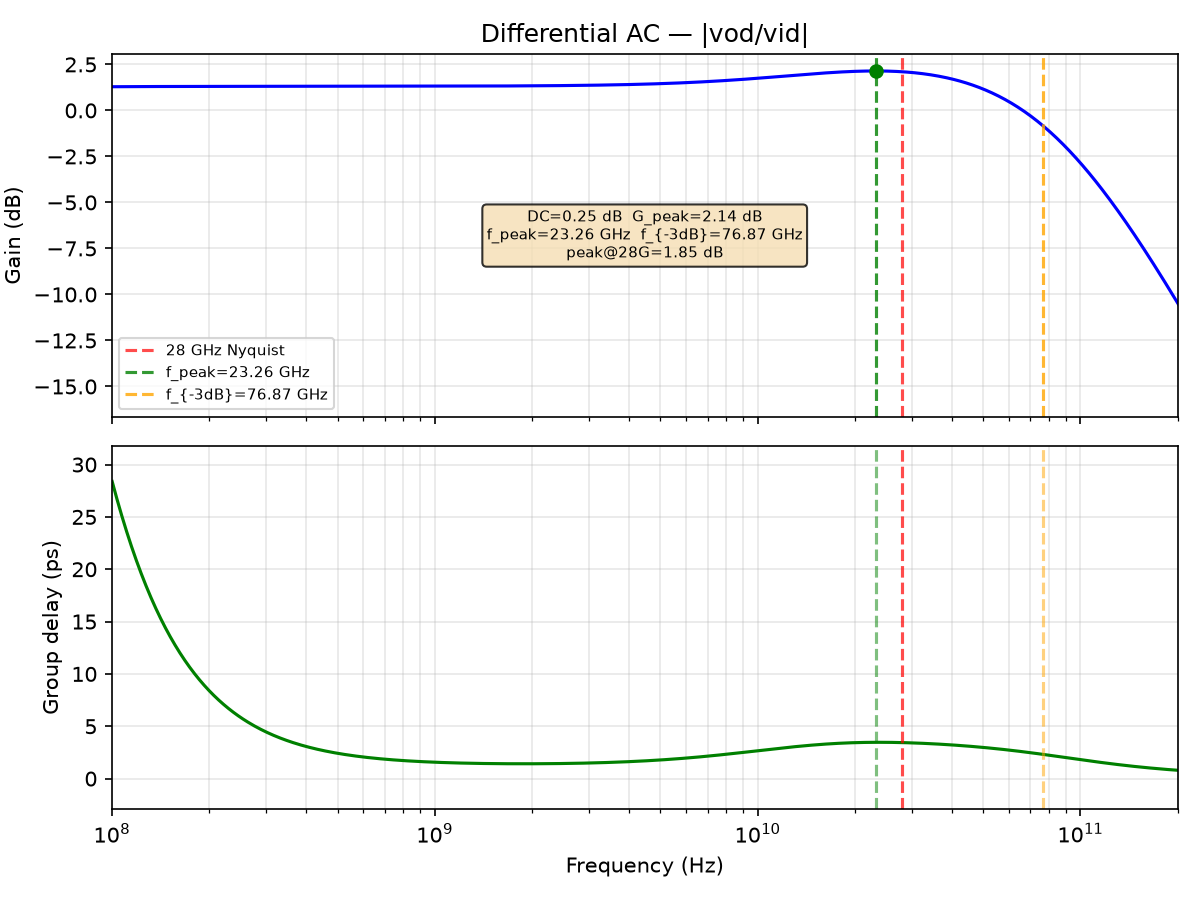
circuits/ctle56n/out/vga_ideal/ac_diff_vctrl_0p70.png
