oscarmattia/ihp-experiments/circuits/ctle56n/out/vga_ideal/ac_diff_vctrl_1p20.png

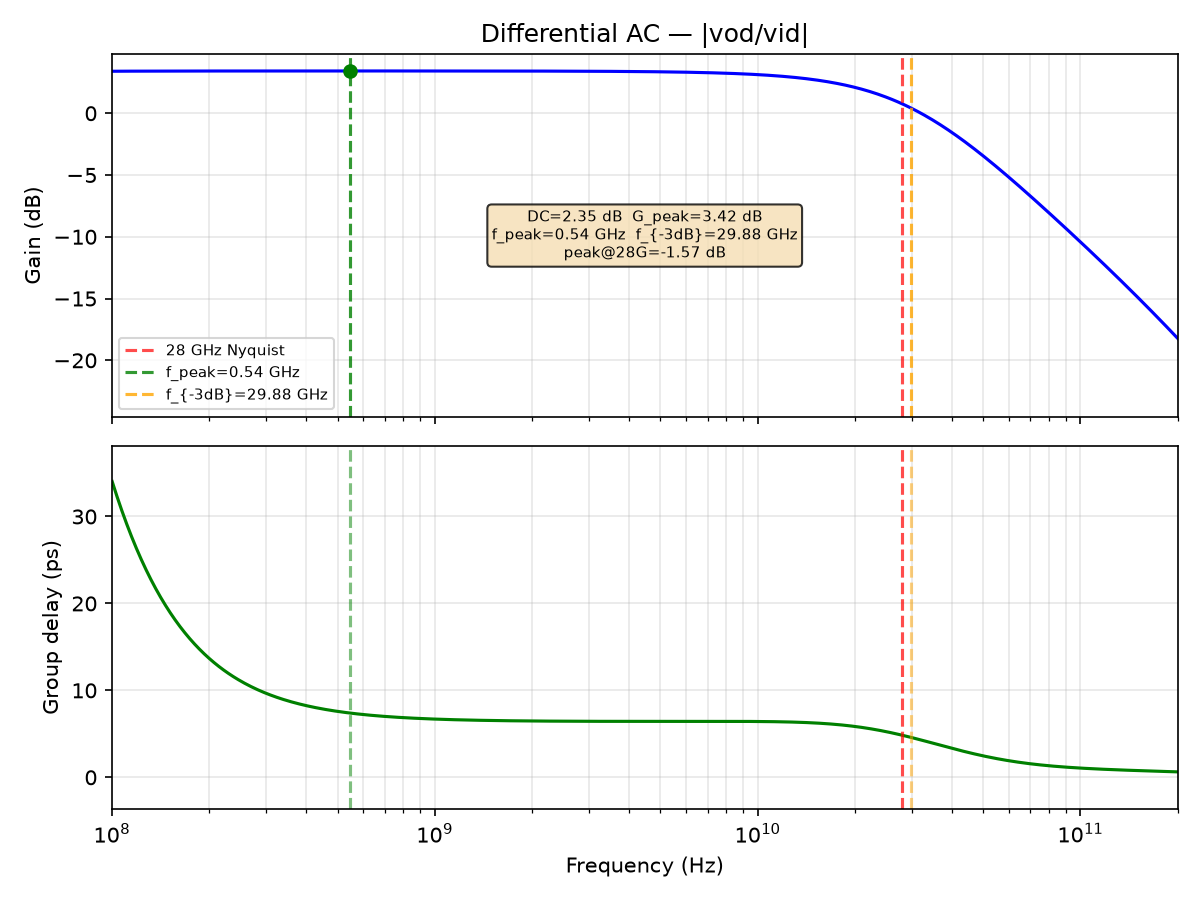
circuits/ctle56n/out/vga_ideal/ac_diff_vctrl_1p20.png
