oscarmattia/ihp-experiments/circuits/ctle56n/out/vga_ideal_cal/ac_diff_c0.60.png

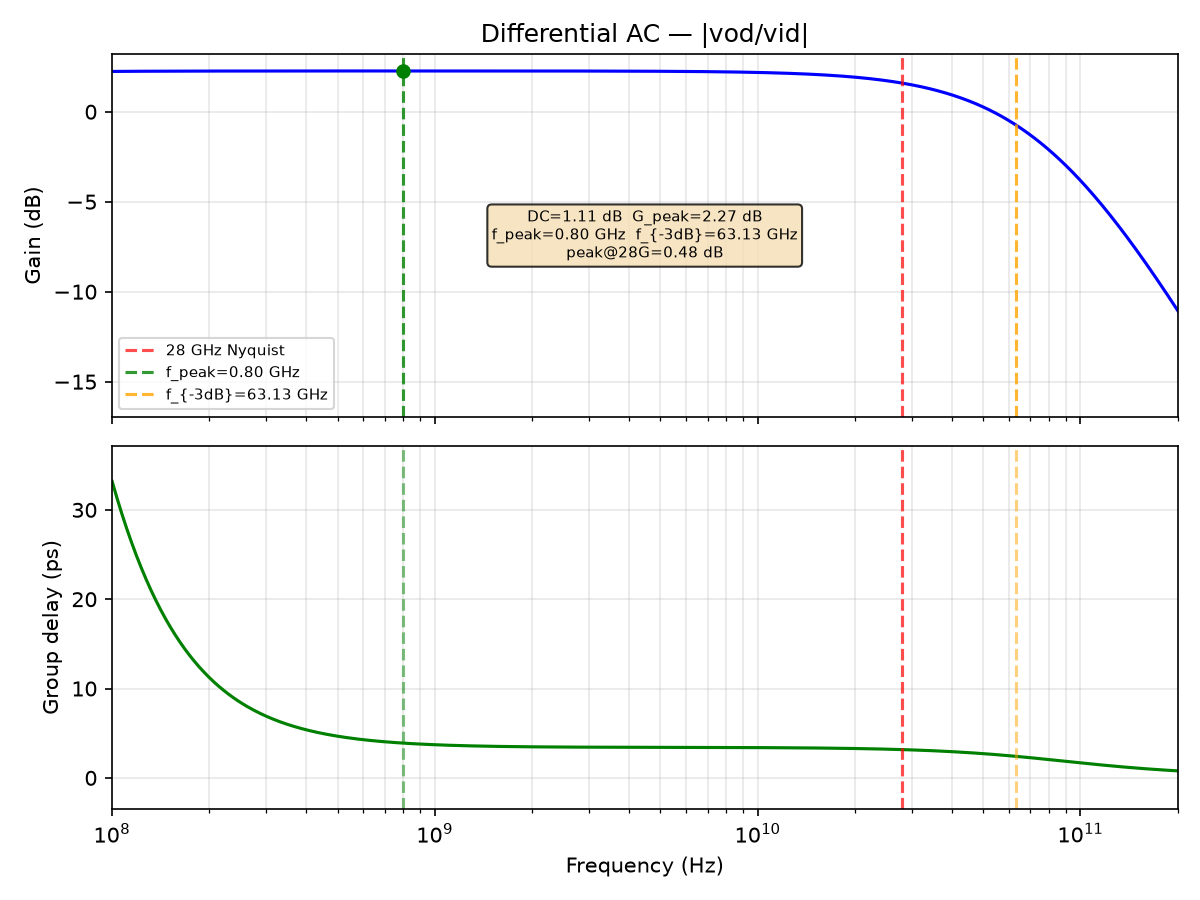
circuits/ctle56n/out/vga_ideal_cal/ac_diff_c0.60.png
