oscarmattia/ihp-experiments/circuits/ctle56n/out/vga_ideal_rs/ac_diff.png

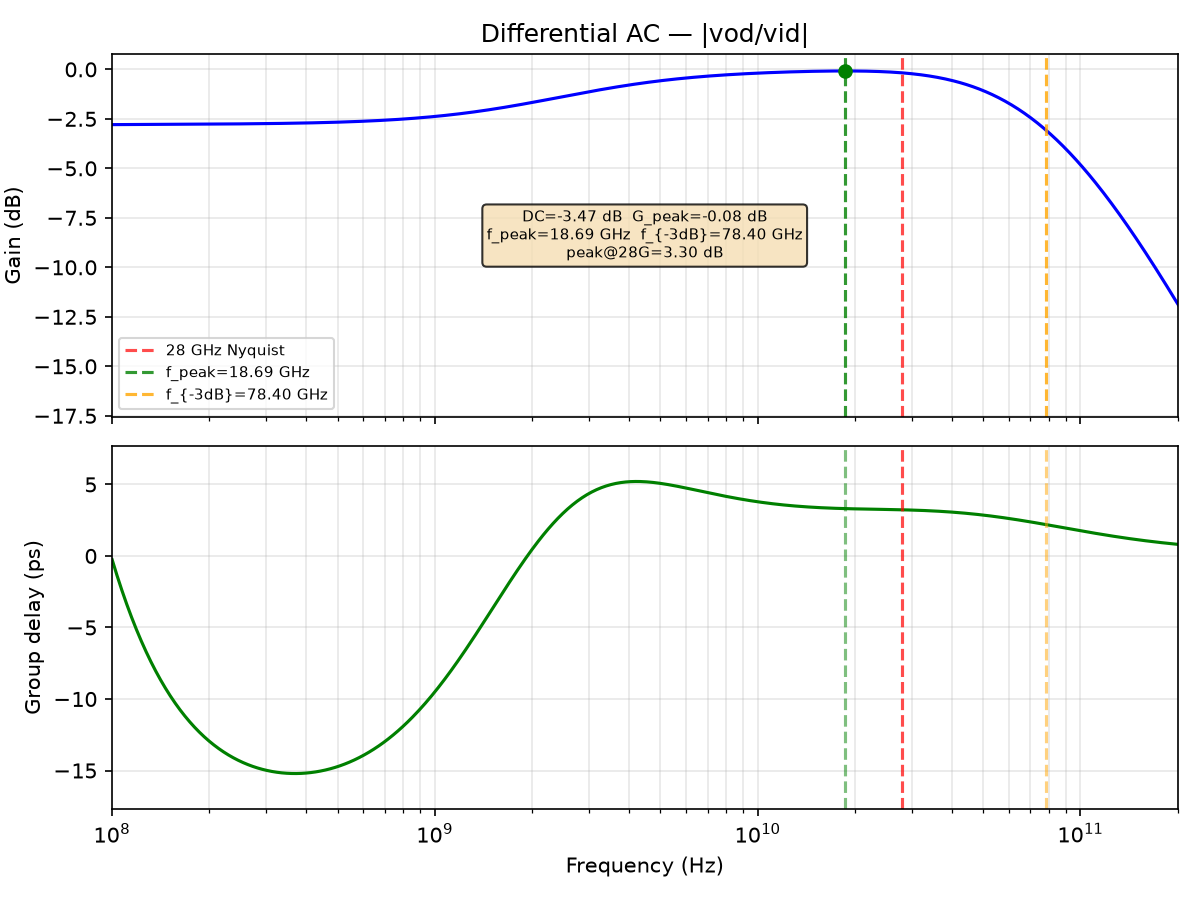
circuits/ctle56n/out/vga_ideal_rs/ac_diff.png
