oscarmattia/ihp-experiments/circuits/ctle56n/out/vga_ideal_rs/ac_diff_rs25_v0p15.png

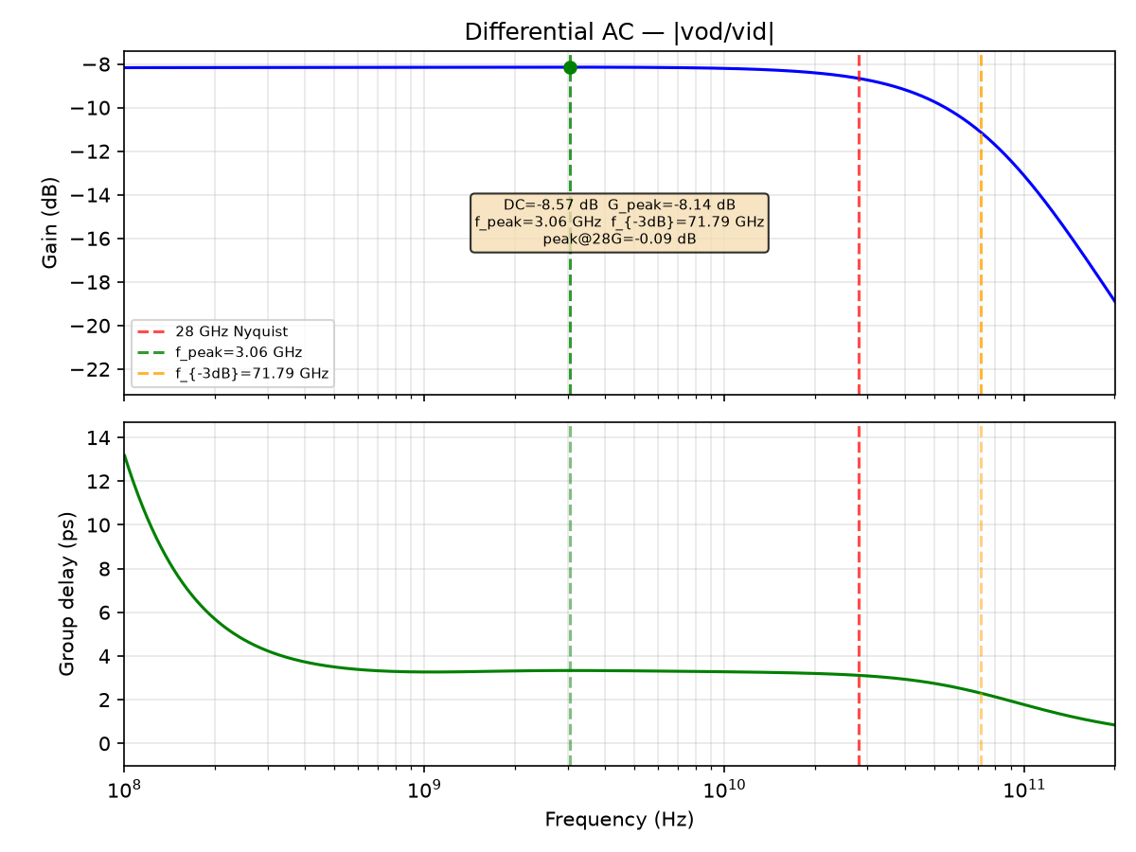
circuits/ctle56n/out/vga_ideal_rs/ac_diff_rs25_v0p15.png
