oscarmattia/ihp-experiments/circuits/ctle56n/out/vga_ideal_rs/ac_diff_rs50_v0p28.png

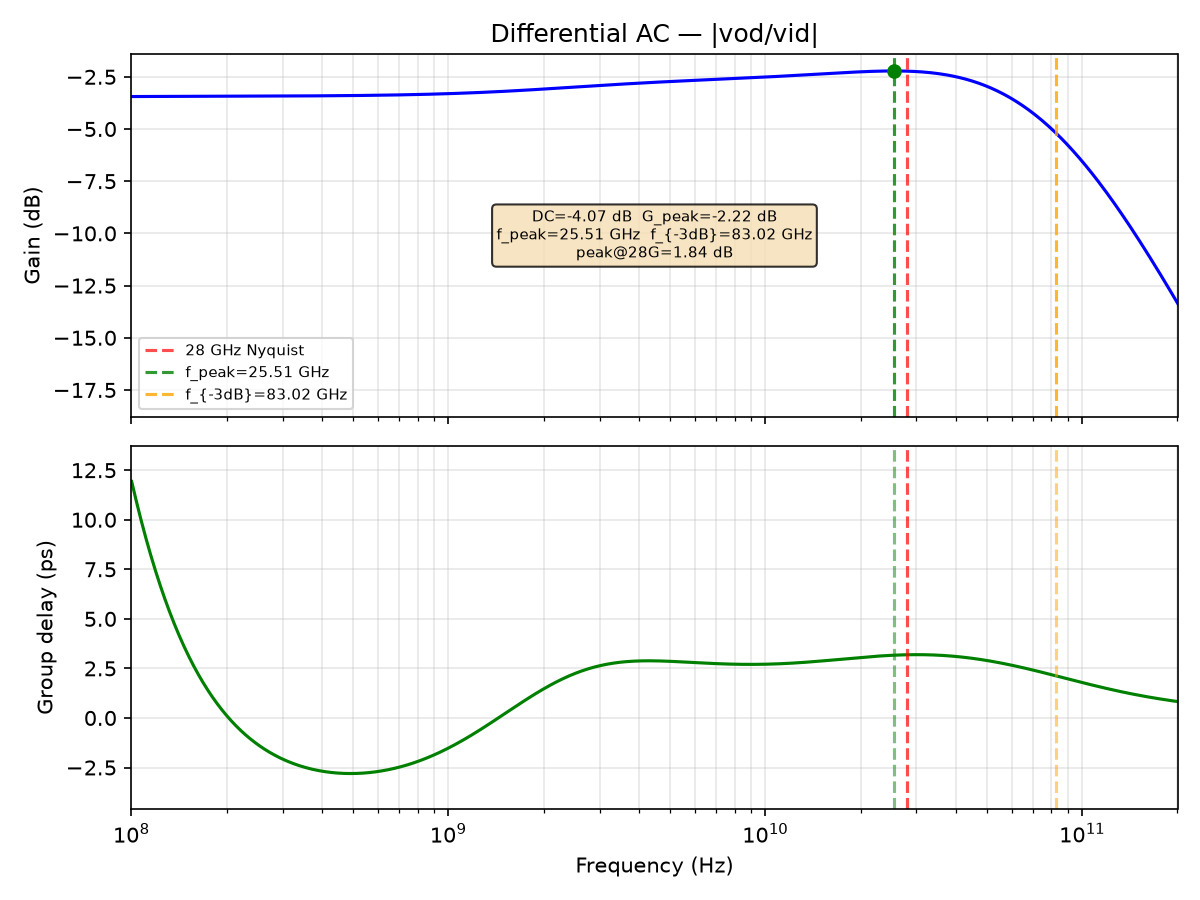
circuits/ctle56n/out/vga_ideal_rs/ac_diff_rs50_v0p28.png
