oscarmattia/ihp-experiments/circuits/ctle56n/out/vga_ideal_rs/ac_diff_rs50_v1p00.png

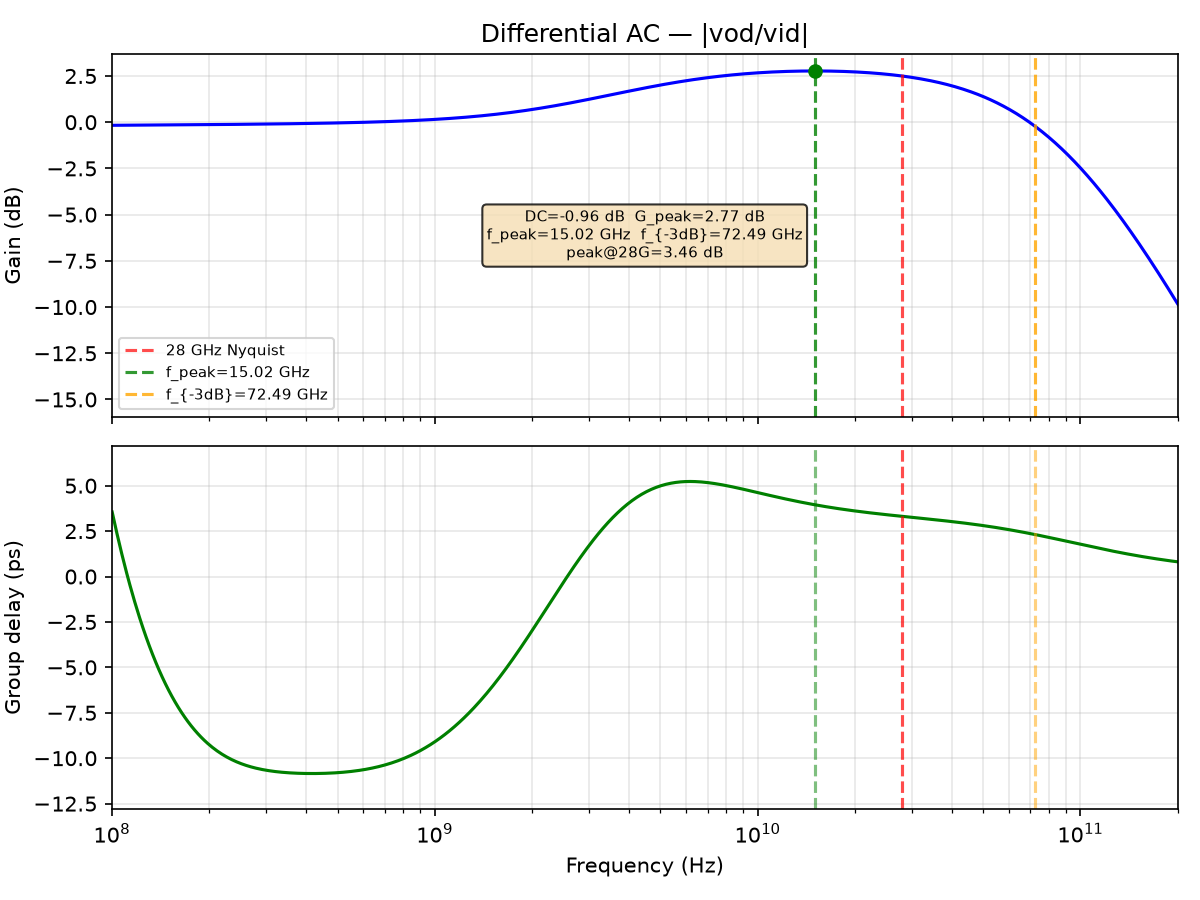
circuits/ctle56n/out/vga_ideal_rs/ac_diff_rs50_v1p00.png
