oscarmattia/ihp-experiments/circuits/ctle56n/out/vga_ideal_rs/eye_diff_rs25_v1p00.png

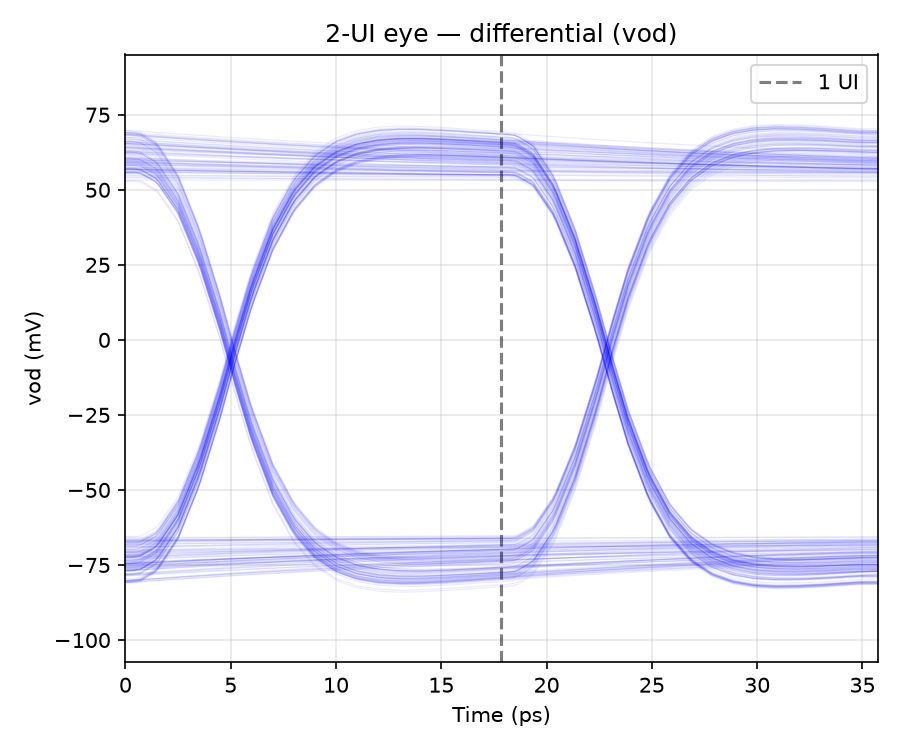
circuits/ctle56n/out/vga_ideal_rs/eye_diff_rs25_v1p00.png
