oscarmattia/ihp-experiments/circuits/ctle56n/out/vga_ideal_rs/tran_diff_rs50_v0p42.png

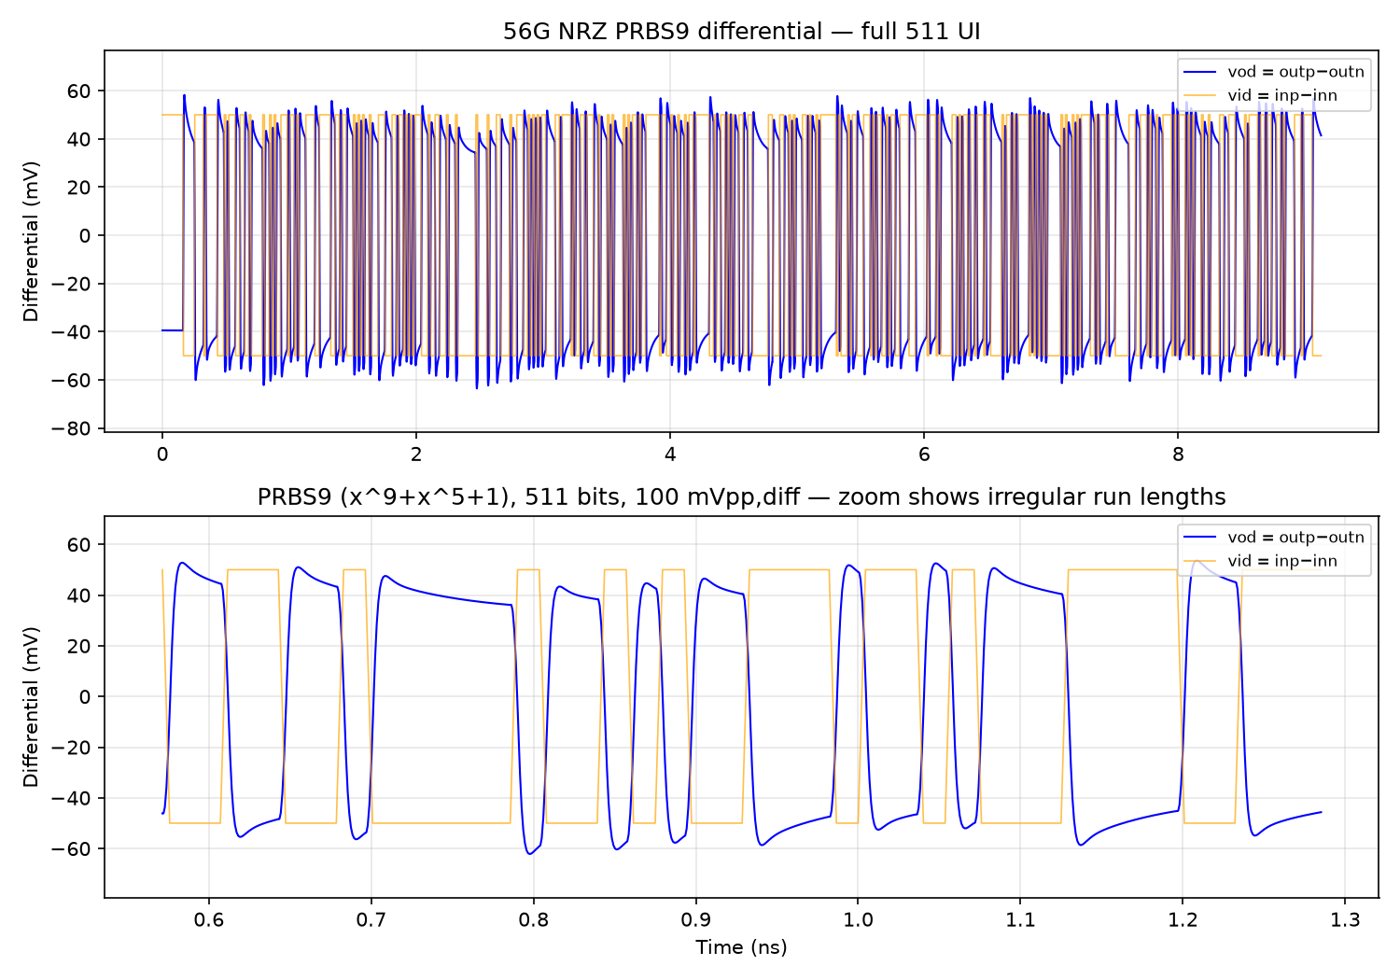
circuits/ctle56n/out/vga_ideal_rs/tran_diff_rs50_v0p42.png
