oscarmattia/ihp-experiments/circuits/ctle56n/out/vga_ideal_rs/tran_se_rs0_v1p00.png

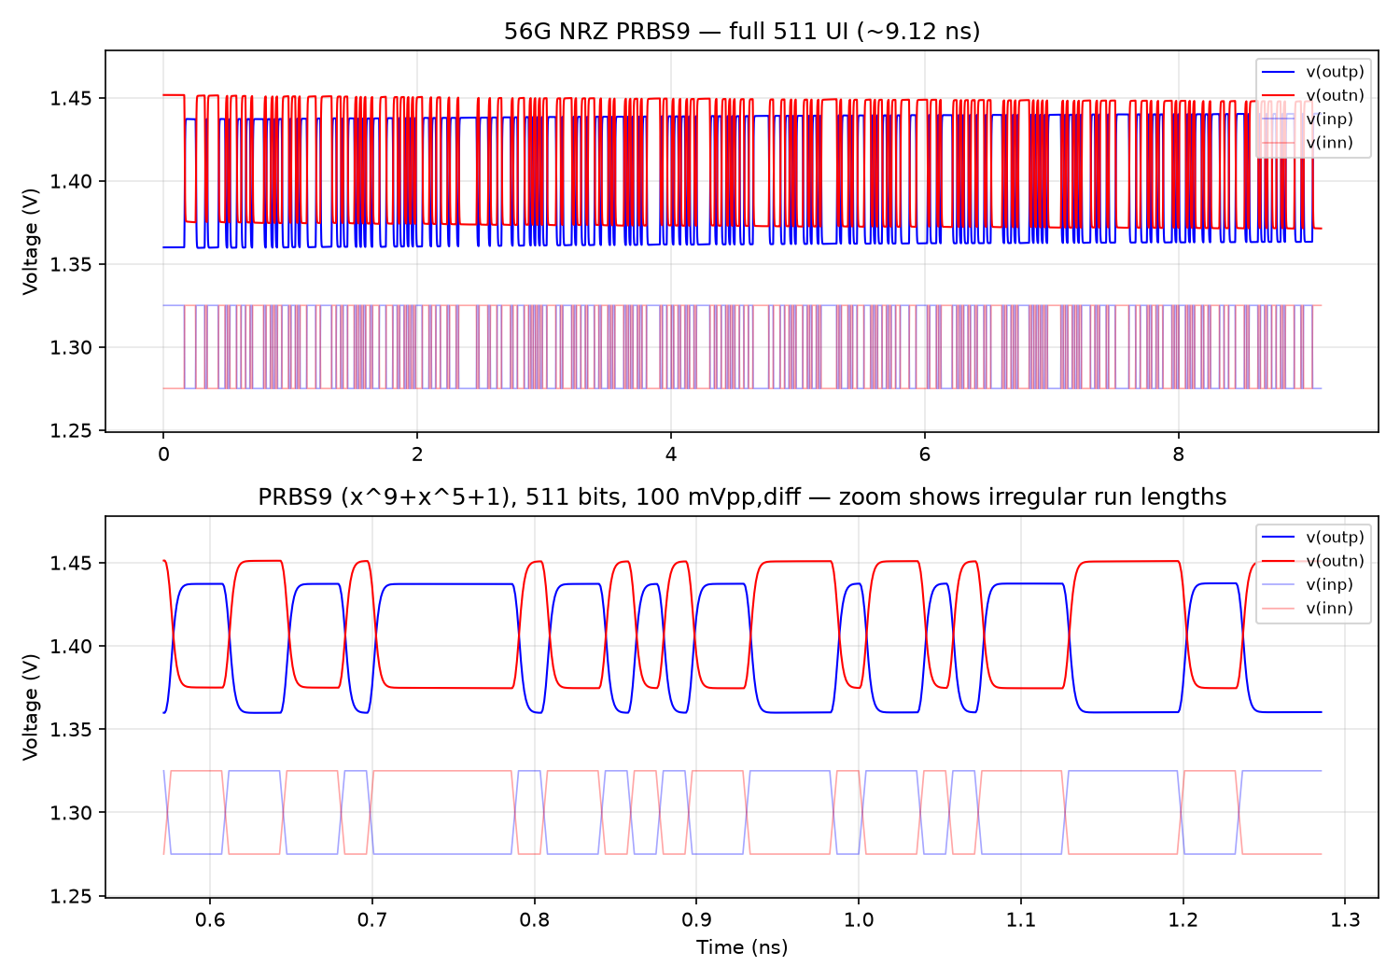
circuits/ctle56n/out/vga_ideal_rs/tran_se_rs0_v1p00.png
