oscarmattia/ihp-experiments/circuits/ctle56n/out/vga_ideal_rs/tran_se_rs50_v0p15.png

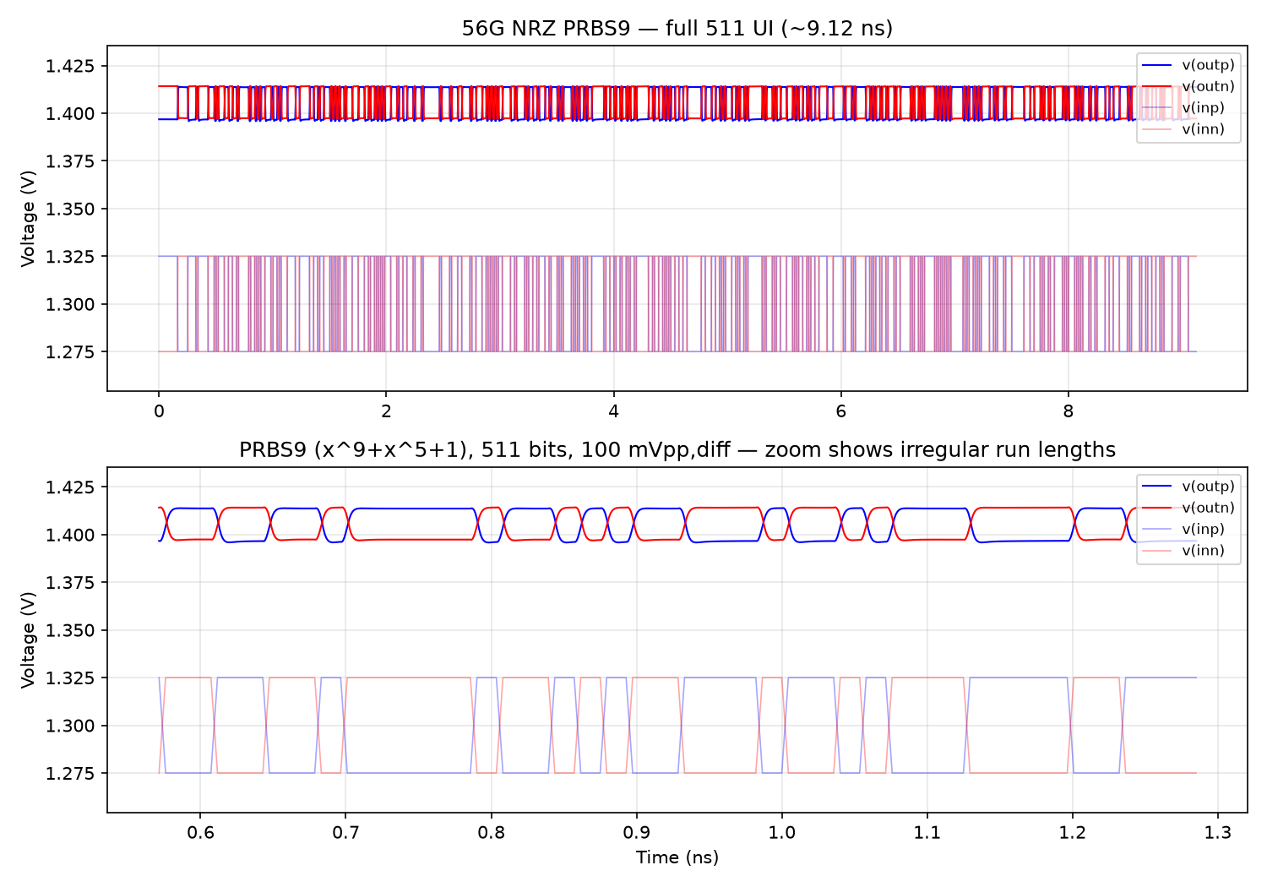
circuits/ctle56n/out/vga_ideal_rs/tran_se_rs50_v0p15.png
