oscarmattia/ihp-experiments/layout/blocks/out/ctle_stage/ctle_dut.png

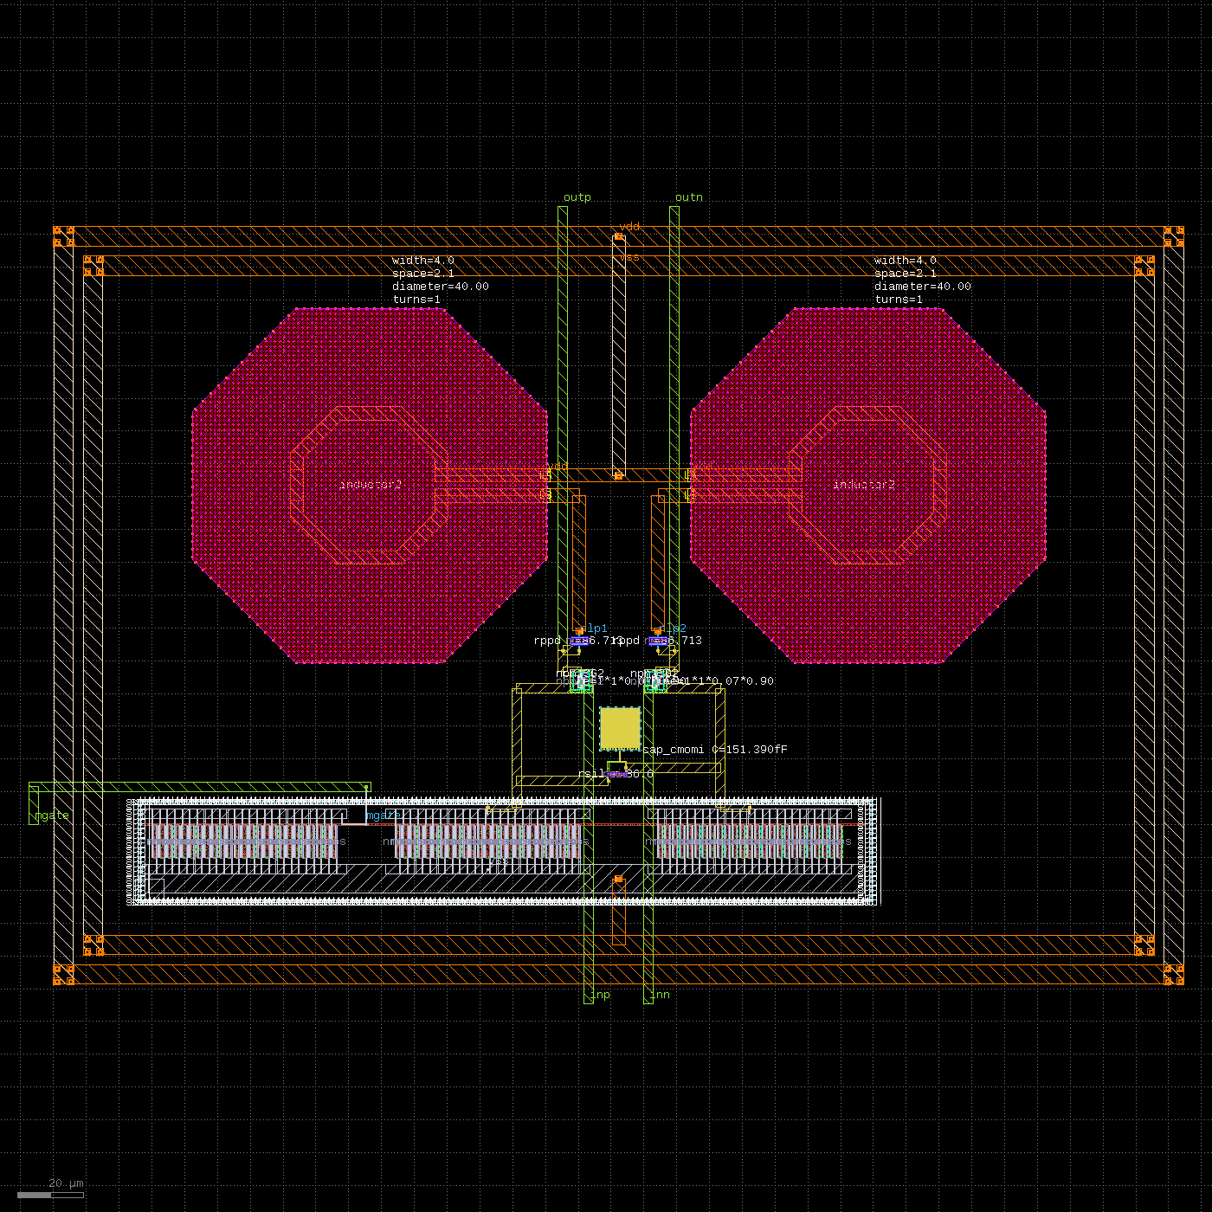
layout/blocks/out/ctle_stage/ctle_dut.png
