oscarmattia/ihp-experiments/layout/blocks/out/ctle_stage/ctle_stage.png

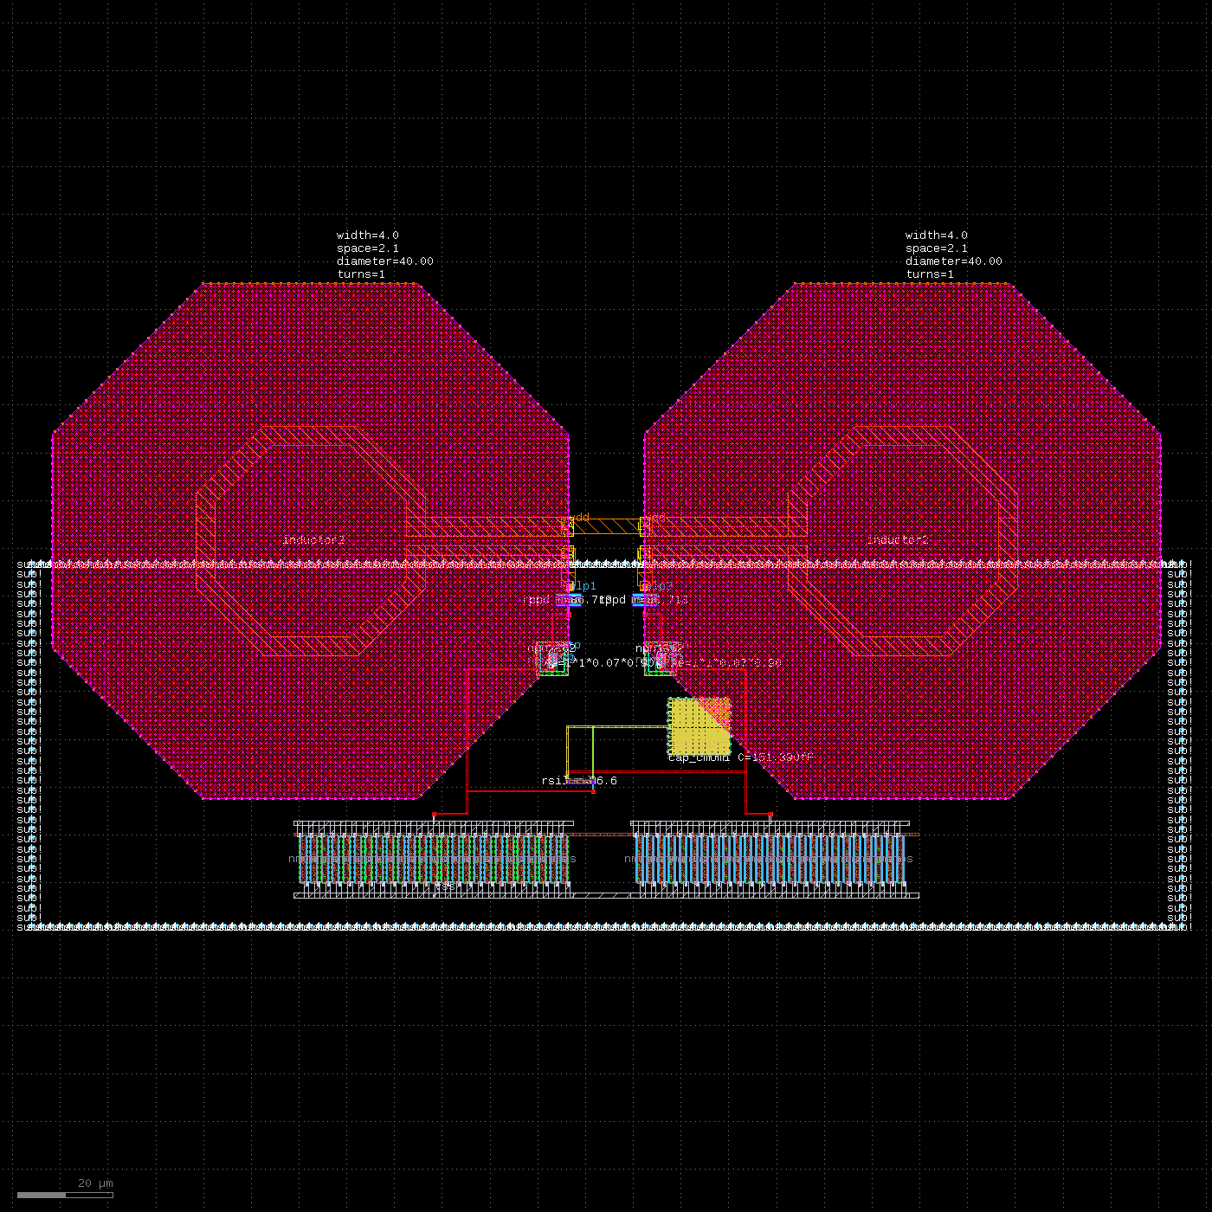
layout/blocks/out/ctle_stage/ctle_stage.png
