oscarmattia/ihp-experiments/layout/blocks/out/driver_stage/driver_dut.png

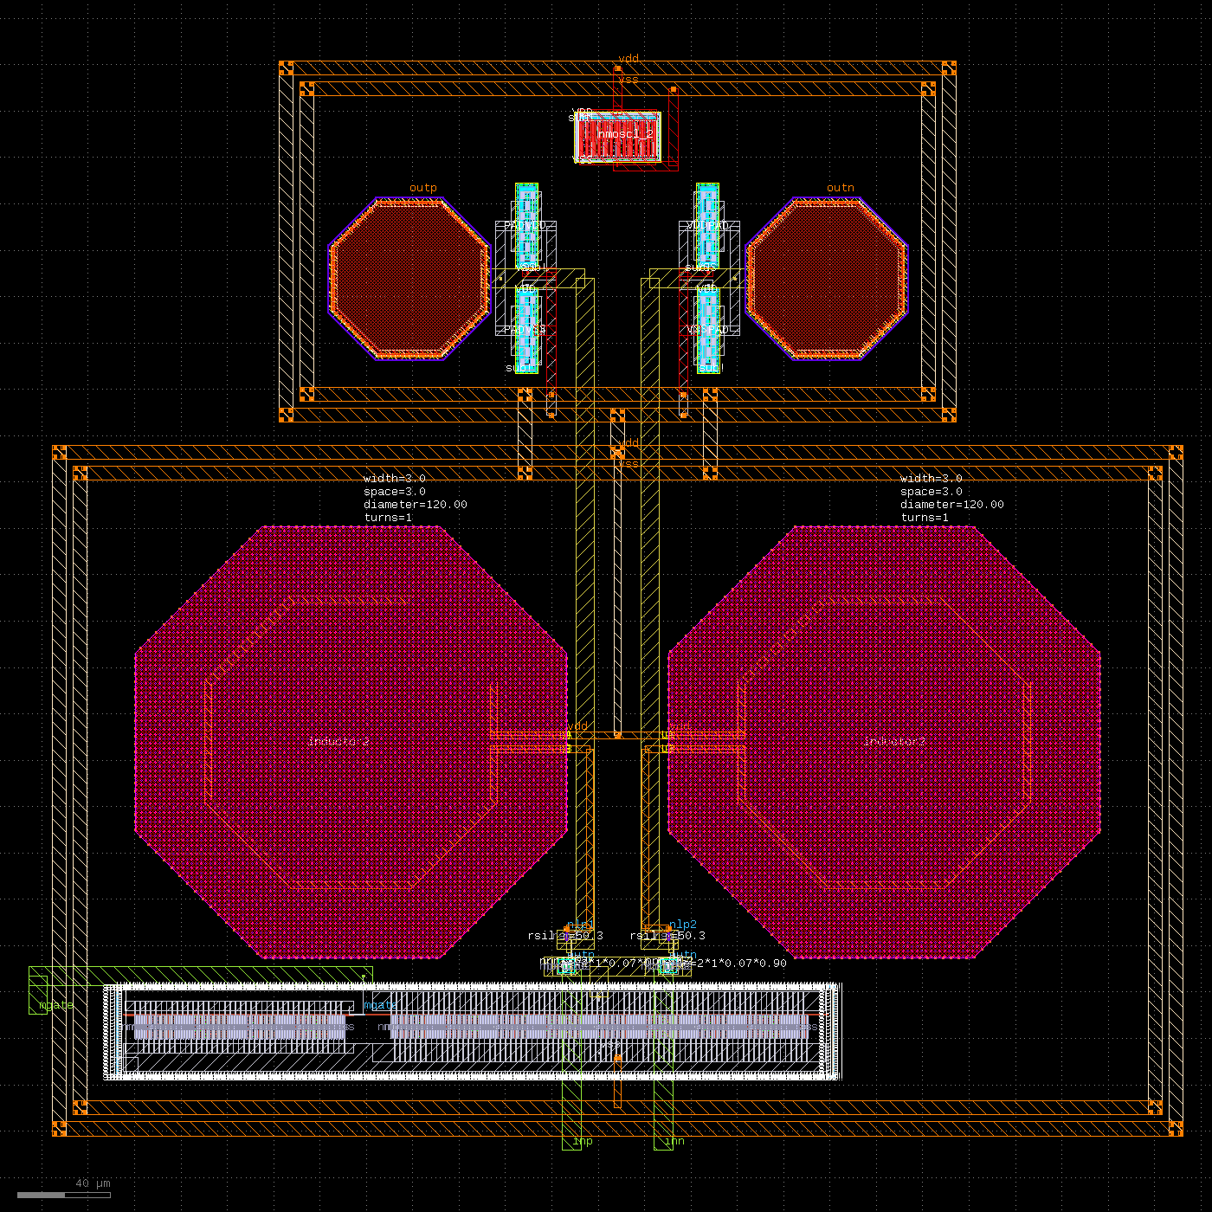
layout/blocks/out/driver_stage/driver_dut.png
