oscarmattia/ihp-experiments/layout/blocks/out/png/degeneration_network.png

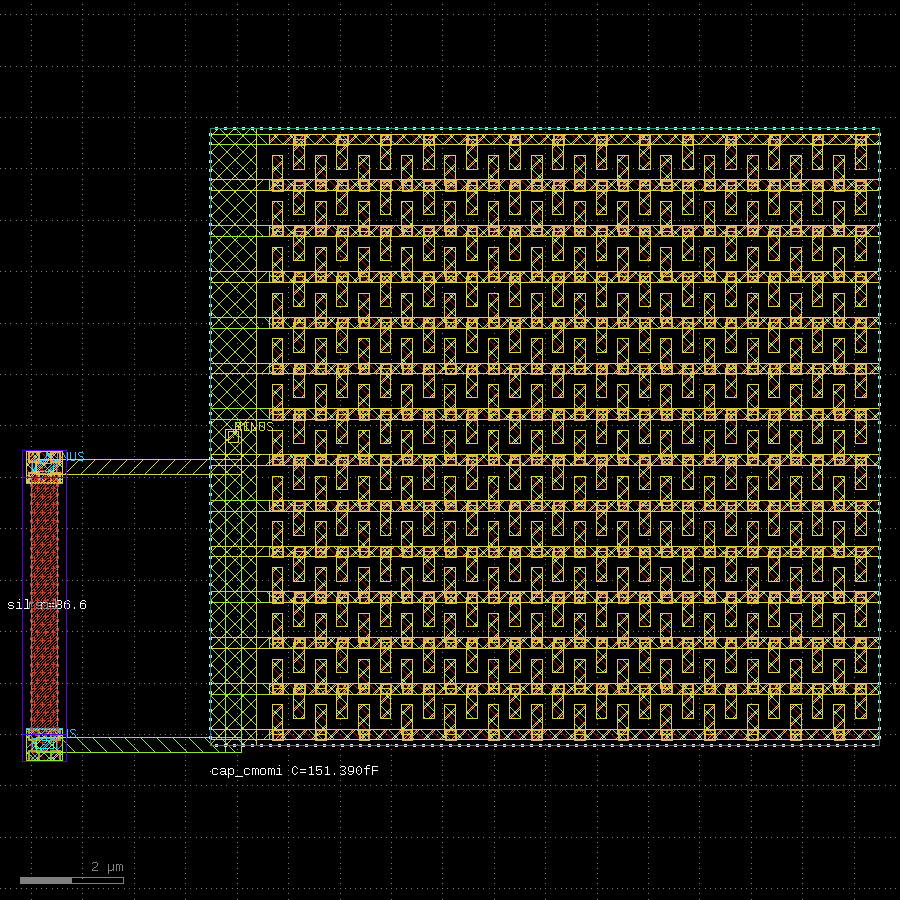
layout/blocks/out/png/degeneration_network.png
