oscarmattia/ihp-experiments/layout/blocks/out/png/hbt_diff_pair.png

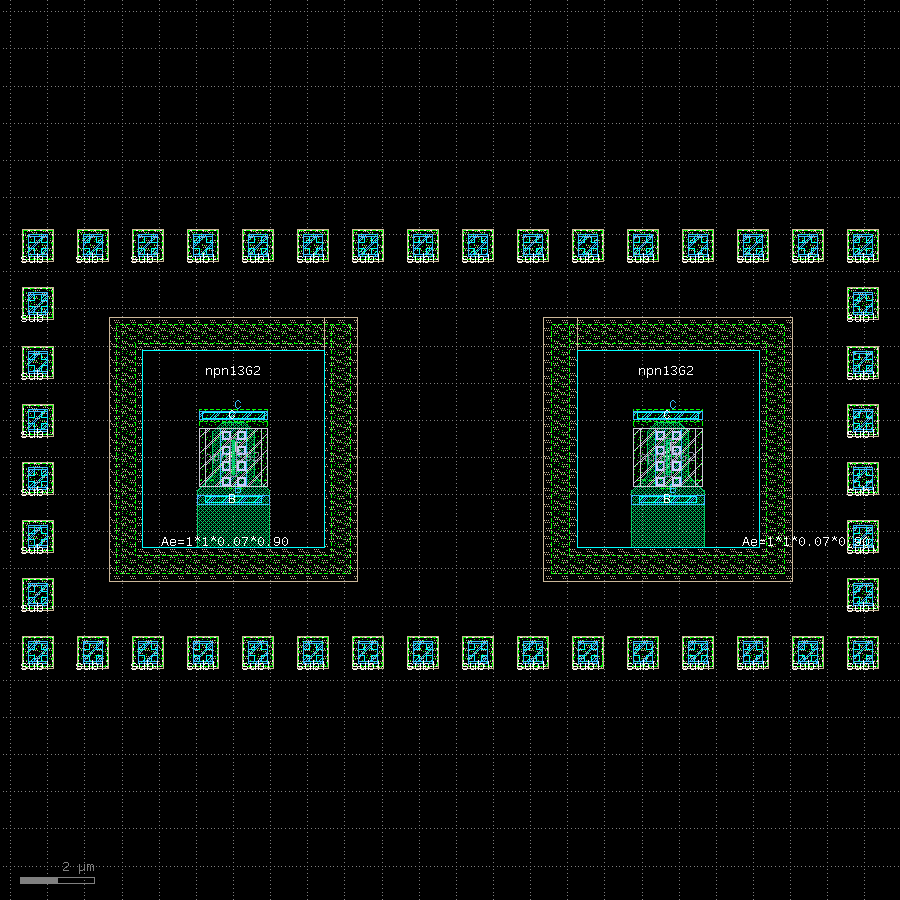
layout/blocks/out/png/hbt_diff_pair.png
