oscarmattia/ihp-experiments/layout/blocks/out/png/rppd_load_pair.png

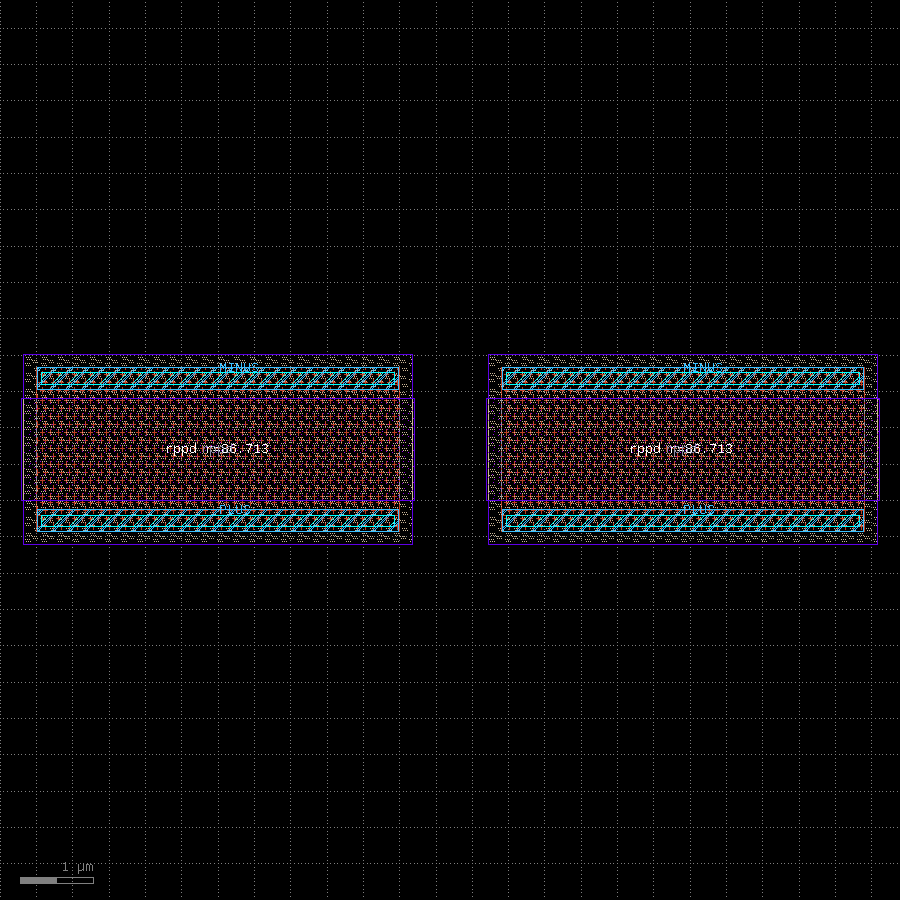
layout/blocks/out/png/rppd_load_pair.png
