oscarmattia/ihp-experiments/layout/blocks/out/png/shunt_coil.png

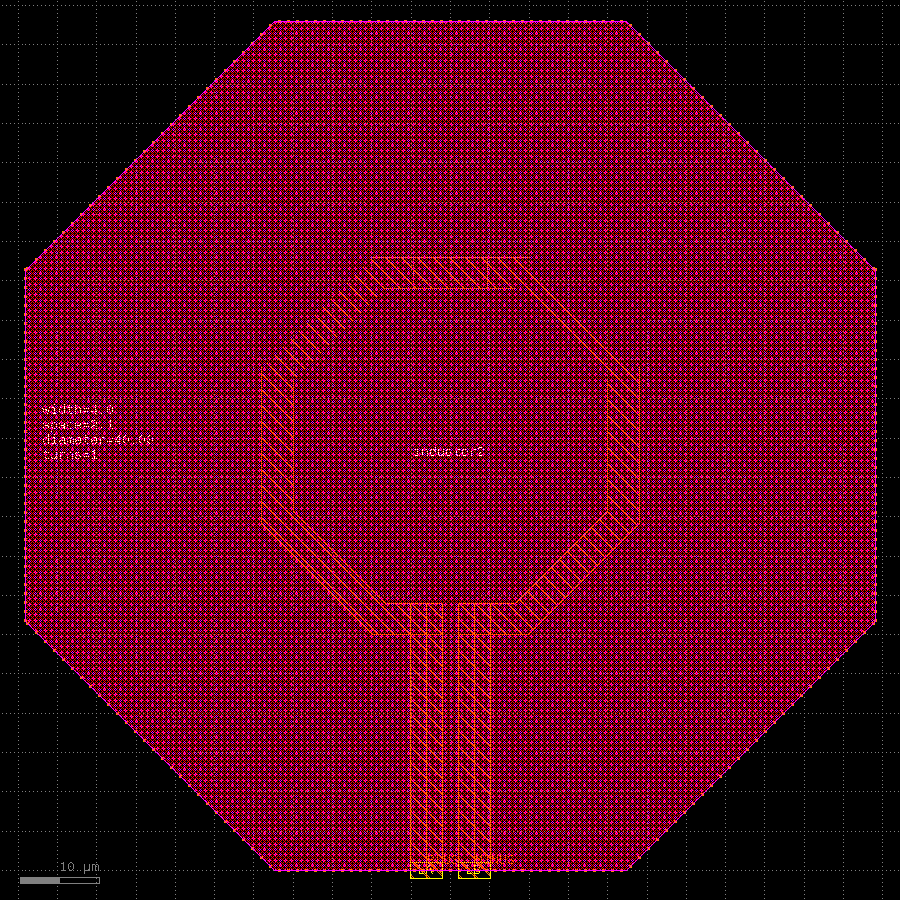
layout/blocks/out/png/shunt_coil.png
