oscarmattia/ihp-experiments/layout/blocks/out/term_stage/_isolate/out/term_stage/term_dut.png

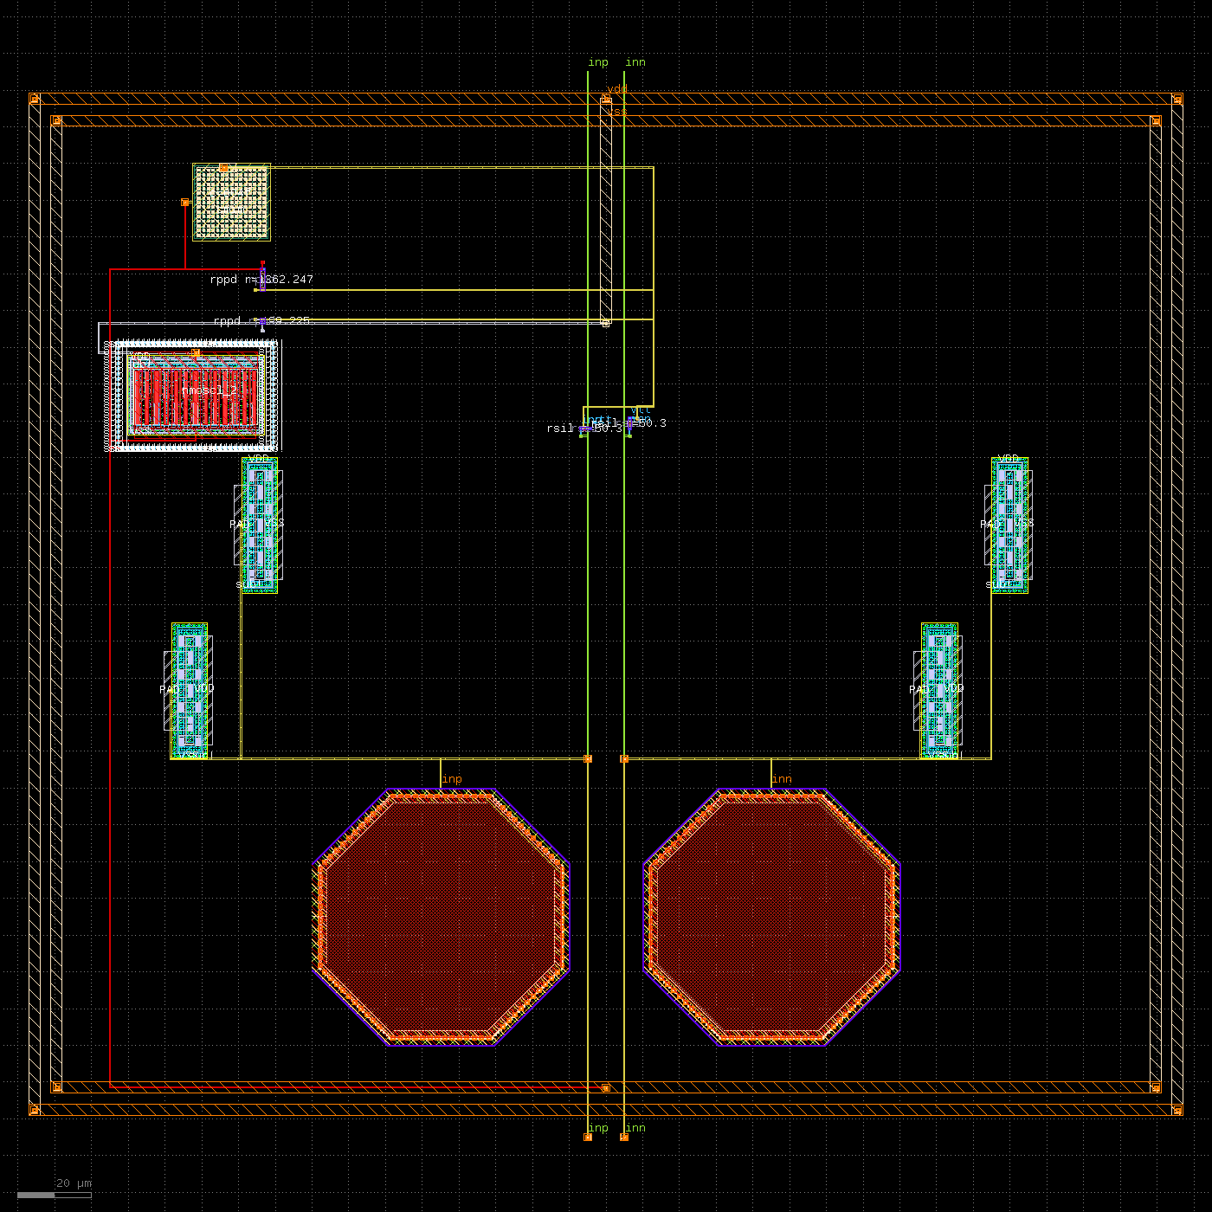
layout/blocks/out/term_stage/_isolate/out/term_stage/term_dut.png
