oscarmattia/ihp-experiments/layout/blocks/out/vga_stage/vga_dut.png

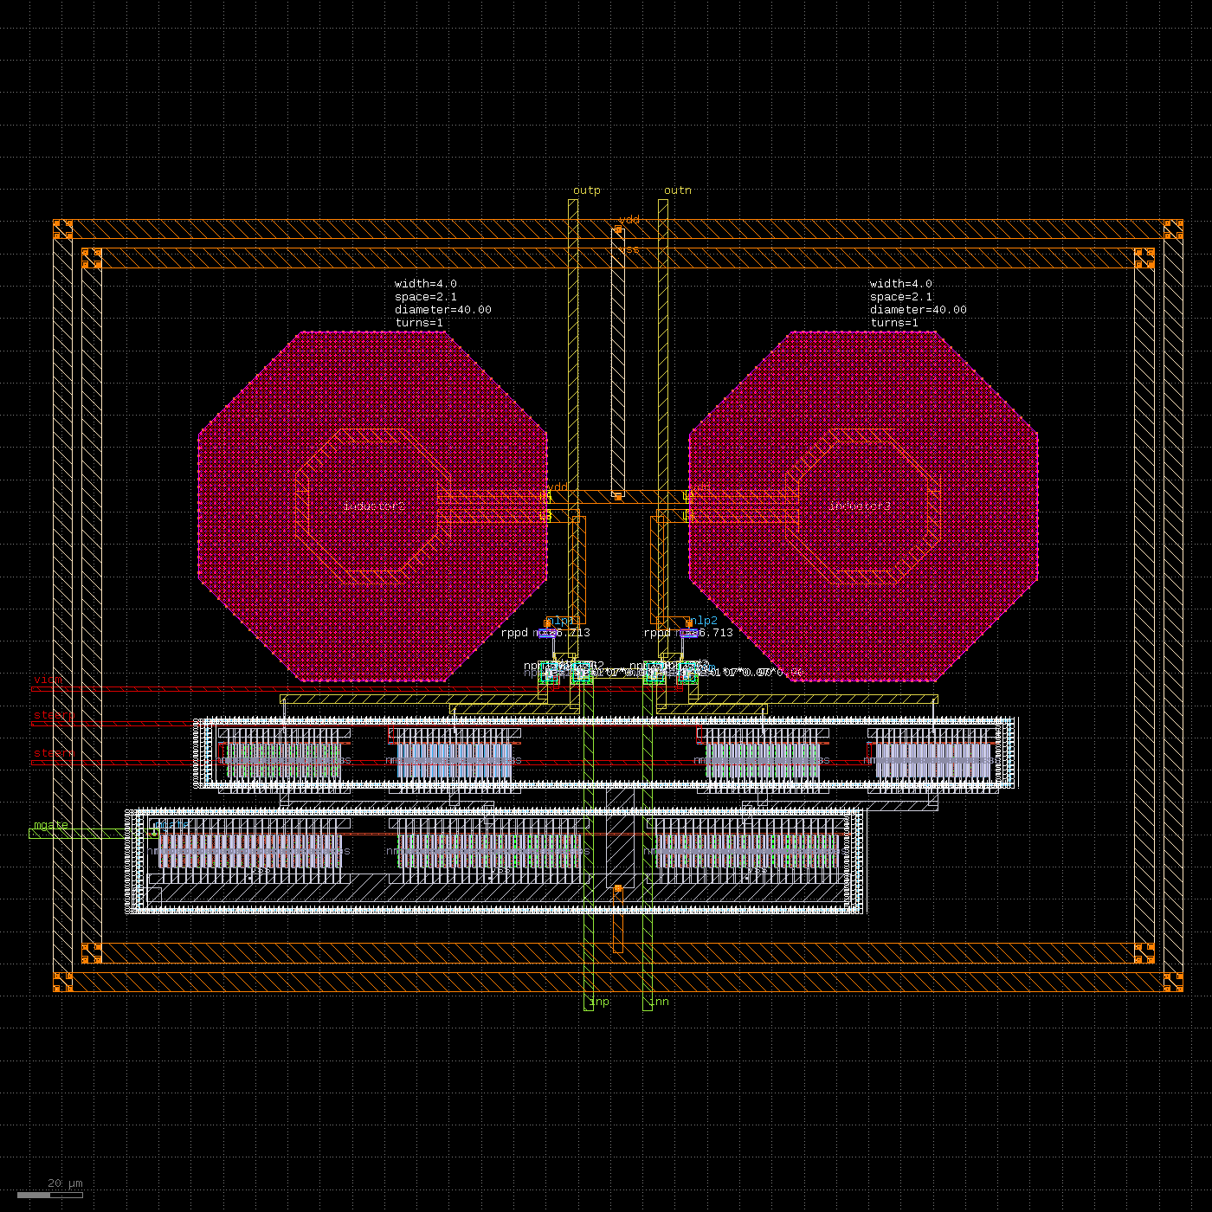
layout/blocks/out/vga_stage/vga_dut.png
