oscarmattia/ihp-experiments/layout/devices/out/png/bondpad_70um.png

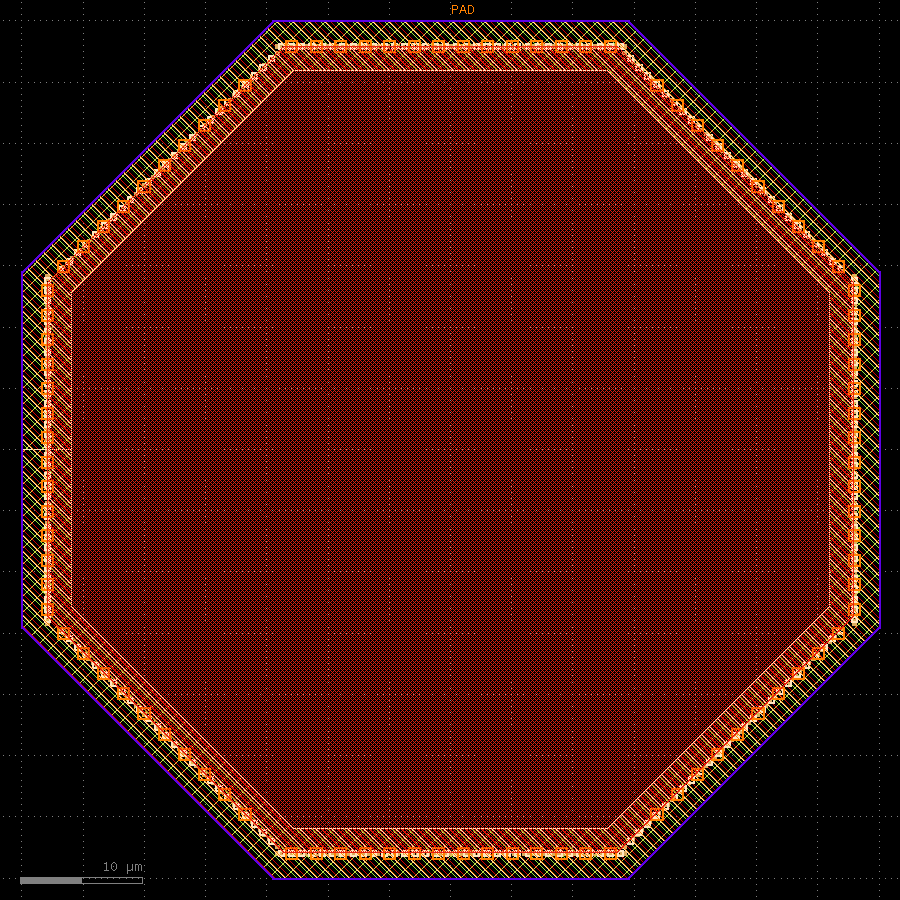
layout/devices/out/png/bondpad_70um.png
