oscarmattia/ihp-experiments/layout/devices/out/png/cmim_decap.png

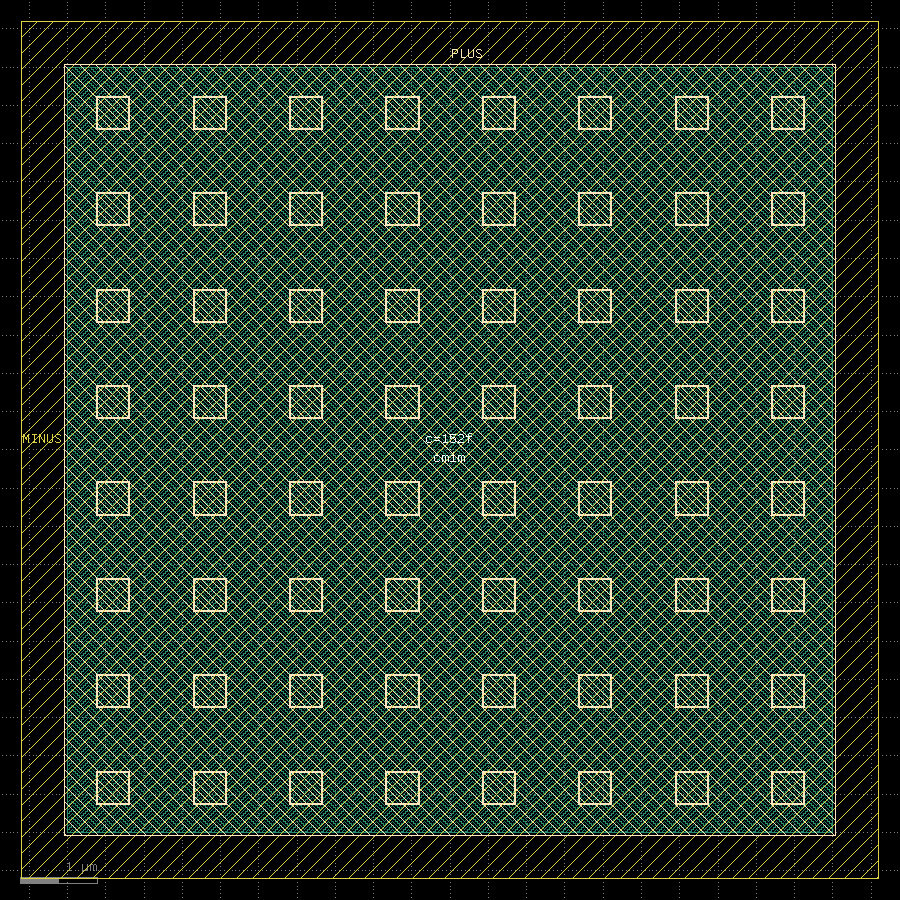
layout/devices/out/png/cmim_decap.png
