oscarmattia/ihp-experiments/layout/devices/out/png/cmim_vtt_decap.png

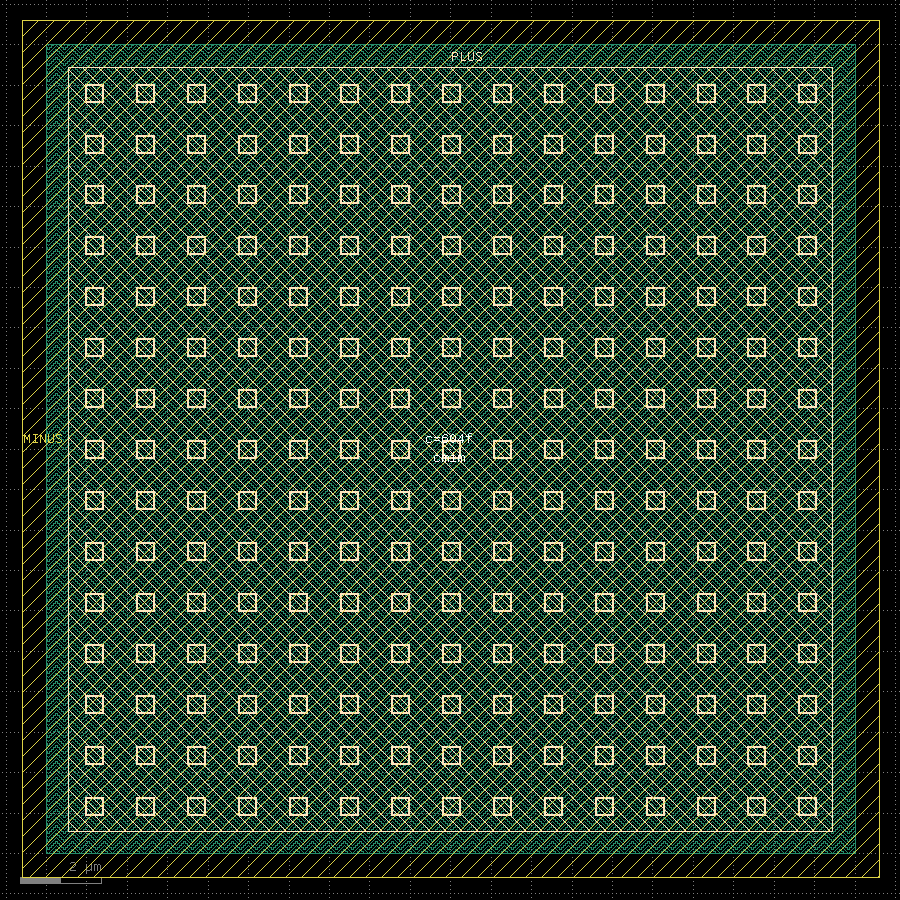
layout/devices/out/png/cmim_vtt_decap.png
