oscarmattia/ihp-experiments/layout/devices/out/png/cmomi_cs.png

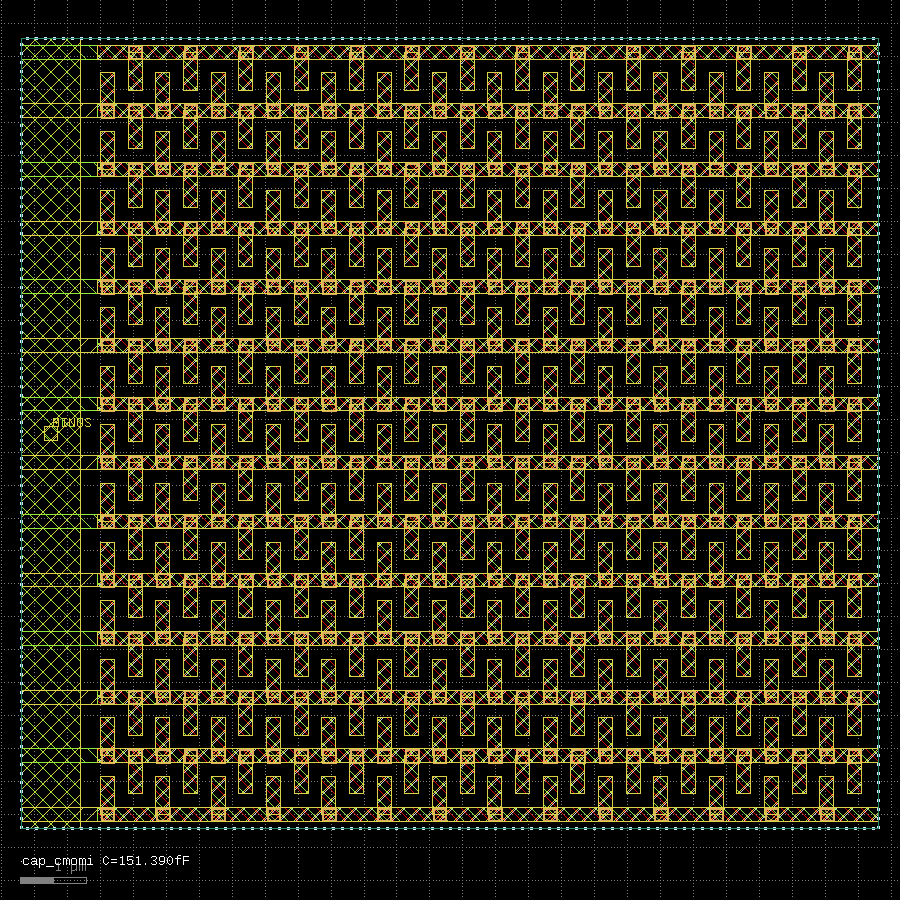
layout/devices/out/png/cmomi_cs.png
