oscarmattia/ihp-experiments/layout/devices/out/png/esd_diodevdd_2kv.png

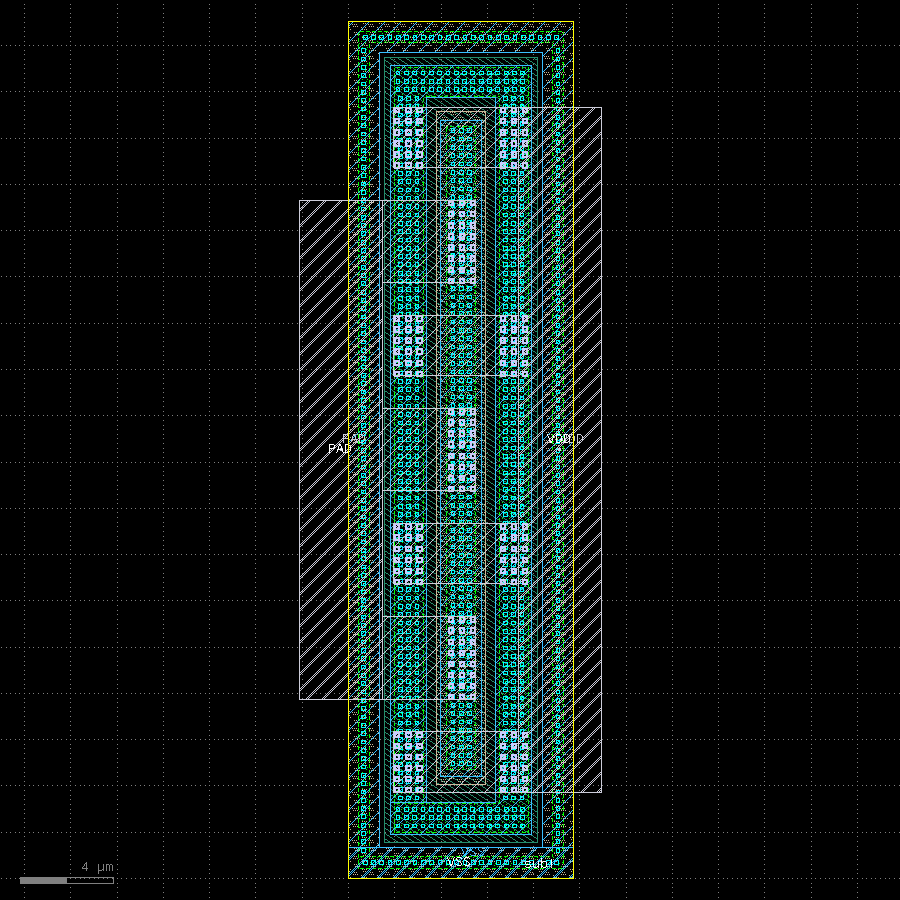
layout/devices/out/png/esd_diodevdd_2kv.png
