oscarmattia/ihp-experiments/layout/devices/out/png/esd_diodevss_2kv.png

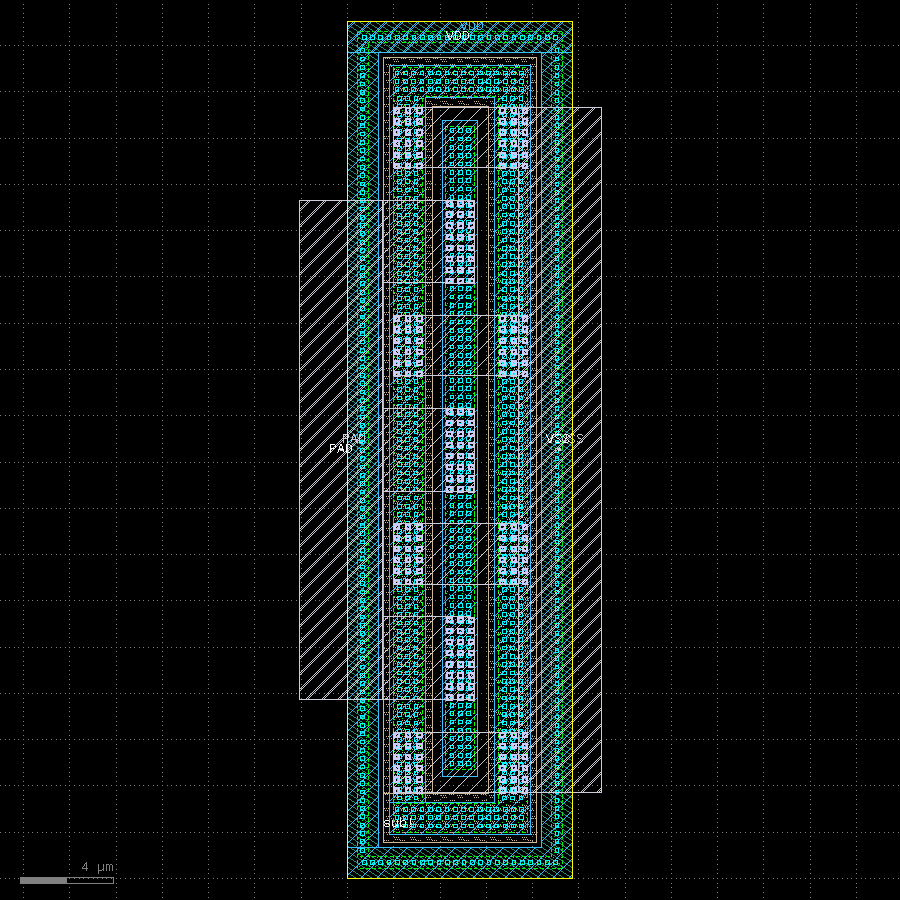
layout/devices/out/png/esd_diodevss_2kv.png
