oscarmattia/ihp-experiments/layout/devices/out/png/esd_nmoscl_2.png

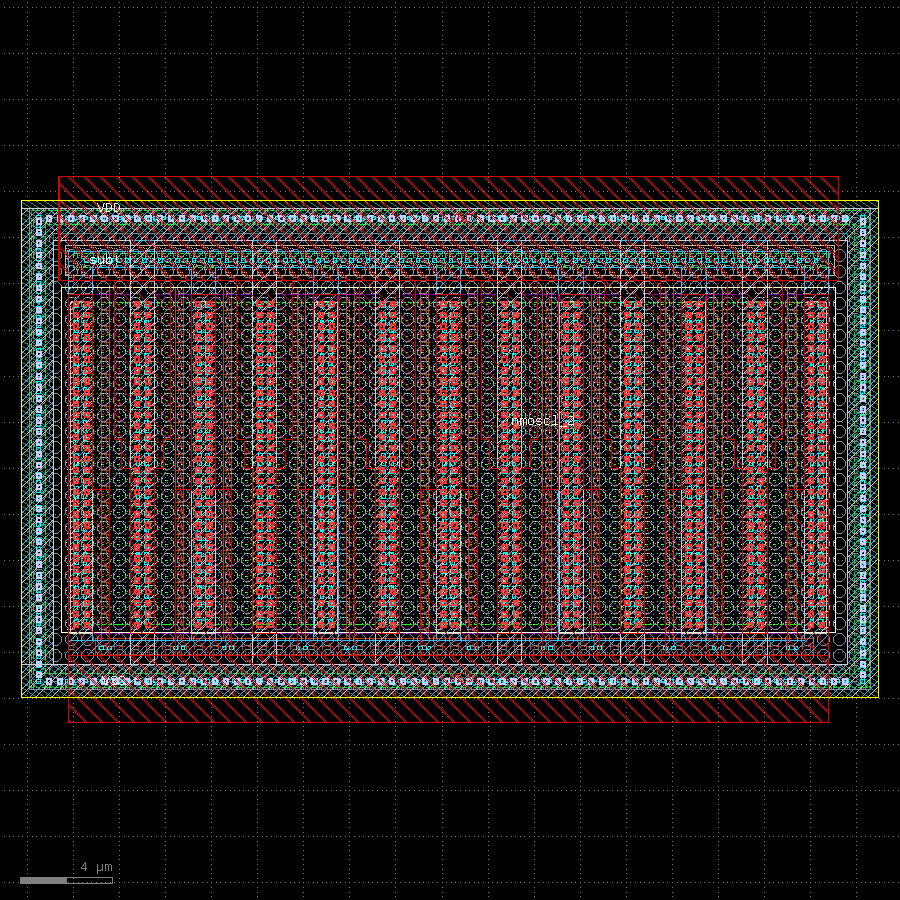
layout/devices/out/png/esd_nmoscl_2.png
