oscarmattia/ihp-experiments/layout/devices/out/png/nmos_char_l0p25.png

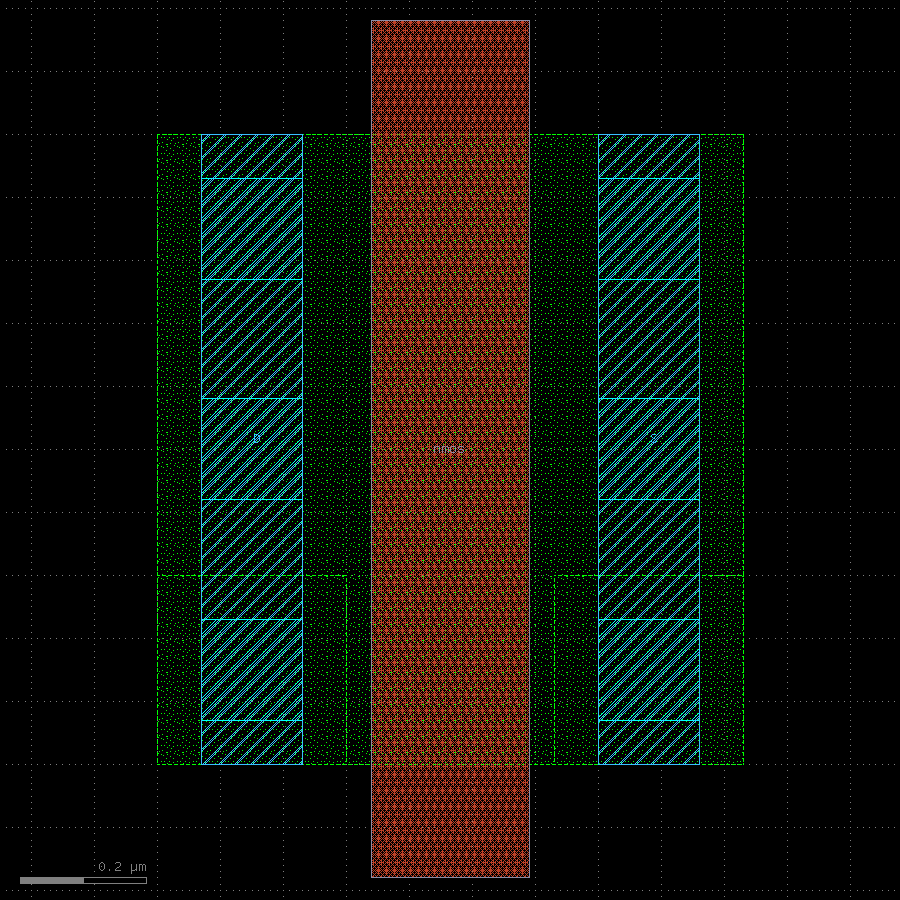
layout/devices/out/png/nmos_char_l0p25.png
