oscarmattia/ihp-experiments/layout/devices/out/png/nmos_tail_unit.png

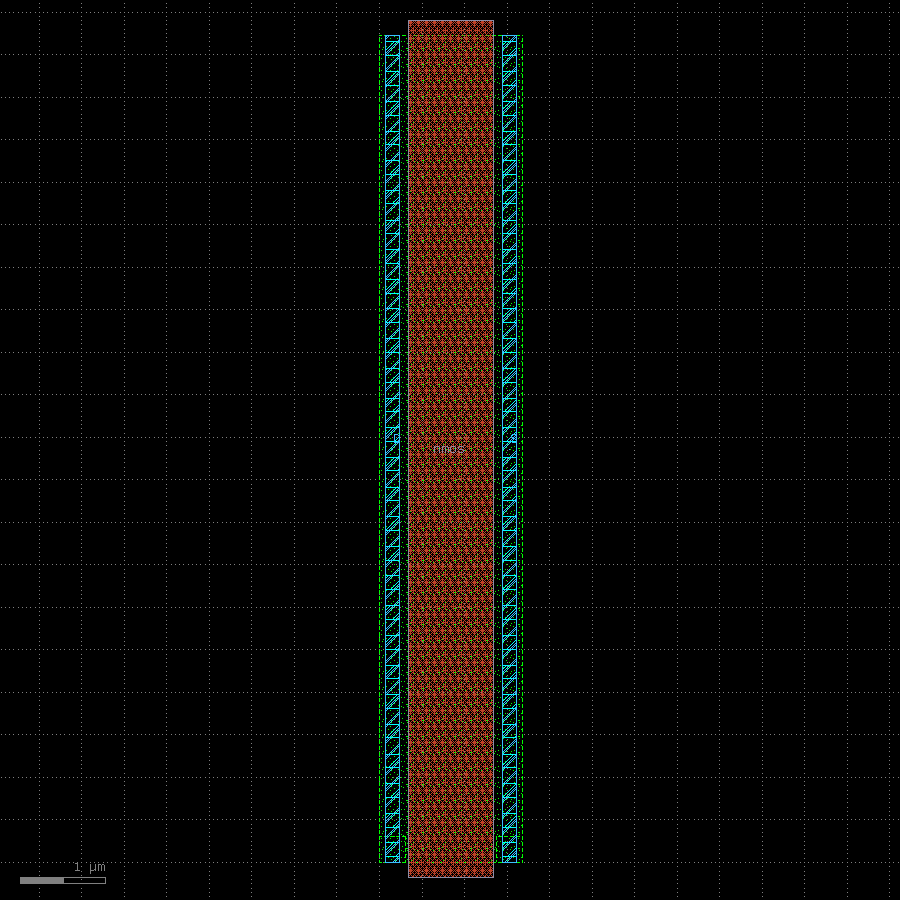
layout/devices/out/png/nmos_tail_unit.png
