oscarmattia/ihp-experiments/layout/devices/out/png/nmos_vga_steer_unit.png

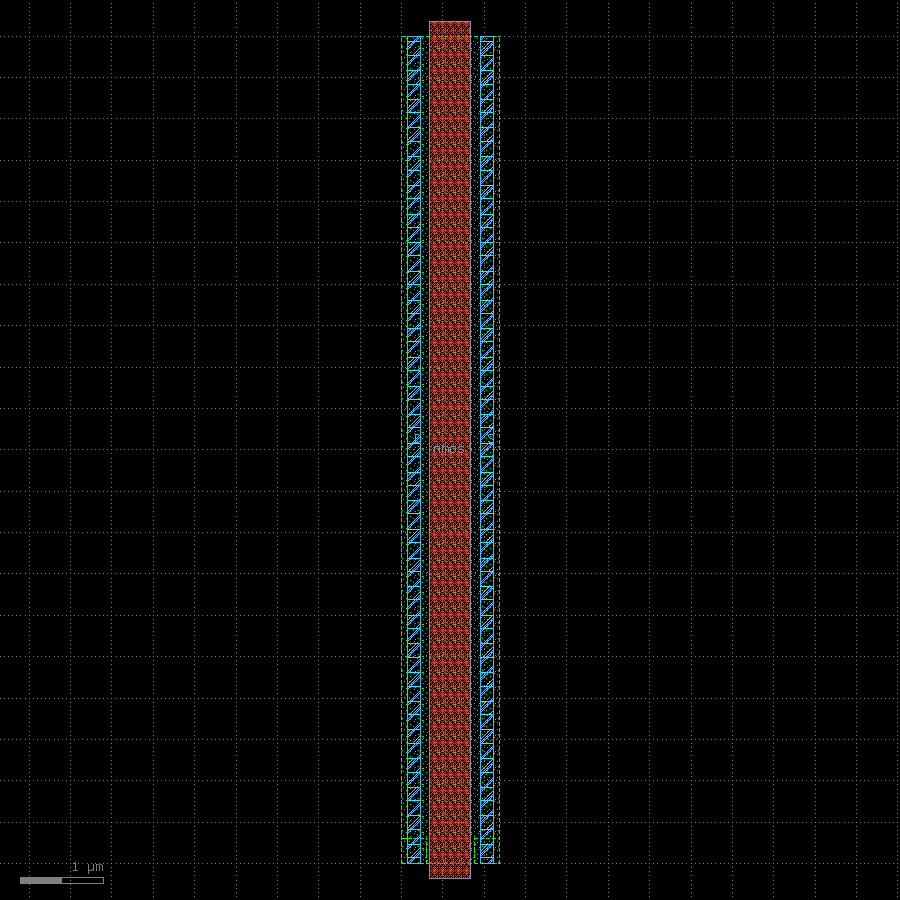
layout/devices/out/png/nmos_vga_steer_unit.png
