oscarmattia/ihp-experiments/layout/devices/out/png/nmos_vga_wide_unit.png

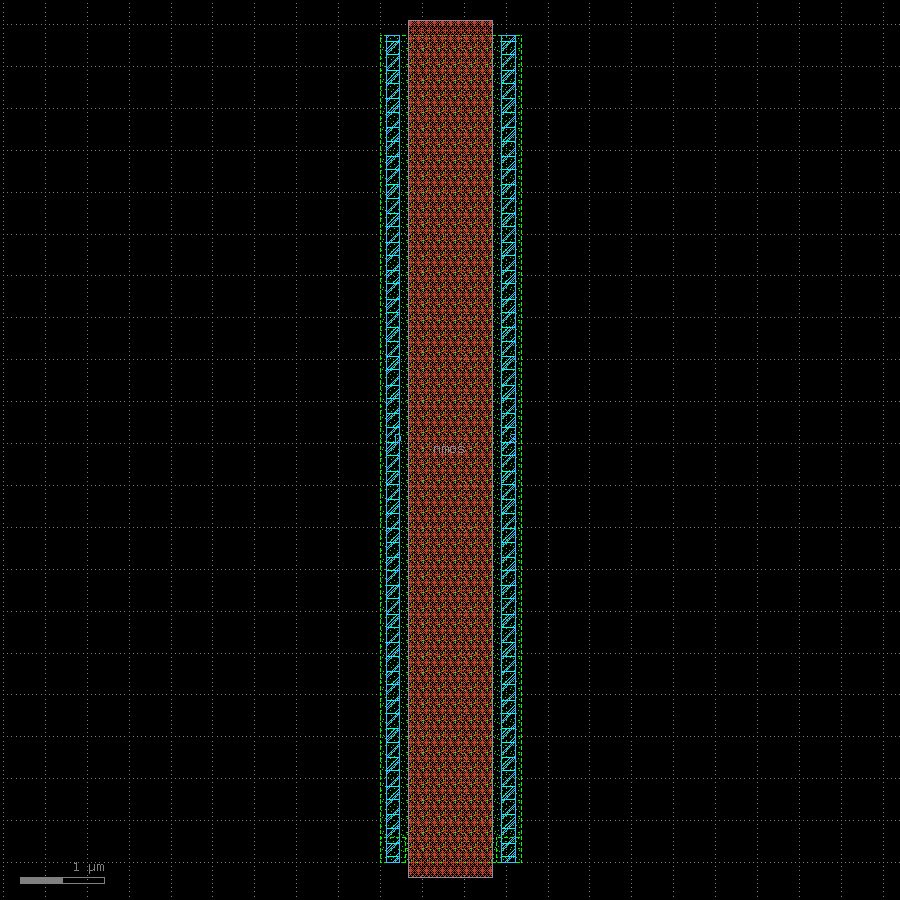
layout/devices/out/png/nmos_vga_wide_unit.png
