oscarmattia/ihp-experiments/layout/devices/out/png/npn13G2_driver.png

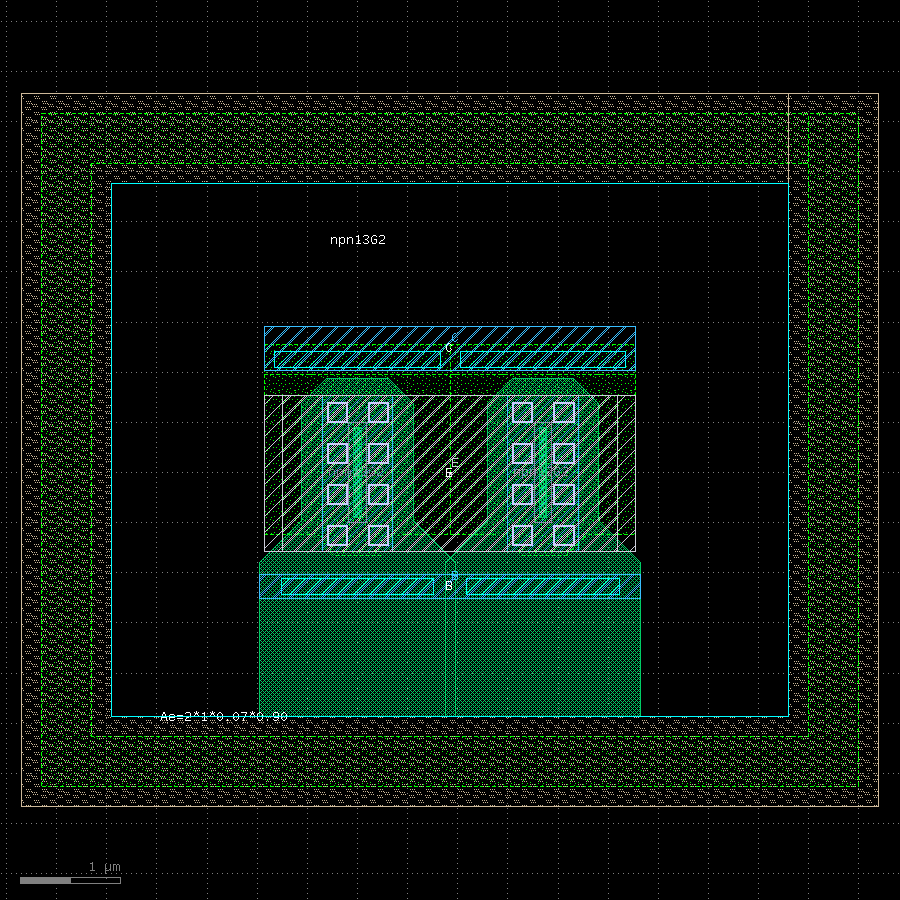
layout/devices/out/png/npn13G2_driver.png
