oscarmattia/ihp-experiments/layout/devices/out/png/npn13G2_pair_device.png

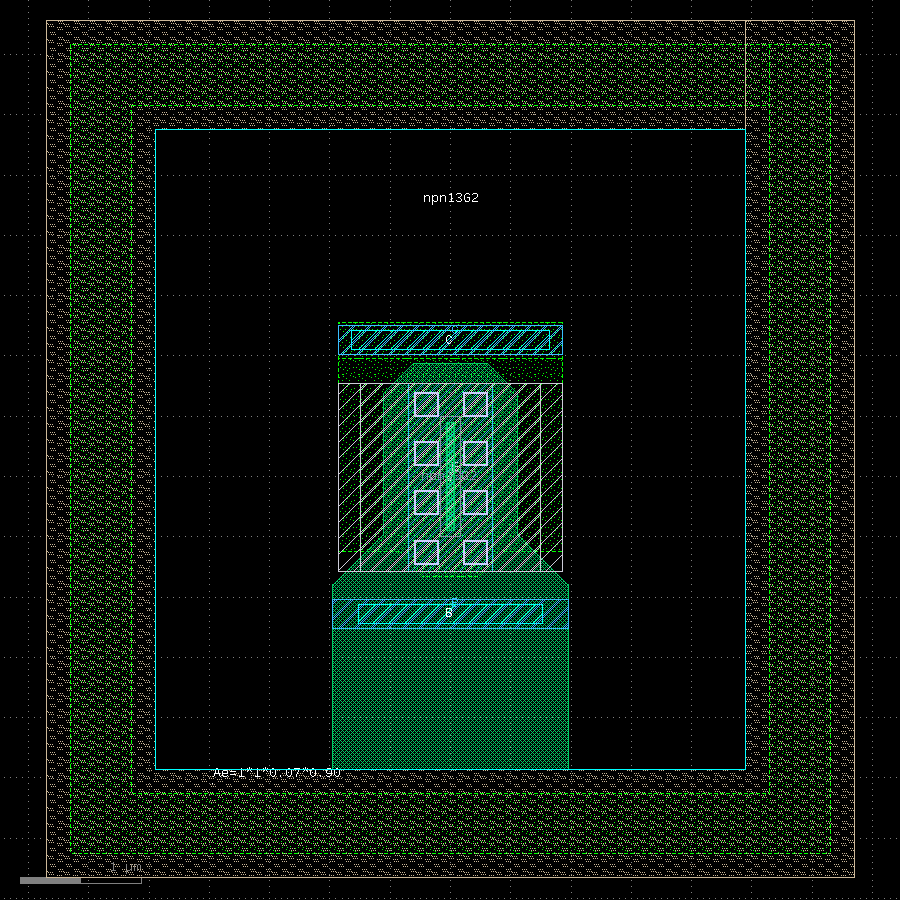
layout/devices/out/png/npn13G2_pair_device.png
