oscarmattia/ihp-experiments/layout/devices/out/png/ntap1_guard.png

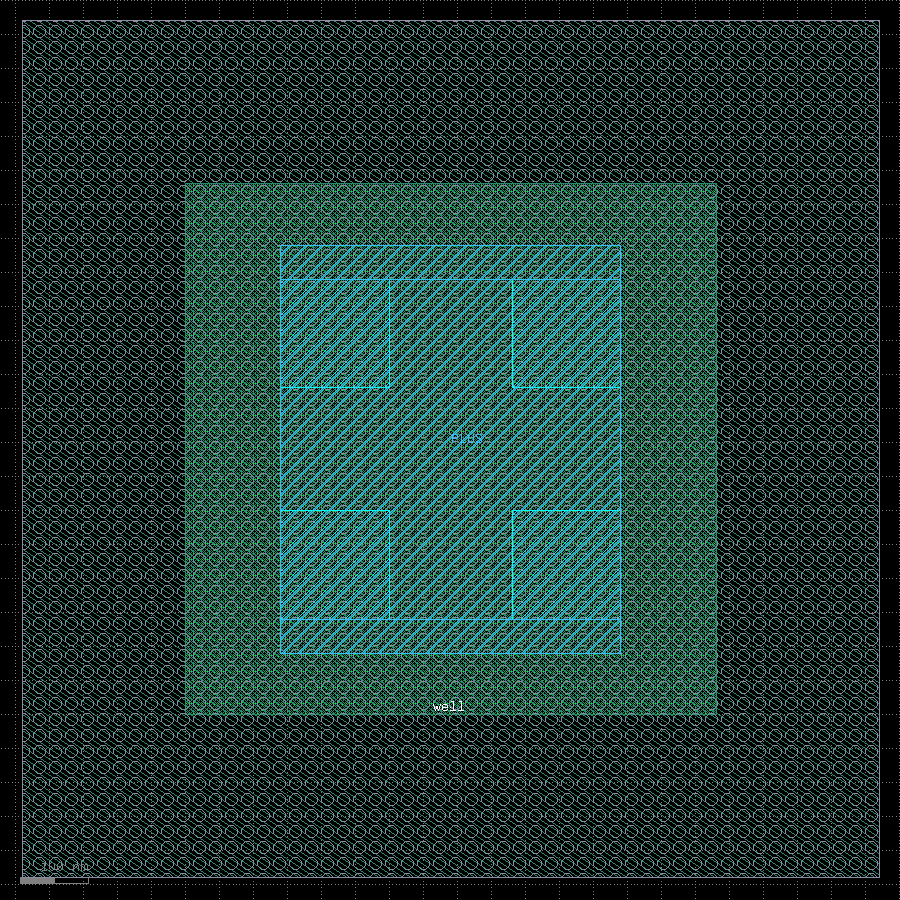
layout/devices/out/png/ntap1_guard.png
