oscarmattia/ihp-experiments/layout/devices/out/png/ptap1_guard.png

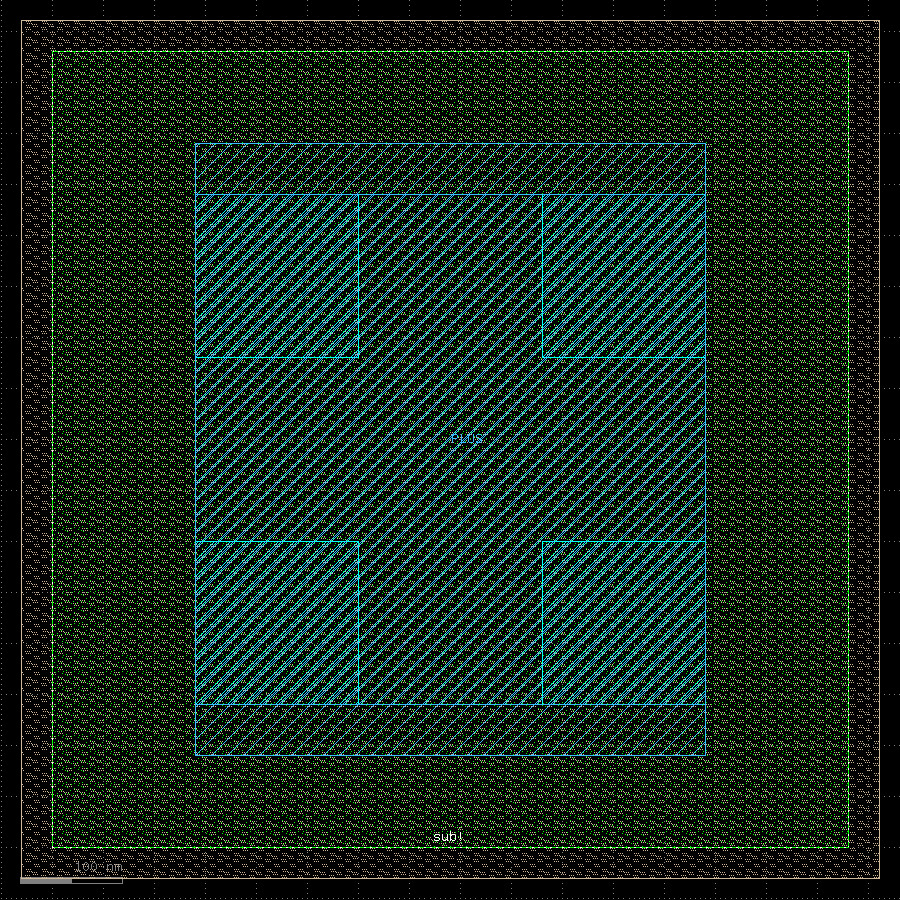
layout/devices/out/png/ptap1_guard.png
