oscarmattia/ihp-experiments/layout/devices/out/png/rppd_load.png

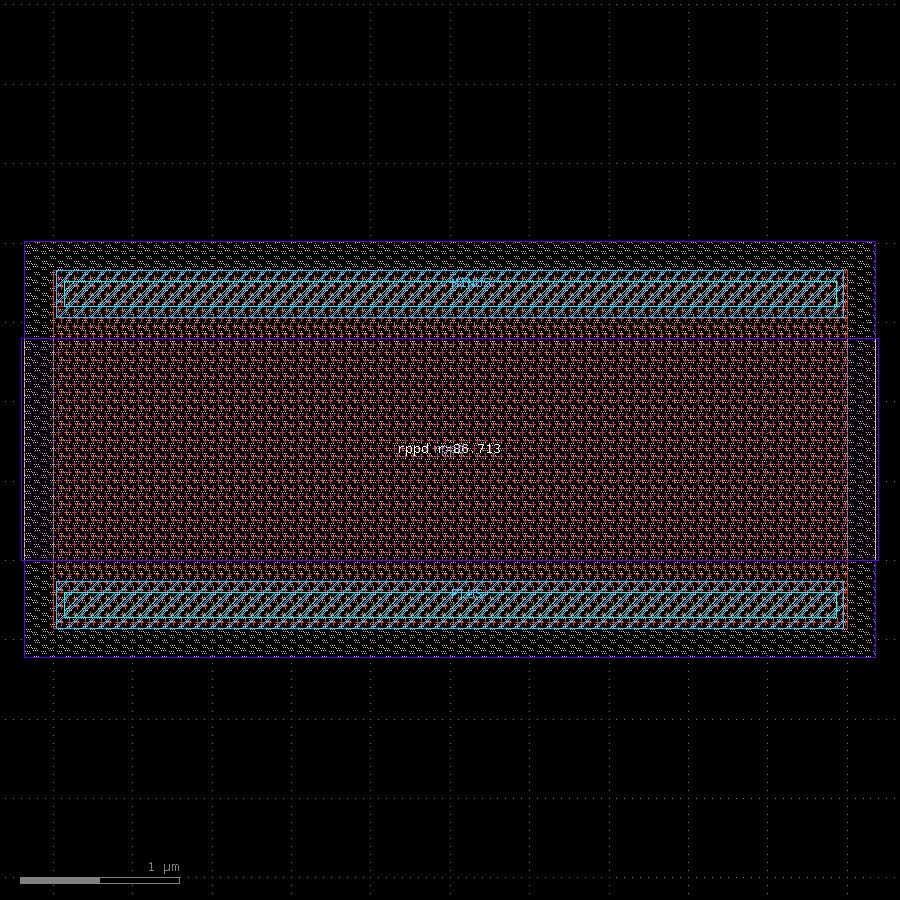
layout/devices/out/png/rppd_load.png
