oscarmattia/ihp-experiments/layout/devices/out/png/rppd_vtt_bot.png

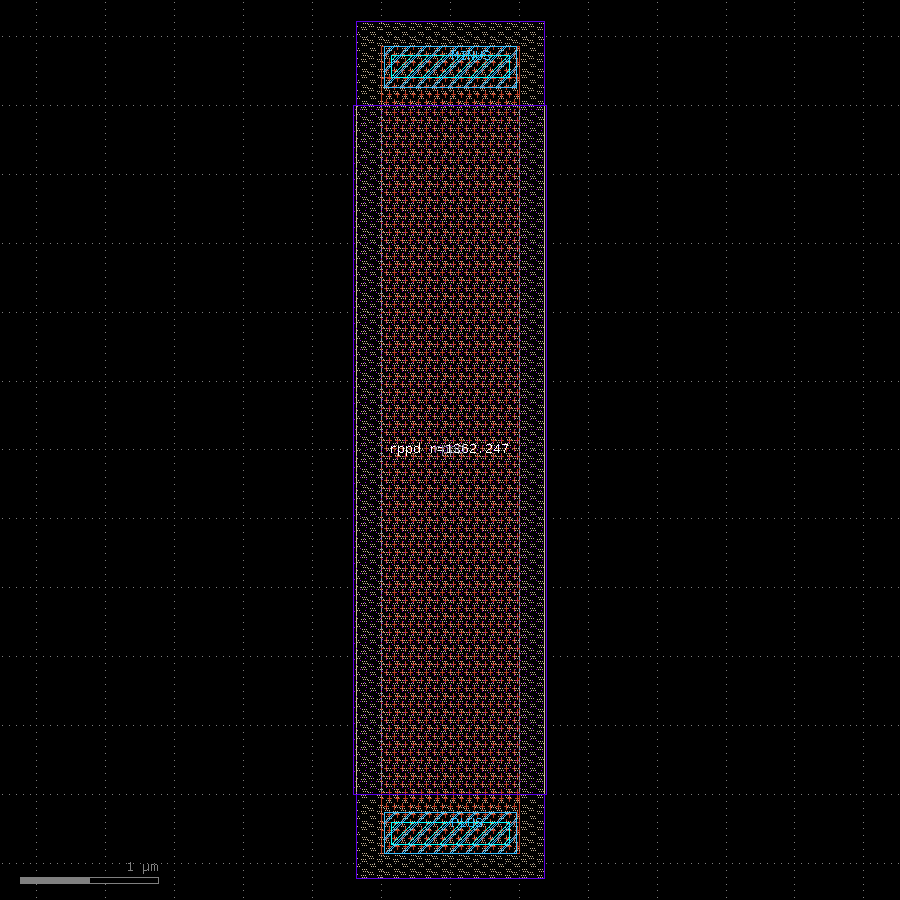
layout/devices/out/png/rppd_vtt_bot.png
