oscarmattia/ihp-experiments/layout/devices/out/png/rppd_vtt_top.png

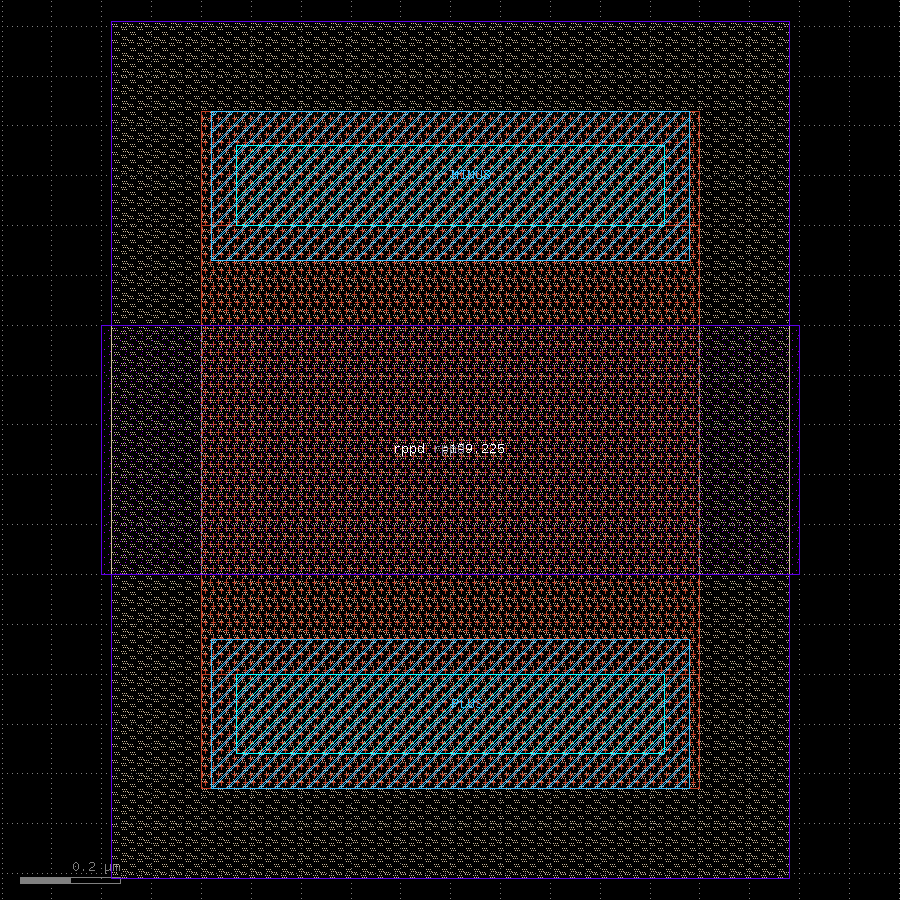
layout/devices/out/png/rppd_vtt_top.png
