oscarmattia/ihp-experiments/layout/devices/out/png/rsil_degen.png

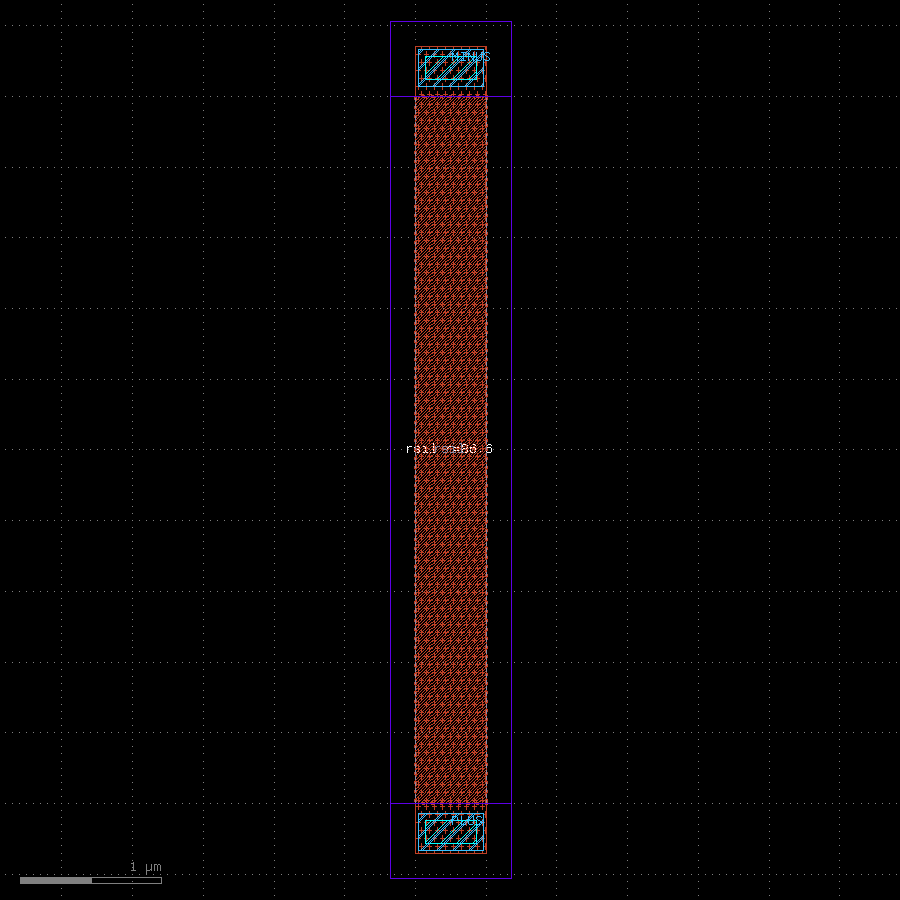
layout/devices/out/png/rsil_degen.png
