oscarmattia/ihp-experiments/layout/devices/out/png/rsil_term.png

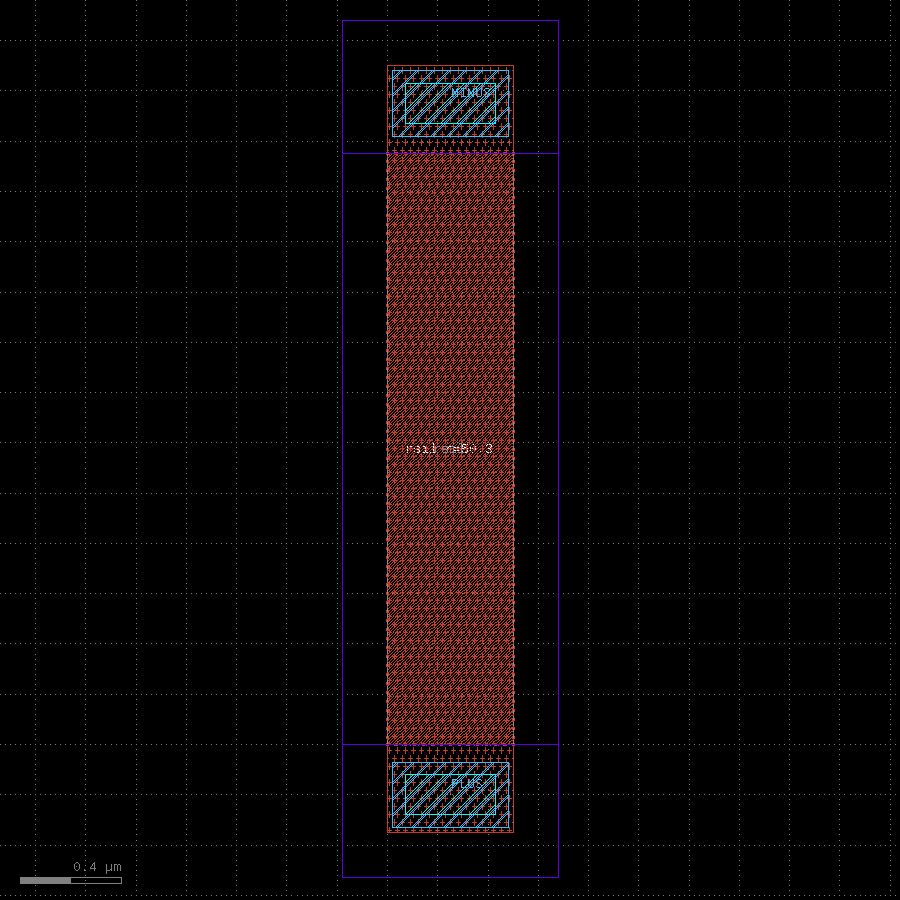
layout/devices/out/png/rsil_term.png
