oscarmattia/ihp-experiments/layout/out/spike/rppd_route_spike.png

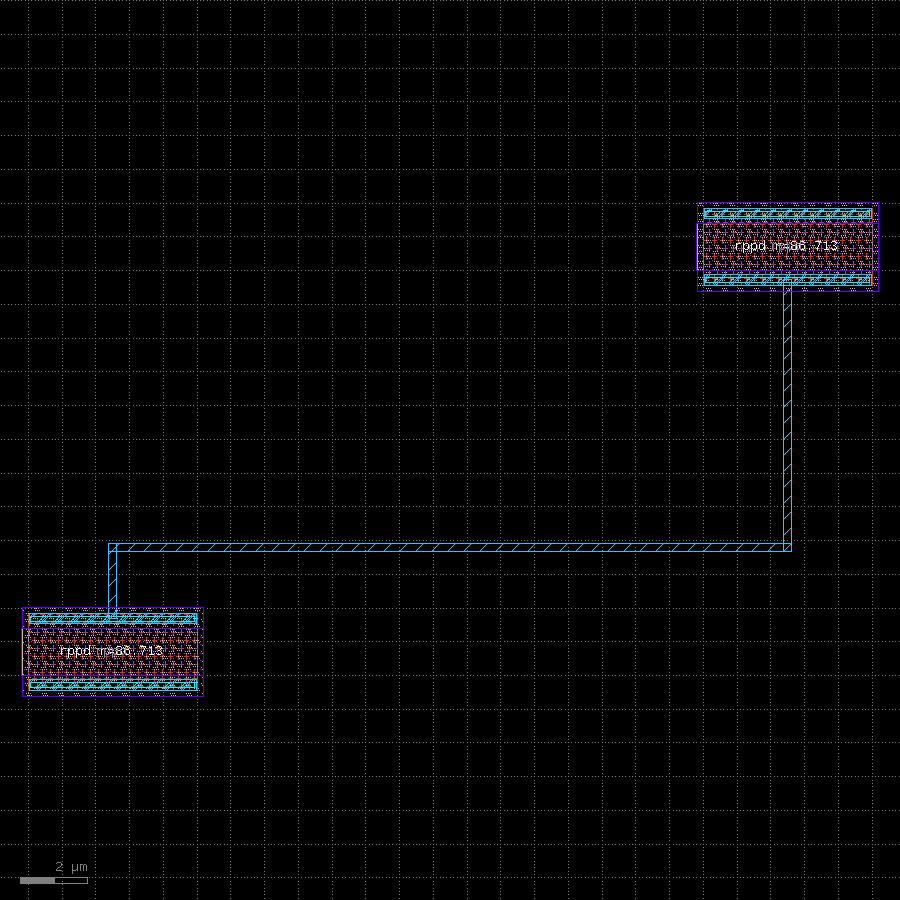
layout/out/spike/rppd_route_spike.png
