oscarmattia/ihp-experiments/char/passive/out/ind_sp_validate_turn1_d40.csv

freq_Hz | S21_mag_model | S21_mag_em | S21_ang_deg_model | S21_ang_deg_em | S11_mag_model | S11_mag_em
2.500000e+08 | 0.99629242 | 0.99476594 | -0.087163 | -0.090504 | 0.00375720 | 0.01308758
4.993750e+08 | 0.99629112 | 0.99475948 | -0.174107 | -0.180772 | 0.00390302 | 0.01313173
7.487500e+08 | 0.99628896 | 0.99474881 | -0.261050 | -0.271017 | 0.00413447 | 0.01320489
9.981250e+08 | 0.99628593 | 0.99473395 | -0.347990 | -0.361231 | 0.00443816 | 0.01330654
1.247500e+09 | 0.99628205 | 0.99471487 | -0.434926 | -0.451402 | 0.00480037 | 0.01343597
1.496875e+09 | 0.99627731 | 0.99469169 | -0.521858 | -0.541521 | 0.00520887 | 0.01359226
1.746250e+09 | 0.99627172 | 0.99466438 | -0.608785 | -0.631576 | 0.00565361 | 0.01377441
1.995625e+09 | 0.99626528 | 0.99463305 | -0.695707 | -0.721559 | 0.00612665 | 0.01398127
2.245000e+09 | 0.99625799 | 0.99459777 | -0.782621 | -0.811460 | 0.00662189 | 0.01421161
2.494375e+09 | 0.99624987 | 0.99455875 | -0.869528 | -0.901270 | 0.00713468 | 0.01446416
2.743750e+09 | 0.99624090 | 0.99451587 | -0.956427 | -0.990980 | 0.00766143 | 0.01473761
2.993125e+09 | 0.99623112 | 0.99446942 | -1.043316 | -1.080582 | 0.00819942 | 0.01503062
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
