oscarmattia/ihp-experiments/char/passive/out/ind_sp_validate_turn1_d60.csv

freq_Hz | S21_mag_model | S21_mag_em | S21_ang_deg_model | S21_ang_deg_em | S11_mag_model | S11_mag_em
2.500000e+08 | 0.99448606 | 0.99279011 | -0.130392 | -0.133863 | 0.00559731 | 0.01107848
4.993750e+08 | 0.99448354 | 0.99278155 | -0.260457 | -0.267378 | 0.00584183 | 0.01121317
7.487500e+08 | 0.99447936 | 0.99276734 | -0.390519 | -0.400869 | 0.00622780 | 0.01143391
9.981250e+08 | 0.99447350 | 0.99274746 | -0.520577 | -0.534322 | 0.00673089 | 0.01173565
1.247500e+09 | 0.99446598 | 0.99272191 | -0.650630 | -0.667726 | 0.00732698 | 0.01211213
1.496875e+09 | 0.99445680 | 0.99269098 | -0.780678 | -0.801069 | 0.00799525 | 0.01255637
1.746250e+09 | 0.99444596 | 0.99265446 | -0.910717 | -0.934339 | 0.00871906 | 0.01306114
1.995625e+09 | 0.99443346 | 0.99261253 | -1.040748 | -1.067525 | 0.00948565 | 0.01361936
2.245000e+09 | 0.99441932 | 0.99256537 | -1.170769 | -1.200616 | 0.01028539 | 0.01422437
2.494375e+09 | 0.99440354 | 0.99251298 | -1.300780 | -1.333601 | 0.01111107 | 0.01487004
2.743750e+09 | 0.99438613 | 0.99245551 | -1.430778 | -1.466470 | 0.01195725 | 0.01555090
2.993125e+09 | 0.99436710 | 0.99239297 | -1.560762 | -1.599214 | 0.01281980 | 0.01626209
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
