oscarmattia/ihp-experiments/char/passive/out/ind_sp_validate_turn1_d80.csv

freq_Hz | S21_mag_model | S21_mag_em | S21_ang_deg_model | S21_ang_deg_em | S11_mag_model | S11_mag_em
2.500000e+08 | 0.99268612 | 0.99083147 | -0.173756 | -0.177820 | 0.00742937 | 0.00907247
4.993750e+08 | 0.99268207 | 0.99082020 | -0.347076 | -0.355180 | 0.00776828 | 0.00937815
7.487500e+08 | 0.99267532 | 0.99080141 | -0.520392 | -0.532509 | 0.00830206 | 0.00986603
9.981250e+08 | 0.99266588 | 0.99077507 | -0.693704 | -0.709791 | 0.00899606 | 0.01051045
1.247500e+09 | 0.99265376 | 0.99074149 | -0.867008 | -0.887012 | 0.00981629 | 0.01128419
1.496875e+09 | 0.99263895 | 0.99070044 | -1.040305 | -1.064157 | 0.01073379 | 0.01216208
1.746250e+09 | 0.99262146 | 0.99065220 | -1.213592 | -1.241211 | 0.01172568 | 0.01312265
1.995625e+09 | 0.99260130 | 0.99059684 | -1.386867 | -1.418159 | 0.01277456 | 0.01414846
2.245000e+09 | 0.99257848 | 0.99053435 | -1.560130 | -1.594989 | 0.01386744 | 0.01522567
2.494375e+09 | 0.99255301 | 0.99046498 | -1.733378 | -1.771687 | 0.01499460 | 0.01634343
2.743750e+09 | 0.99252490 | 0.99038889 | -1.906610 | -1.948240 | 0.01614879 | 0.01749328
2.993125e+09 | 0.99249416 | 0.99030607 | -2.079824 | -2.124637 | 0.01732451 | 0.01866857
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
