oscarmattia/ihp-experiments/char/passive/out/ind_sp_validate_turn1_d40.png

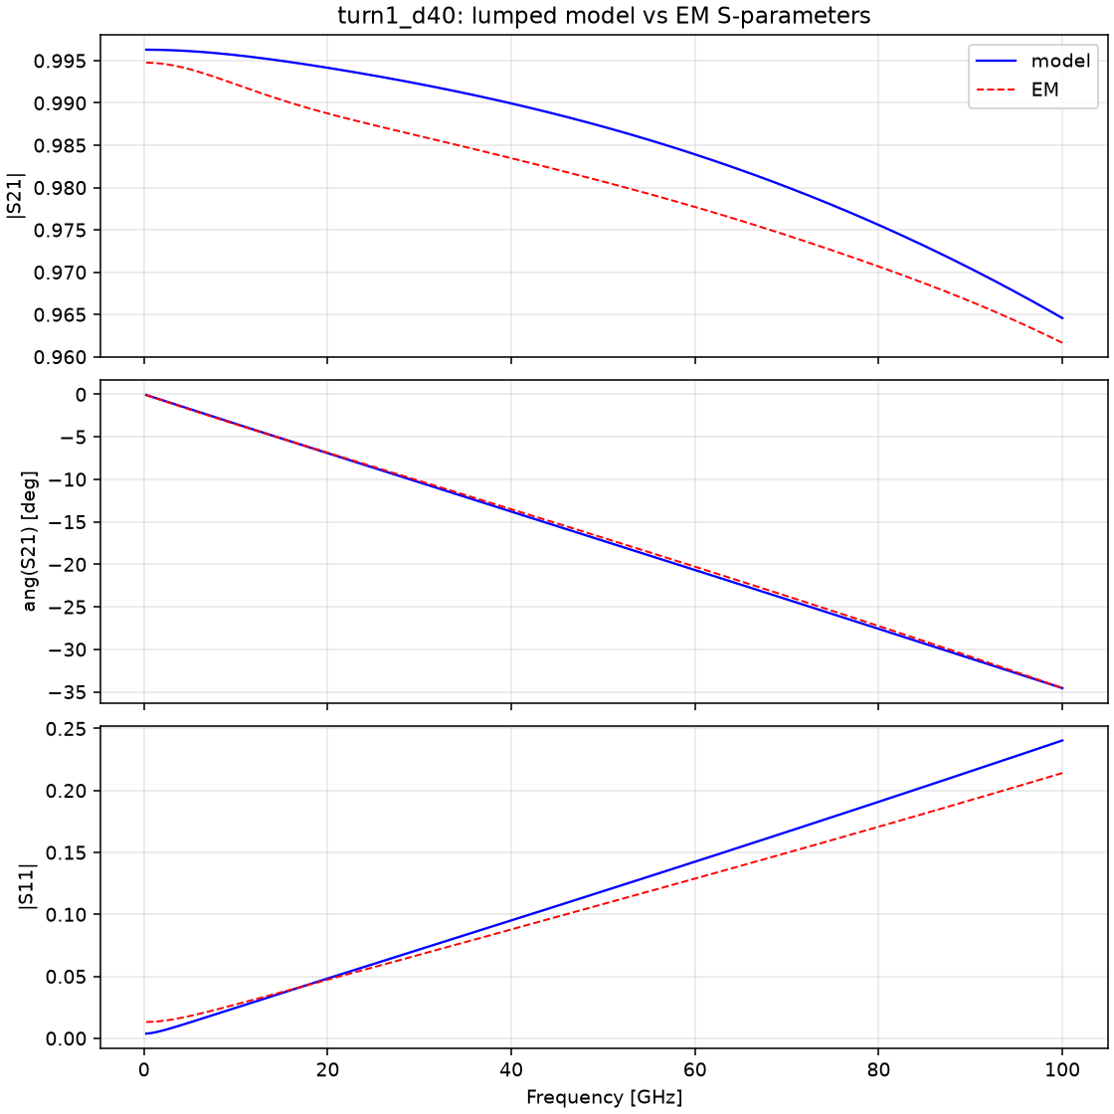
char/passive/out/ind_sp_validate_turn1_d40.png
