oscarmattia/ihp-experiments/char/passive/out/ind_sp_validate_turn1_d60.png

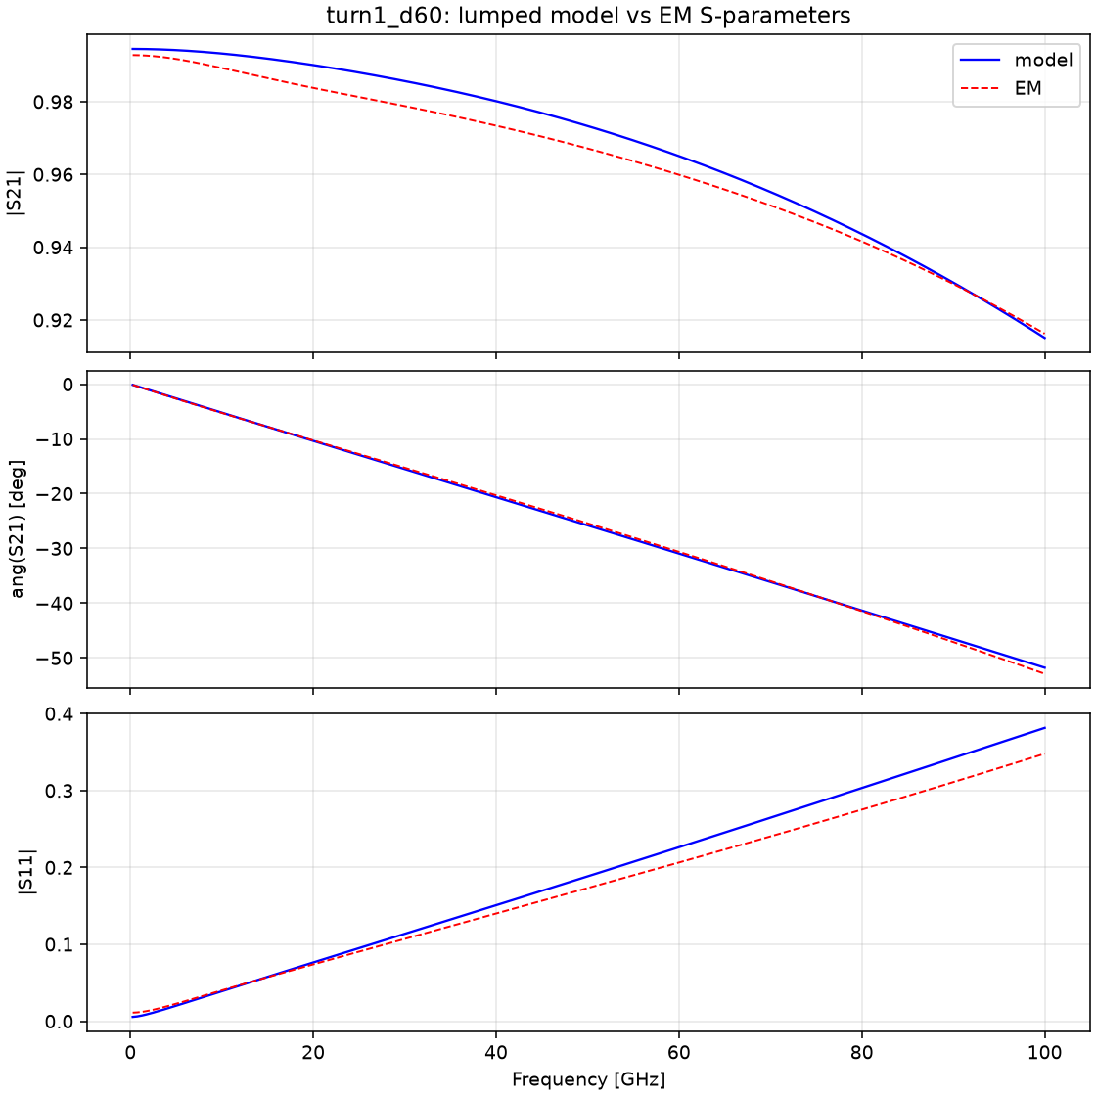
char/passive/out/ind_sp_validate_turn1_d60.png
