oscarmattia/ihp-experiments/layout/blocks/out/term_stage/_cmim_probe/lvs/probe_extracted.cir

* Extracted by KLayout with SG13G2 LVS runset on : 20/08/2026 11:07

.SUBCKT probe
C$1 \$I3 \$3 cap_cmim w=20u l=20u A=400p P=80u m=1
R$2 \$I4 \$2 \$1 rppd w=1u l=5u ps=0u b=0 m=1
.ENDS probe
