oscarmattia/ihp-experiments/(commit log)

2026-08-18 Fix ngspice/OSDI compatibility and install idempotence
    Bump default ngspice to 45.2 for OpenVAF-Reloaded OSDI v0.4, install
    LLVM 21 for openvaf-r, make the uv venv step idempotent, and harden
    verification so the MOSFET op-point smoke test matches IHP docs.
2026-08-18 Add IHP MOSFET characterization suite (core + RF)
    Introduce an IHP-aware gm/ID sweeper that covers LV/HV core and RF
    CMOS (rfmode 0/1), writing pygmid-compatible LUT pickles plus summary
    CSV/plots. Upstream pygmid ngspice netlists only hardcode LV probes.
2026-08-18 Add MOSFET char results for LV/HV core and RF devices
    Include pygmid-compatible LUT pickles, summary.csv, and gm/ID / Id–Vg /
    Vth comparison plots for all eight CMOS device classes.
    [summary.csv]
2026-08-18 Document MOSFET characterization and core-vs-RF DC notes
2026-08-18 Point README at MOSFET characterization flow
2026-08-18 Organize char/ LUTs and add BJT DC characterization
    Restructure device characterization into mos/, bjt/, and passive/
    with shared .npz helpers. MOS keeps pygmid .pkl plus portable .npz;
    BJT adds Gummel-style tables for npn13G2/l/v and pnpMPA for fast
    design-space browsing without re-running SPICE.
    [summary.csv]
2026-08-18 MOSFET characterization: LV/HV core + RF (gm/ID) (#2)
    * Add IHP MOSFET characterization suite (core + RF)
    * Add MOSFET char results for LV/HV core and RF devices
    * Document MOSFET characterization and core-vs-RF DC notes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
    [summary.csv]
2026-08-19 Passive R/L/C characterization + openEMS inductor stack (#4)
    * Add passive R/L/C characterization and openEMS EM stack
    Implement resistor and capacitor ngspice LUTs under char/passive/, install
    openEMS (primary on ~16GB hosts) with optional Palace path, and run
    inductor EM for L_2n0 plus synthesized 1-turn/2-turn cases into .npz
    tables for design-space browsing without re-running SPICE/EM.
    * Install headless AppCSXCAD stub from EM installer
    * Add KLayout screenshots of capacitor and inductor layouts.
    Render IHP PDK GDS cells (MIM, RFMOM, MOSCAP, L_2n0, 1-/2-turn) and
    EM-synthesiz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
    [cap_summary.csv, ind_summary.csv, res_summary.csv]
2026-08-19 56G NRZ CML CTLE with HBT fT LUTs, 300 GHz AC, and PRBS eyes (#5)
    * Add HBT fT and Cin to BJT characterization LUTs.
    Grounded-emitter OP+AC extraction writes FT, CIN, CBE, and CBC for
    npn13G2 flavors (PNP stays NaN). Summaries include fT vs Ic plots.
    * Add 56G NRZ CML CTLE experiment with AC, CMRR, PSRR, and PRBS.
    Size an HBT shunt-peaked CTLE from LUTs (FO1, Bessel m=0.32). Run DC,
    AC to 300 GHz (diff/CM/PSRR), and a 56G NRZ PRBS7 transient at
    100 mVpp,diff with SE/diff waveforms and 2-UI eye plots. Device
    currents are listed in save before print. CMRR target is 6 dB.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
    [ac_diff.csv, eye_diff.csv, eye_se.csv, metrics.csv, sbr.csv, sbr_taps.csv, summary.csv, tran.csv]
2026-08-19 Add PDK/environment agent reference docs and correct MEMORY.md
    - docs/PDK.md: verified SG13G2 device reference (corner sections, OSDI needs,
    HBT/MOS/R/C/diode ports and params, measured 50 ohm rsil, MoM finger-cap C vs
    frequency and feed resonance, 50.9 fF ESD pad load, empty bondpad placeholder,
    absence of any ngspice inductor model)
    - docs/ENVIRONMENT.md: single source of truth for tools and setup; adds verified
    installed versions, the missing matplotlib/scipy gap, OSDI/.spiceinit runtime
    requirement, and openEMS-not-installed-by-default
    - MEMORY.md: corrects the inductor, BVceo/vce_max, resistor sheet-R, missing MoM
    finger cap, broken turn2 EM case, branch-suffix and coordinat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
2026-08-19 Refactor CTLE sim flow into ctlelib and parametrize testbenches
    Split run_sims.py into circuits/ctle56n/python/ctlelib/ (ngs, stim, metrics,
    plots) with run_sims.py as the orchestrator. Testbenches now take {DUT_NAME},
    {CL_TB}, and {DC_SAVE_LINES}/{DC_PRINT_LINES} tokens so the same six decks can
    serve the CTLE, the upcoming VGA/termination stages, and the combined chain.
    Numerically neutral: a full ./circuits/ctle56n/run.sh re-run after the refactor
    leaves out/, ctle_report.md, and params.inc byte-identical.
2026-08-19 EM-characterize small 1-turn inductors for shunt peaking
    Add turn1_d40/d60/d80 synthesized 1-turn TopMetal2 octagons (w=4u, s=2.1u,
    D=40/60/80um) swept to 100 GHz, covering the 65-137 pH range that CML shunt
    peaking actually needs; the existing l2n0 (2.02 nH) and turn1 (215 pH) cases are
    both too large.
    Also add validity flagging to the summary (char/passive/ind_validate.py):
    ind_summary.csv now carries L_28GHz_nH, SRF_GHz, fstop_GHz, valid, and
    invalid_reason. This flags the pre-existing turn2 case as invalid (L=-12.2 nH,
    Q=0) instead of silently reporting it as em_completed.
    Cross-validation: L(28 GHz) is linear in drawn diameter (1.774 pH/um,
    r=0.99998); extrapolating to D=120um gives 2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
    [ind_summary.csv]
2026-08-19 Add 50 ohm / ESD bond-pad termination stage
    New term_dut stage ahead of the CTLE, on the same 5-port interface so the
    existing testbenches apply: 70x70 um stacked TM1+TM2 bond pad, primary ESD via
    diodevdd_2kv + diodevss_2kv per pad with an nmoscl_2 rail clamp, 50 ohm rsil
    termination per leg to an on-chip vtt reference, and vtt generated by an rppd
    divider off VDD with a cap_cmim decap.
    Verified in ngspice: vtt = 1.374 V at 1.01 mA divider current, rsil measures
    50.26 ohm, ESD leakage 1.10 pA, insertion loss -6.00 dB at DC (the 2:1 divider
    of a 50 ohm/leg source into a 50 ohm/leg termination) and -6.67 dB at 28 GHz,
    S11 -51.9 dB at DC and -18.3 dB at 28 GHz against the 100 ohm differential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
    [ac_diff.csv, eye_diff.csv, eye_se.csv, metrics.csv, sbr.csv, sbr_taps.csv, sbr_taps_0p5pct.csv, tran.csv]
2026-08-19 Fix aF/fF unit error in the metal-stack capacitance reference
    The Magic defaultareacap values are aF/um^2, not fF/um^2 -- the extract deck
    states it explicitly. docs/PDK.md mislabeled the column, and a sub-agent trusted
    it and budgeted a 40 um route at 79.92 fF instead of 0.08 fF, a 1000x error that
    drove an entire stage's load, RD, and inductor selection.
    Adds the full layer-to-substrate table with correct units, the MIM cross-check
    that proves them (1500 aF/um^2 against the independently known 1.5 fF/um^2 MIM
    density), and two adjacent traps: stacked plates shield each other so only the
    bottom plate counts, and plate area alone underestimates a narrow signal route,
    which is fringe-dominat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
2026-08-19 Record inductor lumped-model learnings in MEMORY.md
    Port shunt capacitance is the dominant parasitic of a lumped coil model (~5-10
    fF per 100 pH; EM gives 5.79/5.80 fF for the 66 pH turn1_d40 case), plate area
    underestimates it ~6x, the pi-model must be extracted from the EM Touchstone
    Y-parameters and persisted into committed artifacts since em_work/ is
    gitignored, and the openEMS series resistance carries a ~-0.4 ohm de-embedding
    offset that makes low-frequency Q unusable.
2026-08-19 Document PDK metal stack authority and the inductor port loss branch form
    - docs/PDK.md: metal sheet resistance and thickness table from the ITF stack file
    and the LVS res_extraction deck (two independent, agreeing sources), plus the
    note that both the ITF and the openEMS stackup model oxide as lossless, so a
    fitted shunt loss branch is substrate loss, not dielectric loss
    - MEMORY.md: the coil port loss branch is Cox with a PARALLEL resistance, not a
    series one -- both C_port and G_port are flat over 20-70 GHz, which a series RC
    cannot reproduce; and in shunt peaking the port conductance is negligible
    against RD while the port capacitance must be counted in C_L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
2026-08-19 Drop the inductor port loss resistor and document the HBT emitter-resistance ceiling
    Port branch is capacitance only: both the ITF stack and the openEMS stackup model
    oxide as permittivity-only, so dielectric loss is zero by construction and fitting
    a resistor to it fits noise. The residual shunt conductance the S-parameters show
    is substrate coupling; deferred with a note to model it by its real mechanism
    (coupled inductors with parallel resistors for induced substrate current loops)
    rather than a lumped port resistor. Omitting it is safe here because in shunt
    peaking any load-side loss resistance is in parallel with RD.
    Also documents npn13G2 re = 7.13*(4/Nx) ohm = 28.5 ohm at Nx=1, which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
2026-08-19 Add draft CI/CD architecture plan
    Document the proposed CI/CD design for this repo: a pinned IHP EDA
    container image published to GHCR, three regression tiers (always-on
    active+passive device smoke, path-triggered characterization, per-design
    testbench regression), DVC-tracked testbench results, and CML PR reports.
    Measured on a Cloud Agent VM: the full non-EM characterization suite runs
    in ~12 s while provisioning the toolchain takes tens of minutes, and
    repeated sweeps are byte-identical. That is what motivates prebuilding the
    environment and keeping regression tolerances tight.
    Also records the prerequisite defects found while measuring (missing
    matplotlib, unasserted Id in verify-ihp-e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
2026-08-19 Add staged plan for agentic layout (DRC/LVS/PEX) flow
    Plans a physical-layout capability for SG13G2, staged so each step is
    verifiable before the next: toolchain fix, single-device generators with
    DRC, LVS, PEX + post-layout sim, matched sub-blocks, then the CTLE stage.
    Key findings behind the plan:
    - The KLayout binary is 0.28.16 but the PDK pins 0.30.5 in versions.txt
    and run_drc.py enforces it, so the DRC deck cannot run at all today.
    install-ihp-eda.sh also hardcodes 0.30.3 instead of reading versions.txt.
    - Magic and netgen are absent, and neither apt package is usable
    (magic 8.3.105 < required 8.3.573; apt "netgen" is a mesh generator).
    - The PDK recommends GDSFactory for progra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
2026-08-19 Record that variable degeneration is not a 28 GHz gain control
    Sweeping Rs on a CML pair with the control device removed moves DC gain 10 dB but
    gain at 28 GHz only 2 dB: the emitter capacitance shorts the degeneration out well
    below Nyquist, so variable Rs is a variable equalizer rather than a variable gain
    stage. VGA range must be quoted at the signal frequency, and real gain control
    needs current steering.
    Also records two errors this surfaced: the LUT gm is already re-degenerated
    (gm/Ic = 9.90 1/V vs the intrinsic 38.7), so dividing by (1+gm*re) double-counts
    it and understated a gain ceiling by 3.3 dB; and a coil's port capacitance sits on
    the internal node between L and RD, where it r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
2026-08-19 Record the RD floor implied by the smallest realizable inductor
    The inductor PCell dmin of 25.35 um and the EM fit L = 1.774*D - 5.55 pH mean
    nothing below ~39 pH can be built, which via the Bessel condition sets
    RD_min = sqrt(L_min/(m*C_L)) ~ 70 ohm at C_L = 25 fF. Since L_target scales as
    RD^2, trimming RD to satisfy a gain target quickly makes the required inductance
    unbuildable -- and C_L never forces RD down, since it does not enter DC gain.
2026-08-19 Record the working VGA architecture and its large-signal caveat
    Tail-current steering with a dummy pair gives frequency-flat gain range (11.2 dB
    at 28 GHz), constant output common mode, and unchanged input capacitance so FO1
    survives. A shared tail node is required; separate mirrors per branch cap the
    range at ~1 dB.
    Also records the structural caveat: steering starves the signal pair at minimum
    gain, which is exactly when the input is largest, so small-signal AC range
    overstates large-signal range and must be cross-checked in transient. And because
    gain now comes from gm scaling, a fixed degeneration resistor costs equal gain at
    every setting without reducing range -- unlike variable degen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
2026-08-19 Record two recurring review failures: unverified metrics and RD as a gain knob
    A PDK pass reported m = 0.349 computed from the ideal netlist's RD = 87 ohm while
    its own rppd geometry realized only 65.94 ohm, so the shipped netlist was really
    at m = 0.607. Derive reported metrics from realized device values and emit those
    values so the drift cannot hide.
    Also: RD is pinned by the Bessel condition and the buildable-coil floor, so gain
    must be trimmed with Rs. Two agents reached for RD to pull DC gain under its
    ceiling and both broke m doing it.
2026-08-19 Real passives, dual-tail bias, and honest load budget in the CTLE
    Replaces the last ideal elements in the PDK netlist and fixes two design errors
    the real devices exposed. All four AGENTS.md targets now pass on both passes.
    Real passives:
    - EM-fitted ind_shunt subcircuit replaces the ideal shunt-peaking inductors:
    66.35 pH series L from the openEMS 2-port pi-model, a skin ladder rising 1.70x
    from the PDK-confirmed 0.372 ohm DC value (RSH_RES_TOPMETAL2 = 0.011 ohm/sq),
    and 5.803 fF of port capacitance per terminal. No loss resistor -- the PDK
    models oxide as permittivity-only, so dielectric loss is zero by construction
    and the residual conductance is substrate coupling, deferred wi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
    [ac_diff.csv, eye_diff.csv, eye_se.csv, ind_summary.csv, metrics.csv, sbr.csv, sbr_taps.csv, summary.csv]
2026-08-19 Record ngspice n-port availability and sp-analysis model validation
    There is no Touchstone n-port device in ngspice 45.2; the only Touchstone-reading
    element is the XSPICE xfer code model, which is a unilateral transfer block rather
    than a bidirectional impedance and so cannot represent a coil.
    ngspice does have sp (S-parameter) analysis via the RFSPICE build option, with
    ports declared on voltage sources. Used in reverse it validates the lumped coil
    model against the EM touchstone in S-parameter space: 0.60% mean |S21| error over
    1-50 GHz and 0.75% out to 100 GHz, phase within ~0.3 deg. Also records why the
    fitted lumped model is still preferable (transient, 300 GHz sweep, DC anchor,
    param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
2026-08-19 Validate the EM inductor model against its touchstone via ngspice sp analysis
    ngspice has no Touchstone n-port device -- the only Touchstone-reading element is
    the XSPICE xfer code model, which is a unilateral transfer block and cannot stand
    in for a passive coil. But the build does have sp (S-parameter) analysis, so the
    check runs in reverse: emit S-parameters from the lumped model and compare against
    the openEMS data in the same units, instead of comparing derived L/Q scalars.
    All three usable cases pass, gated on |S21| magnitude and phase:
    turn1_d40 |S21| mean err 0.53% (fit 1-50 GHz), 0.52% (extrap to 100 GHz), phase 0.15 deg
    turn1_d60 0.58% / 0.31%, phase 0.18 deg
    turn1_d80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
    [ind_sp_validate_summary.csv, ind_sp_validate_turn1_d40.csv, ind_sp_validate_turn1_d60.csv, ind_sp_validate_turn1_d80.csv]
2026-08-19 Document the front end: stage contracts, measurement definitions, PDK constraints
    Rewrites circuits/ctle56n/AGENTS.md and README.md to cover all four passes
    (termination, CTLE, VGA, chain) rather than just the CTLE, and records the design
    constraints that were learned the hard way here: RD pinned by the Bessel condition
    and the buildable-coil floor rather than by the gain target, two per-emitter tail
    sources so the degeneration carries no DC, the coil port capacitance excluded from
    C_L because it resonates with L on the internal node, current steering rather than
    variable degeneration because degeneration gives ~10 dB of DC range but only ~2 dB
    at 28 GHz, and PDK resistors sized by op measur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
2026-08-19 WIP checkpoint: termination, VGA, chain, and driver scaffolding
    Commits the new stage scaffolding as a revert point before further rounds. State
    of each piece:
    WORKING: termination stage (verified, -6.00 dB IL, S11 -51.9 dB at DC into 100
    ohm differential); VGA current-steering architecture with bias invariance and
    11.2 dB range at 28 GHz; chain testbench cascading term/CTLE/VGA; 0.5% SBR tap
    threshold; VGA input common mode now referenced to the CTLE output (1.400 V).
    KNOWN BROKEN, addressed next: VDD is split between 1.7 V (CTLE params.inc) and
    1.65 V (VGA) and must become a single 1.6 V; the eye width metric is not
    phase-invariant (ideal 0.680 vs pdk 0.5675 UI for the same circuit, vga_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
    [ac_diff.csv, ac_diff_c0.00.csv, ac_diff_c0.10.csv, ac_diff_c0.15.csv, ac_diff_c0.20.csv, ac_diff_c0.25.csv, ac_diff_c0.30.csv, ac_diff_c0.35.csv]
2026-08-19 Record why an output driver into 50 ohm is gain-starved
    The differential load is pinned at RD||50 = 25 ohm by the interface, so driver
    gain is gm_eff*25, and the HBT's intrinsic re degenerates the pair: Nx=2 gives
    gm_eff ~49 mS for a gain of only 1.23. Reaching the 400 mVpp full switching swing
    therefore needs ~325 mVpp of drive rather than the ~100 mV an undegenerated tanh
    pair would need, which is a chain gain-budget item. Also notes that testing a
    driver at the same 100 mVpp stimulus used for input-referred stages understates
    its swing.
2026-08-19 Add pad driver, four-stage chain, single 1.6 V supply, unbiased eye metrics
    Completes the front-end scaffolding: termination -> CTLE -> VGA -> pad driver,
    with one supply and measurement definitions that hold up.
    Pad driver (new): CML pair with no degeneration and a single 2W tail source --
    correct here because with no degeneration resistor the emitters share a node, so
    one source of 2*Ic is exactly equivalent to two of Ic. On-chip 50.26 ohm rsil load
    doubles as back-termination, ESD (diodevdd_2kv + diodevss_2kv + nmoscl_2) and a
    27.7 fF pad are grouped for later extraction into their own block, and the
    floating 100 ohm differential receiver lives only in the testbench so no
    common-mode pat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
    [ac_diff.csv, ac_diff_max.csv, ac_diff_min.csv, ac_diff_vctrl_0p15.csv, ac_diff_vctrl_0p28.csv, ac_diff_vctrl_0p42.csv, ac_diff_vctrl_0p65.csv, ac_diff_vctrl_1p00.csv]
2026-08-19 Remove unused predriver netlist
    Left over from the driver's first pass before the decision to skip the
    pre-driver and take the bandwidth hit at the VGA. Nothing references it -- no
    sizing module, stage runner, or chain netlist -- so it is dead code.
2026-08-19 Add generate_reports.py and shared ctlelib/reports module
    Extract markdown report writers from run_sims.py into ctlelib/reports.py.
    Add generate_reports.py CLI that parses committed out/ CSV artifacts without
    re-running ngspice. Wire report generation into run.sh after summary aggregate.
2026-08-19 Generate stage and chain markdown reports from committed sim results
    Add term_report.md, vga_report.md, driver_report.md, and chain_report.md in
    the same style as ctle_report.md. Regenerate ctle_report.md via generate_reports.py.
    Update AGENTS.md and README with report conventions.
2026-08-19 Move AC plot legend to bottom-left, metrics box to center
    In plot_ac: relocate line-marker legend from upper-right to lower-left;
    move the DC/G_peak/f_peak annotation box to plot center and drop the
    redundant G_peak arrow label. Apply lower-left legends to CMRR/PSRR and
    term insertion-loss/S11 plots for consistency.
2026-08-19 Use lower-left legend on term AC insertion-loss and S11 plots
2026-08-19 Fix AC group-delay plot scaling and add chain per-stage plots
    Mask sub-100 MHz group delay (log-sweep LF artifact) and auto-scale the
    GD panel to the valid band. Add out/chain/chain_perstg/ with per-stage
    AC, PRBS transient, and SBR plots; extend chain tran wrdata to save
    internal tap nodes.
    [stage_chain.py]
2026-08-19 Regenerate AC/chain artifacts with fixed GD and chain_perstg plots
    [ac_diff.csv, ac_diff_max.csv, ac_diff_mid.csv, ac_diff_min.csv, isi_analysis.csv, metrics.csv, sbr.csv, sbr_max.csv]
2026-08-19 Limit AC plot display axis to 100 MHz–200 GHz
    Add AC_PLOT_FMIN_HZ and AC_PLOT_FMAX_HZ in ctlelib/metrics.py and apply
    xlim in all AC frequency plots (diff gain/GD, CMRR, PSRR, S11, insertion
    loss, chain per-stage). Sim sweeps remain 1 MHz–300 GHz.
    Add replot_ac_plots.py to refresh PNGs from saved CSV without ngspice.
    Document display range vs sweep range in AGENTS.md.
2026-08-19 Regenerate AC/S11/CMRR/PSRR plots with 100 MHz–200 GHz display range
    [ac_diff.csv, ac_diff_vctrl_0p15.csv, ac_diff_vctrl_0p28.csv, ac_diff_vctrl_0p42.csv, ac_diff_vctrl_0p65.csv, ac_diff_vctrl_1p00.csv, isi_analysis.csv, metrics.csv]
2026-08-19 Re-draft layout plan: place foundry PCells, route with gdsfactory
    Devices now come from the PDK's own sg13g2_pycell_lib PCells rather than
    the ihp-gdsfactory cell library, with plain gdsfactory used only for
    composition and electrical routing.
    Rationale: ihp/cells/ are independent re-implementations built from
    design-rule constants, not wrappers around the foundry PCells. The PCells
    are the authoritative geometry, are what the LVS deck's device extraction
    is written against, and already work headless here, so placing them
    directly removes a class of drift. This also drops the XOR-vs-PCell gate
    that only existed to police that drift.
    On gdsfactoryplus: ihp-gdsfactory 2.0.0 declares it as Re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
2026-08-19 Add layout toolchain installer and single-device generators
    scripts/install-ihp-layout.sh installs the tools the PDK signoff decks need,
    following the PDK CI method: the KLayout version comes from the PDK's own
    versions.txt rather than being hardcoded, and the official .deb is preferred.
    klayout.org/klayout.de are blocked by this environment's egress policy, so the
    script falls back to a source build from GitHub, which is what ran here.
    -nolibgit2 drops KLayout's GUI package manager, which needs git2.h.
    Magic is pinned to 8.3.589 per versions.txt and netgen to 1.5.323; apt's magic
    is 8.3.105 (below the tech file's 8.3.573 floor) and apt's netgen is an
    unrelated mesh generator, so both are b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
2026-08-19 Gate the device catalog on the PDK DRC and LVS decks
    All 13 catalog devices are DRC-clean and LVS-clean with extracted geometry
    matching the DeviceSpec.
    Two classes of finding came out of actually running the decks.
    DRC: an isolated device cannot satisfy LU.b (latch-up needs a substrate tie
    within 20 um) or LBE.a (local-back-end minimum width is 100 um, a chip-area
    marker). Rather than assume, the same deck was run on the PDK's own device
    layouts under tech/lvs/testing/testcases/unit: sg13_lv_nmos trips LU.b 35
    times and inductor once, so a lone device tripping it is the foundry's own
    baseline. Those rules are now classified as CONTEXT_RULES, reported separately
    instead of dropped, and the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
2026-08-19 Prove PCell placement plus gdsfactory routing, and add the layout gate
    The routing spike is the step the plan could not verify up front: a foundry
    PCell GDS imported into gdsfactory, annotated with derived ports, and wired
    with route_bundle_electrical. layout/spike_routing.py does it on two rppd
    resistors and puts the result through the PDK DRC deck, which comes back clean
    with no context violations.
    Four gdsfactory details had to be worked out, all now encoded:
    - activate_pdk() must run before any other gdsfactory call, because gdsfactory
    resolves its default PDK from $PDK, which env.sh sets to ihp-sg13g2 for the
    SPICE flow and which is not an importable module.
    - Cross-sections regist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
    [layers.py, route.py, xsection.py]
2026-08-19 Add parasitic extraction and post-layout simulation
    Magic extracts R and C with the PDK extraction tech; klayout.pex provides an
    independent resistance check; ngspice then simulates schematic against extracted
    so the output is a cost, not a parasitic count.
    Results on the catalog: 13/13 devices extract, and the two extractors agree on
    the routed Metal1 wire to 0.6% (klayout.pex 22.350 ohm from square counting
    scaled by the ITF sheet resistance, Magic 22.486 ohm from its own deck). The
    square count is also independently sane: 203 squares for a ~32 um run of 0.16 um
    Metal1.
    Post-layout deltas that came out of it:
    - rppd load 86.71 -> 90.68 ohm (+4.6%), which is exactly the 2 x 1.98 ohm of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
2026-08-19 Add matched sub-blocks with guard rings, gated on enforced context rules
    Five blocks: the mirrored HBT differential pair, the shunt-peaked load pair, the
    degeneration R and C, the two mirrored tails, and the coil. All five pass DRC and
    LVS, and four of five are strictly clean with the latch-up rules enforced.
    That is the point of this stage. LU.b was a context violation at device level
    because a lone NMOS has no p-well tie within 20 um. The tail pair now carries a
    416-tap ptap1 ring and comes back with zero violations of any kind, so the rule
    is satisfied rather than waived. Only the coil still needs an allowance, for
    LBE.a alone: it has no active area for latch-up to constrain, but its loc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
2026-08-19 Build wide MOS as strapped arrays; fix LVS verdict parsing
    The LVS wrapper was reading the exit status, and run_lvs.py exits 0 even when
    the compare fails, so a mismatched netlist was reported as clean. The verdict now
    comes from the report text. That correction changes an earlier claim: the device
    catalog is 12/13 LVS-clean, not 13/13, and the failure is real.
    The failing device is the 243 um tail, and chasing it down established what the
    foundry nmos PCell does and does not provide, each measured against the deck:
    - ng > 1 draws fingers but no source/drain straps, so a 4-finger device extracts
    as four transistors in series rather than one wide device.
    - m > 1 changes nothing in the lay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
    [guard.py, lvs.py]
2026-08-19 Add the CTLE stage, AGENTS.md contracts and the regression runner
    The CTLE stage is placed symmetrically about a single axis with the two halves as
    exact mirror images. The coils are rotated to face each other (M135 left, R270
    right), which puts both supply feeds at the same height so vdd is one straight
    TopMetal2 strap, with the nlp feeds below it dropping straight onto the loads.
    That also shrank the cell from 330 x 176 um to 242 x 135 um. The guard ring
    covers the active rows and stops below the coils, since a substrate ring around
    an inductor is wrong on its own terms.
    Two more geometry bugs the decks caught along the way:
    - Route widths were a hand-written table with TopMetal1 at 1.50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
    [rules.py, xsection.py]
2026-08-19 Take independent sources out of the CTLE netlist; vss and mgate become pins
    The netlist used for layout and the netlist used for simulation have to be the
    same cell, and they were not: the layout CDL had no bias diode, and the
    simulation netlist had three elements that cannot exist in layout.
    ctle_pdk.cir and ctle_ideal.cir now contain devices only:
    - Iref moves to the testbench, so mgate becomes a pin. A cell that is going to
    be laid out can only hold devices; an ideal current source belongs to whatever
    instantiates it, which is the testbench for a standalone stage and the chain
    when the stage is cascaded.
    - Vs1 and Vs2 are gone. They were 0 V sources tying the HBT substrate termina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
2026-08-19 Add schematic/layout parity checking and make the tail width drawable
    layout/common/parity.py compares the simulation subcircuit against the layout
    CDL: it resolves the schematic's {TOKEN} parameters, reduces both sides to
    devices keyed by model and geometry, and reports what only one side has. LVS only
    ever compares layout against CDL, so nothing was checking the CDL against the
    schematic, which is how the layout came to be missing the bias diode.
    ind_shunt to inductor is the single permitted substitution, spelled out in
    MODEL_ALIASES, because the PDK has no ngspice inductor model. Everything else has
    to agree device for device.
    size_ctle.py now snaps the tail width onto the grid the layo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
    [ac_diff.csv, metrics.csv, summary.csv]
2026-08-19 Restructure the CTLE stage: EM-sized buses, a power ring and a real gate contact
    The stage is now DRC clean apart from the two chip-level LBE rules, which an
    isolated cell cannot satisfy. Every wire width comes from the technology LEF at
    the operating point rather than from a hand-picked number.
    New modules:
    - layout/common/em.py reads DCCURRENTDENSITY from sg13g2_tech.lef, the only
    machine-readable source of current limits in this PDK. It refuses to answer for
    a layer the PDK does not rate rather than treating silence as no limit, and
    records why Cont in particular cannot be checked.
    - layout/blocks/power_ring.py draws the vdd/vss ring: TopMetal2 horizontal,
    TopMetal1 vertical, To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
2026-08-19 Close the CTLE stage gates: parity, EM, DRC, LVS and PEX all pass
    Two connectivity bugs, both found by LVS rather than by looking:
    - The shared vss rail is much wider than one array's own source rail because it
    carries all three devices' current. Centred on that rail, the extra width
    reached up into the drain via columns, which start at the bottom of the active
    area. LVS reported e1, e2 and vss as one net with a single 729 um transistor.
    The rail now grows downward from the source rail instead.
    - The diode's drain-to-gate link was drawn a rail width outside the rail it was
    meant to land on, because the x came from the array's overall width rather than
    from its bounding box. The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
    [parity.py]
2026-08-19 Bring the tail_pair block onto the same EM sizing and netlist form as the stage
    build_mos_array now needs the current its rails carry, so tail_pair takes it too
    and gen_blocks passes ITAIL from params.inc.
    Two things the stage had already learned and this block had not:
    - Its CDL listed 25 unit devices per array. The extractor merges the drawn
    parallel units into one device of the total width, so one element per array is
    both correct and what the schematic says.
    - Its shared source rail was a hardcoded 1.0 um centred on the arrays' own rails.
    It is now sized from the LEF for both tails' current and grown downward, since
    centred it reaches into the drain via columns and shorts the d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
2026-08-19 Record the EM data source, the Cont gap and the netlist parity contract
    MEMORY.md gains the measured facts: where electromigration limits live and that
    there is no signoff deck for them, the per-layer values, that Cont has no stated
    limit so MOS contact EM is not checkable from open PDK data, and that minimum
    width beats EM by an order of magnitude on the top metals while the thin-metal
    buses are the opposite.
    Also the layout traps this work uncovered, each with what it cost: nothing with a
    substrate tie may sit inside a coil's 108 um footprint, the metal-finger cap's feed
    is on its edge rather than its centre, the nmos PCell has no gate contact at all, a
    shared supply rail must grow away f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
2026-08-19 Tighten the parity tolerance and fix the Magic version check
    Negative-testing the parity gate found it passing a case it must fail: one tail
    back at the undrawable 242.988 um. That is 4.9e-5 away from the drawn 243.000 um
    and the tolerance was 1e-4, so the check was looser than the deck it is meant to
    anticipate. At 1e-6 it rejects that while still absorbing what actually needs
    absorbing, which is representation rather than physics - 12.4252u against
    1.24252e-05.
    The gate now fails, as it should, on: a device missing from either side, an
    undrawable width, a pin order that differs, a coil drawn at a width the EM model
    was not fitted to, and a device swapped for a different model.
    The EM gat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
    [parity.py]
2026-08-19 Turn the coils to face each other, and bring the signals out to the cell edges
    Coil orientation is back to M135 and R270, so each coil's pins are on the edge
    nearest the axis with PLUS above MINUS: vdd is a short strap between two adjacent
    pins and each nlp leaves directly below its own vdd. Their 108 um bodies extend
    outward, leaving a channel down the middle for everything that has to cross the
    coil row.
    Facing them inward means each body now reaches as far down as it reaches up, and
    its pwell-block marker covers all of it. The pin row therefore sits a full
    half-height above the HBTs, whose substrate ties are the highest p-taps in the
    cell; that is what keeps PWB.f satisfied without givin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
2026-08-19 Record the coil-approach and HBT terminal findings
    Two things worth not rediscovering, both measured:
    - How you approach a coil pin changes its extracted geometry. The deck derives w, s
    and d from the winding inside ind_drw, and that marker covers the whole coil cell,
    so a perpendicular stub at the pin is measured as part of the winding: both coils
    came out at w=1.5 um, d=45 um against a drawn 4 um and 40 um. Rotation itself is
    harmless - a single M135 coil extracts at 4 um, as does a facing pair with a
    colinear strap - so the rule is to leave a pin colinear with its feed and turn
    only once clear of the marker.
    - The HBT stacks collector, emitter and base at one x with 0.23 um b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
2026-08-19 Make the committed layout artifacts reproducible
    run_all.sh regenerates everything and diffs against committed goldens, but that
    diff was never empty: three sources of run-to-run noise meant a real change had to
    be picked out of churn.
    - GDS records a modification and access date in every structure's BGNSTR. An
    otherwise identical re-run rewrote 176 bytes across the CTLE stage's 44 cells.
    KLayout's gds2_write_timestamps handles it; verified by XOR that the layouts were
    geometrically identical over all 56 layers before and after, so the bytes really
    were only dates.
    - The stored LVS summary carried the deck's wall-clock time and resident size ahead
    of the verdict. The verdict is th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
    [gds.py, lvs.py, pex.py]
2026-08-19 Extract flat: hierarchical Magic extraction produced negative capacitance
    The CTLE stage's PEX reported nine negative capacitors, worst -85 fF, on mgate, e1
    and e2 and on the array bus rails. Debugged with throwaway cells rather than by
    guessing, and it is neither of the obvious candidates.
    Not the device count: a bare strapped array is clean at 1, 5 and 25 units, with
    drain-to-substrate rising monotonically and staying positive (2.11, 12.22,
    65.72 fF), and a bare metal plate with no devices is positive too.
    Not our cthresh: holding the geometry fixed, cthresh 0, 0.01 and 1 all give
    byte-identical negatives.
    It is the hierarchy. Flat extraction gives zero negative terms. The negatives nam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
    [pex.py]
2026-08-19 Add the post-layout sim view: black-box list, wrapper, and a stage runner
    Three pieces, built by Composer 2.5 sub-agents and verified here.
    layout/common/simview.py holds the black-box list, keyed per kind: inductor,
    because the PDK has no ngspice inductor model and the authority is the EM-fitted
    ind_shunt, and cmomi, because the extractor reports finger-snapped geometry from an
    uncalibrated model rather than the calibrated cap_cmomi. Those are exactly the two
    entries already in run_pex.py's PEX_NOTES.
    The nets a black-boxed device touches have to become pins of the extracted
    subcircuit so a wrapper can reconnect the compact models, and promoted_nets()
    derives them from the instances rathe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
    [simview.py, stage_postlayout.py]
2026-08-19 Record the extraction findings and keep the sim view out of the tape-out path
    MEMORY.md gains the Stage 0 result and what came with it: extract flat or Magic
    reports negative capacitance, and the bisection that shows it is neither of the
    plausible causes; flat output has no .subckt at all; Magic's MOS as/ad/ps/pd cannot
    describe a strapped array so devices must come from the LVS extraction;
    pre_layout must be 0 once extracted areas are supplied; and the extracted netlist
    carries parameters the models reject.
    docs/LAYOUT.md gains a post-layout section covering both flows, why both take
    devices from LVS rather than from Magic, and the 0.6% of capacitance that is
    discarded when restricting to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
2026-08-19 Keep the extraction investigation as a reference under layout/debug_pex
    The negative-capacitance debug was done with throwaway scripts in /tmp, which threw
    away the reusable part. Both probes now live in the repo and run from there:
    - probe_unit_sweep.py builds the same cell at several sizes and watches one number.
    It tested and killed the hypothesis that the substrate term falls with device
    count.
    - probe_extract_settings.py holds the geometry fixed and varies only Magic's
    settings. It is what found the cause, and the same question - is it the geometry
    or is it how we asked - recurs every time an extraction looks wrong.
    Both resolve the repo root from __file__ rather than assuming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
2026-08-19 Add both post-layout flows, and fix two ways they were losing the layout
    Flow A takes devices from the KLayout LVS extraction; Flow B adds Magic's
    capacitance network on top of the same devices. Both wrap into a subcircuit with the
    schematic's seven pins, so stage_postlayout.py feeds them through the existing
    testbenches unchanged. run_postlayout.py gates the reduced view on LVS against the
    reduced CDL and refuses to emit a Magic netlist that is not physical.
    postlayout.py gains the parameter normaliser: it filters each element against the
    parameter list parsed from the model's own .subckt, forces pre_layout=0 on MOS since
    the core supplies extracted AS/AD/PS/PD, and rewrites R$/Q$/M$ prefi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
    [postlayout.py]
2026-08-19 Regenerate PEX artifacts for flat extraction and the physical gate
    Device-level numbers are unchanged - they were already flattened through
    write_for_magic - so those files gain only the physical and negative_capacitors
    fields. The CTLE stage's capacitance moves from 189 fF over 100 hierarchical
    capacitors to 762.71 fF over 34 flat ones, with physical true, which is the
    correction rather than a regression: the hierarchical figure was the one with nine
    negative terms subtracted out of it.
2026-08-19 Test the hierarchy claim properly: the 5x ratio was not the finding
    "Flat finds five times the capacitance" was a poor way to state it, and testing it
    on a minimal case shows why. One labelled NMOS in a subcell, instantiated N times in
    a top cell, extracted three ways:
    N sub alone N x sub top flat top hier (expanded) hier negatives
    1 2.607 fF 2.607 fF 2.607 fF 1.352 fF 2
    2 2.607 fF 5.215 fF 5.657 fF -2.068 fF 4
    4 2.607 fF 10.430 fF 11.757 fF -3.694 fF 8
    8 2.607 fF 20.859 fF 23.957 fF -6.945 fF 16
    Flat extraction is verifiably correct: at N=1 it equals the subcell extracted on its
    own t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
    [pex.py]
2026-08-19 Break the extracted capacitance down per net; withdraw the CL_INTERCONNECT claim
    Saying "CL_INTERCONNECT budgets 6.8 fF against the 493 fF the extraction finds"
    compared unrelated quantities. CL_INTERCONNECT is the routing allowance on an output
    node; 493 fF is a total over every net, which on a cell with a power ring is
    dominated by things that load no signal at all.
    probe_signal_net_caps.py splits it:
    between the supply nets and substrate only 134.78 fF 27.1%
    touching a signal net 55.24 fF 11.1%
    other internal nets (e1, e2, mgate, nlp) 306.42 fF 61.7%
    The largest single term is mgate-vss at 146.54 fF, the gate strap across 75 array
    devices, then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
2026-08-19 Put the post-layout flows in the regression and make their artifacts reproducible
    run_all.sh now builds both post-layout netlists after the stage. It adds about 10 s
    to a 68 s run, so it earns a place rather than being left as an opt-in script that
    nothing exercises.
    For its output to be committable it had to become deterministic, and it was not.
    Magic emits capacitors in a different order each run *and* the two terminals of a
    line in a different order within it, so identical geometry produced netlists
    differing only in `C0 mgate inp` versus `C0 inp mgate`. A capacitor is symmetric, so
    the whole line is now canonicalised - terminals sorted, lines sorted by net pair then
    value, indices renum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
2026-08-19 Mirror the tail device areas, recalibrate CL_INTERCONNECT, and converge the flows
    Two designer-directed fixes, and the three simulation views now agree.
    The input asymmetry is placement, as diagnosed. The tail arrays were placed as
    mirrored bounding boxes, but build_mos_array extends the cell box by the rail width
    on each side for the Metal2 bus overhang, so the two unit patterns ended up offset
    by 2 x rail_width rather than mirrored - putting inp over tail1's empty rail band
    and inn over tail2's devices. tail2 is now placed by mirroring tail1's device area,
    which derives the 5.76 um shift from the rail width rather than hardcoding it, so it
    tracks if the EM sizing changes the current. Extr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
    [ac_diff.csv, metrics.csv, summary.csv]
2026-08-19 Commit the post-layout simulation results and restore the schematic transients
    Both post-layout passes now write a full result set under
    circuits/ctle56n/out/postlayout_klayout/ and .../postlayout_magic/, alongside the
    existing out/ideal and out/pdk: AC gain and group delay, CMRR, PSRR, single-ended
    and differential transients, eye diagrams and SBR, plus metrics.csv and op.txt.
    Same layout and same file names as the schematic passes, so any two can be compared
    directly.
    Each pass picks its own load model from the netlist's declaration, which is printed
    on the run so the plots are never ambiguous about what was loaded: Flow A takes the
    full 33.59 fF CL because it carries no parasitics, Flow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
    [ac_diff.csv, eye_diff.csv, eye_se.csv, metrics.csv, sbr.csv, sbr_taps.csv, summary.csv, tran.csv]
2026-08-19 Add a post-layout comparison to the end of the CTLE report
    Puts the schematic and both extracted flows side by side on DC gain, peaking, peak
    gain, f_peak, f_-3dB, CMRR and the operating point, followed by what each flow
    carries and the extraction gate verdicts.
    The table states the lumped output load per column, because it is not the same
    across them and the numbers look inconsistent without it: a netlist carrying its own
    extracted routing takes the CL_MILLER term only, one without parasitics takes the
    full CL, and each netlist declares which it needs. It also records which two device
    kinds are replaced by compact models rather than extracted, and why.
    The metric prefix is derived from th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
2026-08-20 Split the CTLE stage's shared drawing and gate harness into their own modules
    draw.py holds the placement, via and trunk primitives every stage layout needs;
    stage_gates.py runs parity, EM, DRC, LVS and PEX and writes the JSON artifacts.
    ctle_stage.py keeps only its floorplan. The regenerated GDS and CDL are byte
    identical.
2026-08-20 Register the ESD diodes, the rail clamp and the bond pad as devices
    All four come from foundry PCells: esd carries the device in its model
    parameter, bondpad draws the pad stack. Element forms follow the deck's own
    esd_devices testcases. The bond pad is metal, not a device, so it emits no CDL
    element and LVS skips it. All 17 catalog devices are DRC clean and the 16 with
    a device class are LVS clean.
    [devices.py, wrap.py]
2026-08-20 Have the termination, VGA and driver sizers write committed include files
    size_ctle.py already writes params.inc, which is how layout reads a sized
    geometry without importing from circuits. The other three stages are about to
    be laid out and had no on-disk output at all. Each file is written from the
    same dataclass the parameter dict comes from, so the two cannot drift.
    [size_driver.py, size_term.py, size_vga.py]
2026-08-20 Bring the CTLE mirror gate out to the left cell edge
    mgate was a Metal1 contact in the channel between the bias diode and tail1,
    which a parent cell cannot reach. It now leaves on Metal4 under the ring, the
    way inp and outp already do. The gate contact itself does not move: the channel
    is where it has to be, because routing the gate over an array put Metal2 0.19 um
    from the drain stubs.
    Cell grows 344.5 -> 351.94 um wide. All five gates pass, PEX 35 C / 772 fF.
2026-08-20 Convert the termination, VGA and driver netlists to device-only cells
    Each stage is now the cell that gets laid out: sources moved to the testbench
    or to chain_dut, vss is a pin rather than the global 0, and the HBT substrate
    tie sources are gone.
    Three topology consequences, all real rather than cosmetic:
    - term_dut has four ports. The bond pad, the ESD diodes, the 50 ohm terminator
    and the route on to the CTLE are one net, so the 1 milliohm Rout_ser that
    used to separate them was a probe artifact, not a device.
    - The VGA's Rs was a 0.01 ohm placeholder, below anything rsil can build, so it
    is gone and the signal pair's emitters are one node. The dummy pair's stay
    separate: they h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
    [ac_diff.csv, ac_diff_buggy.csv, ac_diff_correct.csv, ac_diff_max.csv, ac_diff_mid.csv, ac_diff_min.csv, ac_diff_vctrl_0p15.csv, ac_diff_vctrl_0p28.csv]
2026-08-20 Catalogue the termination, VGA and driver devices, and stop folding Nx into m
    npn13G2's Nx is an extracted geometry parameter, not netlist multiplicity: the
    deck's own npn_adv.cdl testcase writes 'Nx=2 m=1' and extraction reports the
    same, so folding Nx into m made the driver's Nx=2 HBT fail LVS while Nx=1 hid
    it. Nx is now emitted, compared in extraction and compared in parity.
    The three new device lists read the sizers' include files, so no dimension is
    hardcoded. 26 devices DRC clean, 25 of 25 with an LVS class match.
    [devices.py, parity.py]
2026-08-20 vga_stage: layer-separated routing, trunk_net tx, guard ring fixes
    - Lower row: CTLE-style poly mgate strap and channel tap; vss rail spans lower row only
    - tx1/tx2: separate trunk_net Metal5 trunks outboard of steering pairs
    - em: continuous Metal5 strap with HBT emitters routed horizontally to outboard trunks
    - inp on Metal4; steerp/steern/vicm on Metal3 with gate verticals to port edge only
    - mgate exits on Metal4 above steering buses; dual guard rings with upper tap via TopMetal2
    - MOS bisection probe (--probe mos) for incremental LVS
2026-08-20 driver_stage: fix em/collector routing, pad placement, and bisect hooks
    - Add _collector_trunk_net to join collectors above the em Metal5 strap
    (trunk_net stubs at HBT collector y crossed em_y and merged outp into em)
    - Compute out trunks outboard of em bus extent (VGA-style margin)
    - Fix inboard/feeder x sign (was swapped); route pads from outboard feeder_x
    with TM2 entry only on the inboard edge
    - Place ESD cells outboard of pad_box.left/right, below pad bottom
    - Position bond pads outboard of coil vdd feeds using pad_cx_by_net
    - Add _ring_tie for clamp/ESD supplies (term_stage pattern)
    - Add bisect flags: with_pad_feed, with_esd; add bisect_lvs.py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
2026-08-20 driver_stage: drop unused trunk_net import
2026-08-20 driver_stage: LVS-clean net fixes, floored tail CDL, pad C breakdown
    Bisection-isolated mega-net causes (pad anchor, clamp/ESD ties, HBT vias,
    emitter bus corridor, collector trunks) are fixed. LVS report text matches.
    DRC still has Gat.d and clamp/ESD TM/V2-V4 clusters pending.
    Layout CDL uses _drawn_mos_total_w (783.68 µm) for LVS; parity waits on
    size_driver/snap_drawable_mos_w floor in circuits/ (784.075 µm schematic).
    Adds _pad_cap_breakdown() and stages driver_dut gate artifacts.
2026-08-20 driver_stage: classify m2_n PEX nodes as pad routing in cap breakdown
2026-08-20 driver_stage: refresh driver_dut_summary.json after pad C breakdown
2026-08-20 term_stage: fix pad feed DRC, supply routing, clamp LVS CDL order
    - Route bond pads via _via_chain at pad_stack_y (clears TM1.b)
    - Guard-ring tap on Metal2 at tap_y, not a Metal2 strap at vss_strap_y
    that crossed vdd_bus_x and merged vdd with vss
    - Clamp: bus-column taps; instances map VDD->vss/VSS->vdd so extracted
    nmoscl_2 terminal order matches the layout CDL
    - cmim MINUS: Metal5 strap plus M5/M4/M3 vias to vss bus (LVS still open)
    DRC clean; LVS fails on cap_cmim MINUS net still anonymous in extract.
2026-08-20 term_dut: ctle-style cmim legs, clamp CDL fix, LVS clean
    Route cap_cmim MINUS/PLUS with Metal5 and TopMetal1 legs from rbot_t
    (ctle_stage degen pattern) so mim plates merge vss/vtt in hierarchical
    LVS without terminal labels that created isolated nets.
    Restore clamp instance CDL mapping to VDD=vdd, VSS=vss (driver pattern);
    the swapped mapping broke LVS schematic alignment while extract stayed
    vss/vdd on A/C.
    Add inp/inn PEX pad-cap breakdown to main() output and summary JSON.
2026-08-20 Snap the VGA and driver MOS widths onto the array grid
    size_ctle.snap_drawable_mos_w already did this for the CTLE, because the deck
    compares MOS W and L with essentially no tolerance and a wide device is drawn
    as an array of single-finger units. The other two sizers emitted widths that
    only existed in the schematic. Gains move by 0.001 dB.
    [ac_diff.csv, ac_diff_max.csv, ac_diff_mid.csv, ac_diff_min.csv, ac_diff_vctrl_0p15.csv, ac_diff_vctrl_0p28.csv, ac_diff_vctrl_0p42.csv, ac_diff_vctrl_0p65.csv]
2026-08-20 Use the grid the nmos PCell actually draws on for MOS width
    The PCell resolves w onto 0.01 um by flooring, not the 5 nm both the sizing
    snap and mos_array.plan_units assumed: asking for 9.925 um draws 9.920 um of
    active. Three places disagreed about what was drawable, and the pad driver's
    layout said 783.68 um while its schematic said 784.075 um.
    plan_units and snap_drawable_mos_w now share the arithmetic, checked against
    each other by check_mos_w_grid.py, and catalog.py's local floor is gone. The
    CTLE is unaffected: 243 um is 25 x 9.72 and already on the grid, so params.inc
    and its GDS are byte-identical.
    [ac_diff.csv, ac_diff_vctrl_0p15.csv, ac_diff_vctrl_0p28.csv, ac_diff_vctrl_0p42.csv, ac_diff_vctrl_0p65.csv, ac_diff_vctrl_1p00.csv, gain_vs_vctrl.csv, gain_vs_vctrl_table.csv]
2026-08-20 driver_dut: parity, EM, LVS and PEX pass; 22 DRC violations remain
    Nine separate net merges fixed, found by bisecting the cell rather than reading
    it: the pad cell anchors on its centre so bottom-left placement overlapped the
    coils, full-width supply horizontals shorted vdd to vss, the clamp's vss run
    crossed the tail's Metal2 drain row, the HBT base and emitter via stacks landed
    1.13 um apart, and the shared em bus crossed the input trunks.
    Left: Gat.d on the mirror's gate strap and a via-stack cluster where the
    collector trunk and the ESD ring ties land.
2026-08-20 Record what this branch learned, and bring every AGENTS.md up to date
    The corrections that cost the most time: the nmos PCell resolves w onto 0.01 um
    by flooring rather than the 5 nm database grid, npn13G2's Nx is extracted
    geometry rather than netlist multiplicity, draw.trunk_net merges nets wherever
    its horizontal stubs share a y with something else, and an off-by-one column in
    an AC parse passes every low-frequency check because the imaginary parts are
    still near zero there.
2026-08-20 Add hierarchical CDL writing, and a probe for when the deck accepts it
    chain_subckt emits the sub-block definitions plus X calls for a top cell.
    probe_hier_lvs.py establishes the conditions: an X call onto a block sub-cell
    matches, the same call onto one-device sub-cells does not because the layout
    flattens them, the top cell name has to be passed, and each .SUBCKT name has to
    equal the GDS cell it stands for.
2026-08-20 Work in progress on the VGA and driver stage routing
    Both are structurally placed and parity-clean; the driver matches LVS with 22
    DRC violations left, the VGA does not yet match. Placement and routing are
    about to be redone from supplied floorplans, so this is the revert point.
2026-08-20 Document the stage floorplan template
    One floorplan for all four RX stages: symmetric about a vertical axis, out and
    vdd at the top edge, in at the bottom, ctrl and Iref at the left, vss inside the
    ring at the bottom.
    Two properties are what make it routable. The signal is a single straight column
    on the axis rather than trunks offset either side, and each load sits directly
    above its own transistor and below the coil strap, so the load column has no
    horizontal run. Device order within a row follows from the same rule: every net
    has to leave its device on that device's own x, because a horizontal run sharing
    a y with another net's riser is what has merged nets in every block so far.
    Co-aut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
2026-08-20 Add the pad band to the floorplan template
    Pads sit in their own band, separated from the core by a ring run. Pitch is
    130 um, so with 70 um pads the channel between them is 60 um: one ESD column per
    side just inboard of its own pad takes 26 um of that, and vdd, both out nets and
    vss run vertically down the remaining 34 um. The supplies reach the core through
    that channel rather than only around the ring, and the clamp sits on the axis at
    the outer edge tying the two rails together.
2026-08-20 WIP: mid-restructure onto the pad band template
    Snapshot taken while three sub-agents were still writing, so this is not a
    coherent state and is not a verified one. Against the last verified commit it
    regresses two blocks: term_dut was DRC clean with no waiver and LVS matching and
    is now neither, and driver_dut was LVS matching and is not.
    cce6d0f is the last point where every gate result in the tree was real.
2026-08-20 Pin the pad driver's row usage in the floorplan template
    It has no dummy devices and no control nets, so its pair row is the two
    transistors alone and its control channel carries only the in column and the
    tail current path. Its pad band is at the top because its pads are outputs; the
    termination's is at the bottom because its pads are the chip inputs.
2026-08-20 Restore the stage layouts to their last verified state
    Discards the mid-restructure snapshot from the cancelled sub-agents. term_dut is
    DRC clean with no waiver and LVS matching again, and driver_dut matches LVS with
    its 22 DRC violations.
2026-08-20 WIP: pad driver on the template floorplan, LVS not yet matching
    Real DRC violations drop from about 600 to 14 beyond the coil waiver and the
    cell shrinks to 489.9 x 337.0 um. Removing _collector_trunk_net took the whole
    V2/V3/V4 via cluster with it, which is what the template predicted: with each
    load directly above its own transistor the collector never runs horizontally.
    LVS regresses against the previous floorplan, which matched. The pad band merges
    vdd into vss once ESD, clamp and the channel supplies are all present.
    Also record why: a via stack draws metal on every layer it spans, so a supply
    vertical is a four-layer blockage wherever it changes level.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
2026-08-20 WIP: driver DRC down to two gate-strap violations, LVS still merging the rails
    Dedicated metals per channel vertical fixed the clamp path, and moving the ESD
    cells side by side outboard of each pad cleared PWB.f: they had been stacked at
    one x, reaching down into the guard region while the coil marker still covered
    it. The coil row now derives its height from the highest p-tap plus the rule
    rather than from the HBT bottom.
    Left: the ESD vdd and vss ring ties merge when both are present, and a re-run
    still rewrites the GDS.
2026-08-20 driver_stage: give the pad band its own power grid, ESD between the pads
    Three changes to the pad driver floorplan.
    A second power ring around the pad band. The clamp and the four ESD diodes
    were reaching down into the core ring; the clamp's vdd tie ran to the far
    right side of the cell. Both now tap a conductor a few um away. The two
    rings are stitched over the gap between them with TopMetal1 straps, vdd on
    the axis and vss either side of it, so a strap crosses the other net's
    TopMetal2 horizontals rather than routing around them. That also removes
    the pad-channel vss trunk, which was TopMetal2 running straight through the
    core ring's TopMetal2 vdd run — the short LVS was reporting.
    Pad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
2026-08-20 Drop the LVS bisection scratch that was committed under out/driver_stage
    1443 files: probe*/, bisect*/, check*/, lvs_*/, debug_*/, granular*/ and a
    handful of throwaway scripts, all output from bisecting the driver's LVS
    mismatch. out/driver_stage/ now holds the same six artifacts every other
    stage does. An extraction investigation worth keeping goes in
    layout/debug_pex/ with a findings note, per layout/AGENTS.md.
2026-08-20 driver_stage: close the last DRC and LVS failures; all five gates pass
    Four fixes on top of the two-ring rework.
    The output column cannot be extended past the load. The load's nlp pin sits
    directly above its outp pin and the via stack that takes nlp up to TopMetal2
    passes through Metal5, so the Metal5 pad feed at the column's own x shorted
    the resistor out — LVS reported nlp1|outp with both of R's terminals on one
    net. The riser now comes down OUT_FEED_DX inboard, inside the coil channel,
    and jogs across at the collector row.
    The ring-to-ring straps left the core ring's bottom vss port instead of its
    top one; PowerRing.ports is ordered [top, bottom, left, right]. Index 1 drew
    a TopMetal1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
2026-08-20 Record the pad band as it now is: two rings, ESD between the pads
    docs/LAYOUT.md gets the rewritten pad band section: 180 um pitch, the ESD
    column order and why it is diodevss below diodevdd, the band's own ring and
    how the two rings are stitched, Pad.fR as an exit length rather than a
    keepout, and why a pad feed cannot continue the output column past the load.
    The coil section records COIL_ACTIVE_GAP and what it costs in nlp.
    MEMORY.md gains the eight findings that generalise beyond this stage, and
    layout/blocks/AGENTS.md gains a pad driver section plus the guard-ring
    convention. driver_dut's row in the stage table is now clean across all five
    gates.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
2026-08-20 driver_stage: make _place_at's bottom argument required
    It is dereferenced unconditionally, so a default of None was a trap.
2026-08-20 Drop run_driver_stage.sh from the repo root
    Unreferenced, and it hardcodes /workspace and one machine's IHP_EDA_ROOT.
    Running a stage is two lines, documented in layout/AGENTS.md.
2026-08-20 vga_stage: rebuild onto the template floorplan; DRC clean, LVS still open
    The steering devices move out of the single MOS row into a row of their own
    above it, which is what the supplied floorplan asks for and what makes every
    net a short vertical between adjacent rails. From the schematic, a tail's
    drain is tx and a steering device's source is tx, and a mos_array puts its
    drain rail on top and its source rail on the bottom -- so with the rows
    stacked, tx1 is tail1's top rail meeting ps1's and pd1's bottom rails, and
    em/ed1/ed2 are the steering row's top rails facing the HBT emitters. None of
    those needs a horizontal at another array's x, which is the failure the old
    single row kept hitting.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
2026-08-20 vga_stage: close the five shorts; all five gates pass
    Every fault was a route crossing something on its own layer. Found by reading
    the extracted netlist's merged nets back to geometry rather than by guessing.
    mgate to substrate and tx1. The mirror gate was tapped on mdiode's right and
    rose to the port from there, so the rise ran up past the steering row at that
    x, through pd1's rails and the steering ring's taps. It now taps mdiode's
    left rail end-cap -- the side the port leaves on -- and goes straight out on
    Metal4 at the gate's own y, with no vertical inside either row.
    vss to mdiode's drain. The steering ring's substrate tie dropped at
    mos_left - 3.0 as if it were a thin wire; it is vs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
2026-08-20 Record the VGA's two-row floorplan and the five crossings that shorted it
    docs/LAYOUT.md gets the steering row and the argument from the schematic for
    why splitting the MOS row makes every net a vertical between adjacent rails,
    plus the collected list of run-sharing failures these blocks keep hitting:
    the two-nets-crossing-in-x rule and its lane order, a via stack shorting on
    the layers it passes through, a supply drop wider than its channel, and
    routing a bus on the side its device's pin faces.
    MEMORY.md gains the six that generalise. layout/blocks/AGENTS.md gains a VGA
    section and its row in the stage table is now clean across all five gates;
    layout/AGENTS.md drops the 'LVS still open' no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
2026-08-20 Send layout implementer sub-agents to Claude Sonnet 5 thinking
    Composer 2.5 stays the default implementer everywhere else; layout/ goes to
    claude-sonnet-5-thinking-high.
    The reason is that layout work is not mostly code generation. A stage is
    finished by diagnosis: reading an extracted netlist's merged nets back to
    geometry and working out which run crosses which, on what layer. Composer 2.5
    handled the first half well — on the VGA it produced a structurally
    reasonable two-row floorplan that passed parity, EM and DRC — but it did not
    reason through the five shorts it introduced along the way, and finding them
    fell to the coordinator and the user. That cost more than writing the routing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
2026-08-20 Add VGA and driver to the post-layout flow and run_all.sh
    Generalize run_postlayout.py with --stage {ctle,vga,driver}, rename LVS
    instances for those cells (including ESD D$ → X), and let stage_vga /
    stage_driver take an external DUT. run_all.sh now gates both stages and
    writes their post-layout netlists. Reports grow a comparison section
    when those artifacts exist. Layouts are unchanged.
2026-08-20 Record VGA and driver post-layout AC results
    Run schematic-vs-extracted DC/AC on the black-box VGA and pad-driver
    wrappers. KLayout matches schematic; Magic is the layout cost
    (VGA -0.5 dB / -6.6 GHz at 28 GHz, driver pad metal ~819 fF). Document
    the unlabeled tx1/tx2 C drop and keep one-flow rebuilds from wiping the
    other flow's summary.
    [ac_diff.csv, ac_diff_vctrl_0p15.csv, ac_diff_vctrl_0p28.csv, ac_diff_vctrl_0p42.csv, ac_diff_vctrl_0p65.csv, ac_diff_vctrl_1p00.csv, gain_vs_vctrl.csv, gain_vs_vctrl_table.csv]
2026-08-20 Add post-layout PRBS and SBR for VGA and pad driver
    Fill the eye rows the AC-only pass left blank. Driver Magic keeps the
    pad-metal C (~819 fF) and loses 0.038 UI of width; VGA Magic's BW drop
    does not close the mid-gain eye.
    [eye_diff.csv, eye_se.csv, metrics.csv, sbr.csv, sbr_max.csv, sbr_mid.csv, sbr_min.csv, sbr_taps.csv]
2026-08-20 Explain the driver 91-to-35 GHz post-layout bandwidth drop
    The schematic already includes ESD compact models. The gap is the pad:
    hand PAD_C is 27.7 fF of TM1 area-to-sub, Magic extracts 144 fF
    outp-vss. Sweeping schematic PAD_C to that value lands at 35.6 GHz
    against Magic's 34.88 GHz. Wiring is 3 fF.
2026-08-20 Extract the 70 um bond pad standalone: 80 fF, not 144 fF
    Magic C-only on the catalog bondpad_70um PCell alone is 80.45 fF to
    substrate. A TM2 vss ring at the driver's 6 um clearance adds 4 fF.
    The in-situ 144 fF outp-vss is the pad plus the pad band, not the
    stack by itself. Even a lone TM1 70 um plate extracts at 38 fF
    against the 27.7 fF area formula.
2026-08-20 Extract pad plus ESD columns: +21 fF, 42 fF still in the pad band
    An unconnected ESD column adds nothing to the isolated 80 fF pad.
    Tying it with the driver's Metal2 PAD bar adds 21 fF of extracted
    metal (101.6 fF pad–vss). The remaining 42 fF of the in-situ 144 fF
    is still the rest of the pad band, not the pad stack and not ESD
    junction C (already in both netlists).
2026-08-20 Retune pad driver to Magic pad C and Butterworth shunt L
    Driver schematic now uses Magic in-situ pad metal (143.56 fF PAD_C) and
    Butterworth m=0.414 shunt peaking, sizing EM case turn1 (~215 pH) into a
    separate ind_shunt_drv.inc. CTLE/VGA stay on Bessel m=0.32 in ind_shunt.inc.
    Extend size_ind.py with subckt_name and fallbacks for incomplete turn1 LUT
    (R_SERIES, C_PORT). Update chain/driver netlists, post-layout wrappers,
    reports, and AGENTS/MEMORY/PDK/LAYOUT/FINDINGS docs.
2026-08-20 Resimulate the driver after the Butterworth coil retune
    Schematic, KLayout and Magic now agree at 43.7 GHz and +0.07 dB
    at 28 GHz against the Magic pad metal (was 34.9 GHz / -1.67 dB
    with the 63 pH coil).
    [ac_diff.csv, drive_sweep.csv, eye_diff.csv, eye_se.csv, metrics.csv, nx_trade.csv, sbr.csv, sbr_taps.csv]
2026-08-20 Place the driver's turn1 coils: parity, DRC and LVS match
    Coil geometry now comes from ind_shunt_drv.inc (d=120 um), not
    catalog.COIL. Pin gap stays 44 um; the extra metal grows outboard.
    Cell height 392 → 470 um. CTLE/VGA coils are unchanged.
2026-08-20 Refresh driver post-layout sims and report after the turn1 coils
    Magic outp-vss is 152 fF on the taller cell (was 144 fF). Schematic
    stays 43.7 GHz / +0.07 dB; Magic is 42.2 GHz / -0.14 dB. Report and
    AGENTS.md now say layout and schematic coils match.
    [ac_diff.csv, eye_diff.csv, eye_se.csv, metrics.csv, sbr.csv, sbr_taps.csv, tran.csv, zin.csv]
